skdzicombd/P_240_Autocad_Docs/P240 building fire system/P240 -BOQ.xlsx

P240
SL .No | Description | Quantity | Unit | Unit Price | Total Price
 |  |  |  | (SGD) | (SGD)
 | Fire detection system
1 | Fire Alarm Master Panel | 1 | Set
 | Model:FN-4127/220V
2 | Intelligent Photoelectric Smoke Detector, with Base | 21 | Nos
 | Model: ALN-V,YBN-NSA-4
3 | Intelligent Heat Detector | 9 | Nos
 | Model: ATG-EA
4 | Addressable Manual Call Point | 9 | Nos
 | Model: DCP-AMS
5 | Horn & Strobe (wall mounted) | 10 | Nos
 | Model: HEC3-24WR
6 | Supervised Output Module : | 3 | Sets
 | Model: SOM-A
7 | Power Supply | 1 | Sets
 | Model: FN-600X-R (220V) (6 Amp max.)
8 | Commissioning of the whole system
 | 1 Hochiki And 1 Zicom Engineer
 | App 3 days per panel
Locally
SL .No | Description | Quantity | Unit | Unit Price | Total Price | Remarks | Brand
 |  |  |  | (BDT) | (BDT)
11 | Flame Retardant Signal Cable for initiating circuit and notification appliance |  | Meter | 23.42 |  | Red & Black | Paradise Cable Ltd
 | 1C X 1.5mm2 |  |  |  |  |  | BYA 1X1.5RM(FR)
12 | Power Cable for Fire & Annunciator Panel |  | Meter | 184.57 |  |  | Paradise Cable Ltd
 | 3CX2.5mm2 (Non-Armored) |  |  |  |  |  | NYY 3X2.5RM
13 | 20A MCB |  | No | 2000.00
14 | Accessories for Cable Laying
15 | 3/4 inch PVC Pipe |  | Meter | 20.00 |  |  | Electric pipe
16 | 3/4 inch hose pipe |  | Meter | 30.00
17 | Socket |  | Nos | 25.00
18 | Elbow |  | Nos | 30.00
19 | Sedel |  | Nos | 12.00
20 | 1” Screw |  | Dozen | 17.00
21 | Royal Plug |  | Packet | 14.00
22 | Transportation Cost
