skdzicombd/P_240_Autocad_Docs/BOQ/P-240 CABLE SIZING & BOQ 17.11.15.xlsx

Sheet: COVER
 |  |  |  |  |  | CONSORTIUM OF
 |  |  |  |  |  | SINOPEC PETROLEUM ENGINEERING CORPORATION.
 |  |  |  |  |  | AND
 |  |  |  |  |  | ZICOM EQUIPMENT PTE. LTD.
BANGLADESH PETROLEUM EXPLORATION & PRODUCTION CO. LTD.
 |  |  |  |  |  | 29 Tuas Avenue 3 Singapore 639420 |  |  | Tel | : +65 6865 1765
 |  |  |  |  |  | E-mail | : zepl@zicomgroup.com |  | Fax | : +65 6865 1764
ELECTRICAL CALCULATION SHEET
 |  |  |  |  |  |  |  | Doc. No:
 |  | Job No. |  | : | 240
 |  | Client |  | : | BANGLADESH PETROLEUM EXPLORATION & PRODUCTION CO. LTD.
 |  | Location |  | : | SRIKAIL GAS FIELD, BANGLADESH
 |  | Item No. |  | : | -
 |  | Description |  | : | ELECTRICAL LOAD CALCULATION
 |  | Project Title. |  | : | 60 MMSCFD SILICA GEL DEHYDRATION TYPE GAS PROCESS PLANT
 |  | Year Built |  | : | 2015
A | 2014-02-03 |  | 2 | ISSUED FOR BIDDING |  |  |  |  | MH | SM | RHK
Rev. | Date |  | Page | Description of Revision |  |  |  |  | Prepared | Checked | Approved

Sheet: Cable Sizing
 |  |  |  |  | CABLE SIZING
USER |  |  | BANGLADESH PETROLEUM EXPLORATION & PRODUCTION CO. LTD. |  |  |  | DOC NO. |  |  | REV :
LOCATION |  |  | SRIKAIL GAS FIELD, BANGLADESH |  |  |  | SERVICE
PROJECT |  |  | 60 MMSCFD SILICA GEL DEHYDRATION TYPE GAS PROCESS PLANT |  |  |  | TAG NO. | N/A
JOB NO. |  |  | 240 |  |  |  | QUANTITY | N/A
Sl.No | TAG NO. | DISCRIPTION |  |  | CABLE SIZE (sqmm) | FROM | TO | CABLE LENGTH (METER) | KW | Cable type | REMARKS
1 | G-01 | GENERATOR 01 |  |  | 1C X 150mm2 | G1 | MCC | 260 | 276 KW
2 | G-02 | GENERATOR 02 |  |  | 1C X 150mm2 | G2 | MCC | 300 | 276 KW
3 | G-03 | GENERATOR 03 |  |  | 1C X 150mm2 | G3 | MCC | 340 | 276 KW
 | MCC PANEL CONNECTION |  |  |  | 1C X 150mm2 | MCC 1 | MCC 2 | 100
4 | GRID | NATIONAL GRID LINE |  |  | 4C X 95mm2 | GRID LINE | MCC | 200
6 |  | SPARE-1-25A |  |  | 4C X 10mm2 |  |  | 100 | 14.7 KW
7 |  | SPARE-2-50A |  |  | 4C X 16mm2 |  |  | 100 | 29.44 KW
8 |  | SPARE-3-50A |  |  | 4C X 16mm2 |  |  | 100 | 29.44 KW
9 |  | SPARE-4-50A |  |  | 4C X 16mm2 |  |  | 100 | 29.44 KW
10 |  | SPARE-5-50A |  |  | 4C X 16mm2 |  |  | 100 | 29.44 KW
11 | C-501 | UTILITY AIR COMPRESSOR LOCAL CONTROL PANEL |  |  | 4C X 10mm2 | MCC | C-501 | 105 | 15 KW
12 | C-502 | UTILITY AIR COMPRESSOR LOCAL CONTROL PANEL |  |  | 4C X 10mm2 | MCC | C-502 | 105 | 15 KW
13 | C-503 | UTILITY AIR COMPRESSOR LOCAL CONTROL PANEL |  |  | 4C X10mm2 | MCC | C-503 | 105 | 15 KW
14 |  | DOMESTIC & OFFICE USE |  |  | 4C X 35mm2 | MCC | DOMESTIC & OFFICE USE | 320 | 50 KW
15 |  | GENERATOR & MCC ROOM DISTRIBUTION PANEL |  |  | 4C X 6mm2 | MCC | GENERATOR & MCC ROOM DISTRIBUTION PANEL | 40 | 10 KW
16 | P-100A | CONDENSATE TRANSFER PUMP |  |  | 4C X 4mm2 | MCC | P-100A | 260 | 5.5 KW
 | P-100B | CONDENSATE TRANSFER PUMP |  |  | 4C X 4mm2 | MCC | P-100B | 260
17 | P-100A-LCS | CONDENSATE TRANSFER PUMP-LCS |  |  | 12C X 1.5mm2 | MCC | P-100A-LCS | 260
 | P-100B-LCS | CONDENSATE TRANSFER PUMP-LCS |  |  | 12C X 1.5mm2 | MCC | P-100B-LCS | 260
18 | P-200A | COOLING WATER PUMP |  |  | 4C X 4mm2 | MCC | P-200A | 220 | 5.5 KW
 | P-200B | COOLING WATER PUMP |  |  | 4C X 4mm2 | MCC | P-200B | 220
19 | P-200A-LCS | COOLING WATER PUMP-LCS |  |  | 12C X 1.5mm2 | MCC | P-200A-LCS | 220
 | P-200B-LCS | COOLING WATER PUMP-LCS |  |  | 12C X 1.5mm2 | MCC | P-200B-LCS | 220
20 | E-100(1) | DRY AIR COOLER |  |  | 4C X 16mm2 | MCC | E-100(1) | 190 | 22 KW
 | E-100(1)-LCS | DRY AIR COOLER-LCS |  |  | 12C X 1.5mm2 | MCC | E-100(1)-LCS | 190
21 | E-100(2) | DRY AIR COOLER |  |  | 4C X 16mm2 | MCC | E-100(2) | 190 | 22 KW
 | E-100(2)-LCS | DRY AIR COOLER-LCS |  |  | 12C X 1.5mm2 | MCC | E-100(2)-LCS | 190
22 | E-100(3) | DRY AIR COOLER |  |  | 4C X 10mm2 | MCC | E-100(3) | 200 | 15 KW
 | E-100(3)-LCS | DRY AIR COOLER-LCS |  |  | 12C X 1.5mm2 | MCC | E-100(3)-LCS | 200
23 | E-100(4) | DRY AIR COOLER |  |  | 4C X 10mm2 | MCC | E-100(4) | 200 | 15 KW
 | E-100(4)-LCS | DRY AIR COOLER-LCS |  |  | 12C X 1.5mm2 | MCC | E-100(4)-LCS | 200
24 | E-300A(1) | REGENERATION GAS COOLER |  |  | 4C X 16mm2 | MCC | E-300A(1) | 210 | 22 KW
 | E-300A(1)-LCS | REGENERATION GAS COOLER-LCS |  |  | 12C X 1.5mm2 | MCC | E-300A(1)-LCS | 210
25 | E-300A(2) | REGENERATION GAS COOLER |  |  | 4C X 10mm2 | MCC | E-300A(2) | 210 | 15 KW
 | E-300A(2)-LCS | REGENERATION GAS COOLER-LCS |  |  | 12C X 1.5mm2 | MCC | E-300A(2)-LCS | 210
26 | E-300B(1) | REGENERATION GAS COOLER |  |  | 4C X 16mm2 | MCC | E-300B(1) | 190 | 22 KW
 | E-300B(1)-LCS | REGENERATION GAS COOLER-LCS |  |  | 12C X 1.5mm2 | MCC | E-300B(1)-LCS | 190
27 | E-300B(2) | REGENERATION GAS COOLER |  |  | 4C X 10mm2 | MCC | E-300B(2) | 190 | 15 KW
 | E-300B(2)-LCS | REGENERATION GAS COOLER-LCS |  |  | 12C X 1.5mm2 | MCC | E-300B(2)-LCS | 190
28 | E-400A(1) | COOLING GAS COOLER |  |  | 4C X 16mm2 | MCC | E-400A(1) | 200 | 22 KW
 | E-400A(1)-LCS | COOLING GAS COOLER-LCS |  |  | 12C X 1.5mm2 | MCC | E-400A(1)-LCS | 200
29 | E-400A(2) | COOLING GAS COOLER |  |  | 4C X 10mm2 | MCC | E-400A(2) | 200 | 15 KW
 | E-400A(2)-LCS | COOLING GAS COOLER-LCS |  |  | 12C X 1.5mm2 | MCC | E-400A(2)-LCS | 200
30 | E-400B(1) | COOLING GAS COOLER |  |  | 4C X 16mm2 | MCC | E-400B(1) | 200 | 22 KW
 | E-400B(1)-LCS | COOLING GAS COOLER-LCS |  |  | 12C X 1.5mm2 | MCC | E-400B(1)-LCS | 200
31 | E-400B(2) | COOLING GAS COOLER |  |  | 4C X 10mm2 | MCC | E-400B(2) | 200 | 15 KW
 | E-400B(2)-LCS | COOLING GAS COOLER-LCS |  |  | 12C X 1.5mm2 | MCC | E-400B(2)-LCS | 200
32 | P-800 | KOD PUMP |  |  | 4C X 2.5mm2 | MCC | P-800 | 210 | 3 KW
 | P-800-LCS | KOD PUMP-LCS |  |  | 12C X 1.5mm2 | MCC | P-800-LCS | 210
33 | CT-100 | WET COOLER |  |  | 4C X 6mm2 | MCC | CT-100 | 210 | 11 KW
 | CT-100-LCS | WET COOLER-LCS |  |  | 12C X 1.5mm2 | MCC | CT-100-LCS | 210
34 | V-502A/B | AIR DRYER |  |  | 3C X 2.5mm2 | MCC | V-502A/B | 105 | 1 KW
35 | V-503A/B | AIR DRYER |  |  | 3C X 2.5mm2 | MCC | V-503A/B | 105 | 1 KW
36 | LCP-0801 | FLARE STACK LOCAL CONTROL PANEL |  |  | 4CX 2.5mm2 | MCC | FLARE STACK LOCAL CONTROL PANEL | 180 | 3 KW
 |  | FLARE PANEL |  |  | 3CX 2.5mm2 | FLARE LOCALCONTROL PANEL | FLARE PANEL | 40
 |  | BURN PIT PANEL |  |  | 3CX 2.5mm2 | FLARE LOCALCONTROL PANEL | BURN PIT PANEL | 40
37 | H-100 | WATER BATH HEATER |  |  | 4CX 2.5mm2 | MCC | CONTROL BUILDING | 300 | 6 KW
 |  | INSTRUMENT CABLE |  |  | 24CX 1.5mm2 | CONTROL BUILDING | H-100 | 205
 |  | INSTRUMENT CABLE |  |  | 12CX 1.5mm2 | CONTROL BUILDING | H-100 | 205
 |  | BLOWER FOR WBH |  |  | 4CX 2.5mm2 | CONTROL BUILDING | H-100 | 205
38 | H-200 | REGENERATION GAS HEATER |  |  | 4CX 2.5mm2 | MCC | CONTROL BUILDING | 300 | 6 KW
39 | P-403 | DEEP WELL PUMP |  |  | 4C X 6mm2 | MCC | P-403 | 360 | 11 KW
 | P-403-LCS | DEEP WELL PUMP -LCS |  |  | 12C X 1.5mm2 | MCC | P-403-LCS | 360
 |  | PUMP TO CONTROL PANEL(Flat Cable) |  |  | 2 (3C x 4 mm2) | PUMP CONTROL PANEL | PUMP | 500 |  | Dhaka
40 | P-404 | POTABLE WATER PUMP |  |  | 4C X 2.5mm2 | MCC | P-404 | 350 | 0.75 KW
 | P-404-LCS | POTABLE WATER PUMP-LCS |  |  | 12C X 1.5mm2 | MCC | P-404-LCS | 350
41 | P-401A | JOCKEY PUMP CONTROL PANEL |  |  | 4C X 10mm2 | MCC | P-401A | 330 | 18 KW
 | P- 401B | JOCKEY PUMP CONTROL PANEL |  |  | 4C X 10mm2 | MCC | P-401B | 330 | 18 KW
42 | P-402A | DIESEL FIRE WATER PUMP CONTROL PANEL |  |  | 4C X 2.5mm2 | MCC | P-402A | 330 | 3 KW
43 | P-402B | DIESEL FIRE WATER PUMP CONTROL PANEL |  |  | 4C X 2.5mm2 | MCC | P-402B | 330 | 3 KW
44 | P-300A | CONDENSATE RECYCLE PUMP |  |  | 4CX 2.5mm2 | MCC | P-300A | 330 | 0.75 KW
 | P-300B | CONDENSATE RECYCLE PUMP |  |  | 4CX 2.5mm2 | MCC | P-300B | 330
 | P-300A-LCS | CONDENSATE RECYCLE PUMP-LCS |  |  | 12CX1.5mm2 | MCC | P-300A-LCS | 330
 | P-300B-LCS | CONDENSATE RECYCLE PUMP-LCS |  |  | 12CX1.5mm2 | MCC | P-300B-LCS | 330
45 | P-301A | TREATED WATER TRANSFER PUMP |  |  | 4CX 2.5mm2 | MCC | P-301A | 330 | 0.75 KW
 | P-301B | TREATED WATER TRANSFER PUMP |  |  | 4CX 2.5mm2 | MCC | P-301B | 330
 | P-301A-LCS | TREATED WATER TRANSFER PUMP-LCS |  |  | 12CX1.5mm2 | MCC | P-301A-LCS | 330
 | P-301B-LCS | TREATED WATER TRANSFER PUMP-LCS |  |  | 12CX1.5mm2 | MCC | P-301B-LCS | 330
 | 02-GBC-1401 | GENERATOR BATTERY CHARGER |  |  | 3CX 4mm2 | MCC | 02-GBC-1401 | 30 | 1.5 KW
47 | 02-UPS-1201-I | UPS SYSTEM 1 |  |  | 3CX 4mm2 | MCC | UPS-1 | 300 | 6 KVA
 | 02-UPS-1202-I | UPS SYSTEM 2 |  |  | 3CX 4mm2 | MCC | UPS-2 | 300 | 6 KVA
 | 02-UPS-1201-I & 02-UPS-1202-I | UPS-1&2-DB |  |  | 3CX 4mm2 | UPS-1&2 | UPS-1&2-DB | 10
 |  | DCS PANEL |  |  | 3CX 2.5mm2 | UPS-1&2 | DCS PANEL | 70 | 400W
 |  | ENGINEERING STATION |  |  | 3CX 2.5mm2 | UPS-1&2 | ENGINEERING STATION | 50 | 400W
 |  | OPERATOR STATION 1 |  |  | 3CX 2.5mm2 | UPS-1&2 | OPERATOR STATION | 50 | 400W
 |  | OPERATOR STATION 2 |  |  | 3CX 2.5mm2 | UPS-1&2 | OPERATOR STATION | 50 | 400W
 |  | SAFETY PLC SYSTEM |  |  | 3CX 2.5mm2 | UPS-1&2 | SAFETY PLC | 20
 |  | 75" MONITOR -1 |  |  | 3CX 2.5mm2 | UPS-1&2 | 75" MONITOR -1 | 50 | 400W
 |  | 75" MONITOR -2 |  |  | 3CX 2.5mm2 | UPS-1&2 | 75" MONITOR -2 | 50 | 400W
 |  | FIELD I/O ( RIO - 0001A) |  |  | 3CX 2.5mm2 | UPS-1&2 | FIELD I/O ( RIO - 0001A) | 80 | 250W
 |  | FIELD I/O ( RIO - 0001B) |  |  | 3CX 2.5mm2 | UPS-1&2 | FIELD I/O ( RIO - 0001B) | 80 | 250W
 |  | FIELD I/O ( RIO - 0001C) |  |  | 3CX 2.5mm2 | UPS-1&2 | FIELD I/O ( RIO - 0001C) | 80 | 250W
 |  | FIELD I/O ( RIO - 0002A) |  |  | 3CX 2.5mm2 | UPS-1&2 | FIELD I/O ( RIO - 0002A) | 80 | 250W
 |  | FIELD I/O ( RIO - 0002B) |  |  | 3CX 2.5mm2 | UPS-1&2 | FIELD I/O ( RIO - 0002B) | 230 | 250W
 |  | MCC I/O ( RIO - 0003) |  |  | 3CX 2.5mm2 | UPS-1&2 | MCC I/O ( RIO - 0003) | 280 | 250W
 |  | F&G UPS - 1KVA |  |  | 3CX 2.5mm2 | UPS-1&2 | F&G UPS(UPS-3) | 20 | 1KW
 |  | PAGING & INTERCOM SYSTEM |  |  | 3CX 2.5mm2 | UPS-1&2 | PAGING | 30 | 50W
 |  | WATER BATH HEATER |  |  | 3CX 2.5mm2 | UPS-1&2 | WATER BATH HEATER | 40 | 200W
 |  | LCP ( REGENERATION GAS HEATER) |  |  | 3CX 2.5mm2 | UPS-1&2 | LCP ( REGENERATION GAS HEATER) | 40 | 200W
 |  | FLOW COMPUTER PANEL |  |  | 3CX 2.5mm2 | UPS-1&2 | FLOW COMPUTER PANEL | 50 | 52W
 |  | CCTV CAMERA |  |  | 3CX 2.5mm2 | UPS-1&2 | CCTV CAMERA | 350 | 100W
 |  | CCTV CAMERA |  |  | 3CX 2.5mm2 | UPS-1&2 | CCTV CAMERA | 350 | 100W
 |  | CCTV CAMERA |  |  | 3CX 2.5mm2 | UPS-1&2 | CCTV CAMERA | 50 | 100W
 |  | DVR NETWORKABLE |  |  | 3CX 2.5mm2 | UPS-1&2 | DVR NETWORKABLE | 50 | 68W
 |  | PRINTER |  | 1 & 2 | 3CX 2.5mm2 | UPS-1&2 | PRINTER | 50 | 150W
 |  | FIRE & GAS SYSTEM |  |  | 3CX 2.5mm2 | UPS-1&2-DB | FIRE & GAS SYSTEM | 30 | 250W
 |  | FLARE CONTROL PANEL |  |  | 3CX 2.5mm2 | UPS-1&2-DB | FLARE CONTROL PANEL | 350 | 40W
 |  | POWER CABLE FOR GC |  |  | 3CX 2.5mm2 | UPS | GC | 180 | 45W
 |  | UPS-3 |  |  | 3CX 2.5mm2 | UPS-1&2-DB | UPS-3 | 20 | 1 KW
48 | 02-UPS-1203-I | UPS-3-DB |  |  | 3CX 2.5mm2 | UPS-3 | UPS-3-DB | 10 | 100W
 |  | FIRE PANEL |  |  | 3CX 2.5mm2 | UPS-3-DB | FIRE PANEL | 40 | 50W
 |  | FIRE MIMIC PANEL |  |  | 3CX 2.5mm2 | UPS-3-DB | FIRE MIMIC PANEL | 20 | 200W
 |  | ALARM SYSTEM |  |  | 3CX 2.5mm2 | UPS-3-DB | ALARM SYSTEM | 20 | 140W
 |  | POWER SUPPLY |  |  | 3CX 2.5mm2 | UPS-3-DB | POWER SUPPLY | 10 | 18 KW
50 | LDP-1401-I | LIGHTING DISTRIBUTION PANEL |  |  | 4C X 16mm2 | MCC | LIGHT PANEL | 20 | 18 KW
 |  | TELECSCOPIC TOWER -1 |  |  | 3C X 2.5mm2 | LIGHT PANEL | TELECSCOPIC TOWER -1 | 150 | 1.2 KW
 |  | TELECSCOPIC TOWER -2 |  |  | 3C X 2.5mm2 | LIGHT PANEL | TELECSCOPIC TOWER -2 | 190 | 1.2 KW
 |  | TELECSCOPIC TOWER -3 |  |  | 3C X 2.5mm2 | LIGHT PANEL | TELECSCOPIC TOWER -3 | 220 | 1.2 KW
 |  | PIPE RACK LIGHT-1 |  |  | 3C X 2.5mm2 | LIGHT PANEL | PIPE RACK LIGHT-1 | 160 | 0.7 KW
 |  | PIPE RACK LIGHT-2 |  |  | 3C X 2.5mm2 | LIGHT PANEL | PIPE RACK LIGHT-2 | 170 | 0.5 KW
 |  | STREET LIGHT -1 |  |  | 3C X 2.5mm2 | LIGHT PANEL | STREET LIGHT -1 | 150 | 0.45 KW
 |  | STREET LIGHT -2 |  |  | 3C X 2.5mm2 | LIGHT PANEL | STREET LIGHT -2 | 70 | 0.45 KW
 |  | INSTRUMENT AIR AREA SHED LIGHT |  |  | 3C X 2.5mm2 | LIGHT PANEL | INSTRUMENT AIR AREA SHED LIGHT | 105 | 0.036 KW
 |  | TRANSFER PUMP SHED LIGHT |  |  | 3C X 2.5mm2 | LIGHT PANEL | TRANSFER PUMP SHED LIGHT | 250 | 0.036 KW
 |  | DELUGE VALVE SHED LIGHT |  |  | 3C X 2.5mm2 | LIGHT PANEL | DELUGE VALVE SHED LIGHT | 330 | 0.036 KW
 |  | FIRE WATER SHED LIGHT |  |  | 3C X 2.5mm2 | LIGHT PANEL | FIRE WATER SHED LIGHT | 330 | 0.036 KW
 |  | LOADING ARM SHED LIGHT |  |  | 3C X 2.5mm2 | LIGHT PANEL | LOADING ARM SHED LIGHT | 200 | 0.4 KW
 |  | AIR CRAFT WARNING LIGHT |  |  | 3C X 2.5mm2 | LIGHT PANEL | AIR CRAFT WARNING LIGHT | 300 | 0.05 KW
A
REV | DATE |  |  | DESCRIPTION OF REVISION |  |  |  | PREPARED | CHECKED | APPROVED

Sheet: Cable length details
 |  |  |  |  | CABLE LENGTH DETAILS
USER |  |  | BANGLADESH PETROLEUM EXPLORATION & PRODUCTION CO. LTD. |  |  |  | DOC NO. |  |  | REV :
LOCATION |  |  | SRIKAIL GAS FIELD, BANGLADESH |  |  |  | SERVICE
PROJECT |  |  | 60 MMSCFD SILICA GEL DEHYDRATION TYPE GAS PROCESS PLANT |  |  |  | TAG NO. | N/A
JOB NO. |  |  | 240 |  |  |  | QUANTITY | N/A
Sl.No | TAG NO. | DISCRIPTION |  |  | CABLE SIZE (sqmm) | FROM | TO | CABLE LENGTH (METER) |  | Cable type | REMARKS
 | G-01 | GENERATOR 01 |  |  | 1C X 150mm2 | G1 | MCC | 260
 | G-02 | GENERATOR 02 |  |  | 1C X 150mm2 | G2 | MCC | 300
 | G-03 | GENERATOR 03 |  |  | 1C X 150mm2 | G3 | MCC | 340
 | MCC PANEL CONNECTION |  |  |  | 1C X 150mm2 | MCC 1 | MCC 2 | 100
 |  | TOTAL |  |  | 1C X 150mm2 |  |  | 1000
 | GRID | NATIONAL GRID LINE |  |  | 4C X 95mm2 | GRID LINE | MCC | 200
 |  | SPARE-1-25A |  |  | 4C X 10mm2 |  |  | 100
 | C-501 | UTILITY AIR COMPRESSOR LOCAL CONTROL PANEL |  |  | 4C X 10mm2 | MCC | C-501 | 105
 | C-502 | UTILITY AIR COMPRESSOR LOCAL CONTROL PANEL |  |  | 4C X 10mm2 | MCC | C-502 | 105
 | C-503 | UTILITY AIR COMPRESSOR LOCAL CONTROL PANEL |  |  | 4C X10mm2 | MCC | C-503 | 105
 | E-300A(2) | REGENERATION GAS COOLER |  |  | 4C X 10mm2 | MCC | E-300A(2) | 210
 | E-100(4) | DRY AIR COOLER |  |  | 4C X 10mm2 | MCC | E-100(4) | 200
 | E-300B(2) | REGENERATION GAS COOLER |  |  | 4C X 10mm2 | MCC | E-300B(2) | 190
 | E-100(3) | DRY AIR COOLER |  |  | 4C X 10mm2 | MCC | E-100(3) | 200
 | E-400A(2) | COOLING GAS COOLER |  |  | 4C X 10mm2 | MCC | E-400A(2) | 200
 | E-400B(2) | COOLING GAS COOLER |  |  | 4C X 10mm2 | MCC | E-400B(2) | 200
 | P-401A | JOCKEY PUMP CONTROL PANEL |  |  | 4C X 10mm2 | MCC | P-401A | 330
 | P- 401B | JOCKEY PUMP CONTROL PANEL |  |  | 4C X 10mm2 | MCC | P-401B | 330
 |  | TOTAL |  |  | 4C X10mm2 |  |  | 2275
 |  | SPARE-2-50A |  |  | 4C X 16mm2 |  |  | 100
 |  | SPARE-3-50A |  |  | 4C X 16mm2 |  |  | 100
 |  | SPARE-4-50A |  |  | 4C X 16mm2 |  |  | 100
 |  | SPARE-5-50A |  |  | 4C X 16mm2 |  |  | 100
 | E-100(1) | DRY AIR COOLER |  |  | 4C X 16mm2 | MCC | E-100(1) | 190
 | E-100(2) | DRY AIR COOLER |  |  | 4C X 16mm2 | MCC | E-100(2) | 190
 | E-300A(1) | REGENERATION GAS COOLER |  |  | 4C X 16mm2 | MCC | E-300A(1) | 210
 | E-300B(1) | REGENERATION GAS COOLER |  |  | 4C X 16mm2 | MCC | E-300B(1) | 190
 | E-400A(1) | COOLING GAS COOLER |  |  | 4C X 16mm2 | MCC | E-400A(1) | 200
 | E-400B(1) | COOLING GAS COOLER |  |  | 4C X 16mm2 | MCC | E-400B(1) | 200
 |  | LIGHTING DISTRIBUTION PANEL |  |  | 4C X 16mm2 | MCC | LIGHT PANEL | 20
 |  | TOTAL |  |  | 4C X 16mm2 |  |  | 1600
 |  | DOMESTIC & OFFICE USE |  |  | 4C X 35mm2 | MCC | DOMESTIC & OFFICE USE | 320
 |  | TOTAL |  |  | 4C X 35mm2 |  |  | 320
 | P-403 | DEEP WELL PUMP |  |  | 4C X 6mm2 | MCC | P-403 | 360
 | CT-100 | WET COOLER |  |  | 4C X 6mm2 | MCC | CT-100 | 210
 |  | GENERATOR & MCC ROOM DISTRIBUTION PANEL |  |  | 4C X 6mm2 | MCC | GENERATOR & MCC ROOM DISTRIBUTION PANEL | 40
 |  | TOTAL |  |  | 4C X 6mm2 |  |  | 610
 | P-200A | COOLING WATER PUMP |  |  | 4C X 4mm2 | MCC | P-200A | 220
 | P-200B | COOLING WATER PUMP |  |  | 4C X 4mm2 | MCC | P-200B | 220
 | P-100A | CONDENSATE TRANSFER PUMP |  |  | 4C X 4mm2 | MCC | P-100A | 260
 | P-100B | CONDENSATE TRANSFER PUMP |  |  | 4C X 4mm2 | MCC | P-100B | 260
 |  | TOTAL |  |  | 4C X 4mm2 |  |  | 960
 | P-402B | DIESEL FIRE WATER PUMP CONTROL PANEL |  |  | 4C X 2.5mm2 | MCC | P-402B | 330
 | P-300A | CONDENSATE RECYCLE PUMP |  |  | 4CX 2.5mm2 | MCC | P-300A | 330
 | P-300B | CONDENSATE RECYCLE PUMP |  |  | 4CX 2.5mm2 | MCC | P-300B | 330
 | H-100 | BLOWER FOR WBH |  |  | 4CX 2.5mm2 | CONTROL BUILDING | H-100 | 205
 | H-100 | WATER BATH HEATER |  |  | 4CX 2.5mm2 | MCC | CONTROL BUILDING | 300
 | LCP-0801 | FLARE STACK LOCAL CONTROL PANEL |  |  | 4CX 2.5mm2 | MCC | FLARE STACK LOCAL CONTROL PANEL | 180
 | P-800 | KOD PUMP |  |  | 4C X 2.5mm2 | MCC | P-800 | 210
 | P-402A | DIESEL FIRE WATER PUMP CONTROL PANEL |  |  | 4C X 2.5mm2 | MCC | P-402A | 330
 | P-404 | POTABLE WATER PUMP |  |  | 4C X 2.5mm2 | MCC | P-404 | 350
 | P-301A | TREATED WATER TRANSFER PUMP |  |  | 4CX 2.5mm2 | MCC | P-301A | 330
 | P-301B | TREATED WATER TRANSFER PUMP |  |  | 4CX 2.5mm2 | MCC | P-301B | 330
 | H-200 | REGENERATION GAS HEATER |  |  | 4CX 2.5mm2 | MCC | CONTROL BUILDING | 300
 |  | TOTAL |  |  | 4CX 2.5mm2 |  |  | 3525
 | H-100 | INSTRUMENT CABLE |  |  | 24CX 1.5mm2 | CONTROL BUILDING | H-100 | 205
 |  | TOTAL |  |  | 24CX 1.5mm2 |  |  | 205
 | E-300A(2)-LCS | REGENERATION GAS COOLER-LCS |  |  | 12C X 1.5mm2 | MCC | E-300A(2)-LCS | 210
 | E-300B(1)-LCS | REGENERATION GAS COOLER-LCS |  |  | 12C X 1.5mm2 | MCC | E-300B(1)-LCS | 190
 | E-100(4)-LCS | DRY AIR COOLER-LCS |  |  | 12C X 1.5mm2 | MCC | E-100(4)-LCS | 200
 | E-300A(1)-LCS | REGENERATION GAS COOLER-LCS |  |  | 12C X 1.5mm2 | MCC | E-300A(1)-LCS | 210
 | E-400B(2)-LCS | COOLING GAS COOLER-LCS |  |  | 12C X 1.5mm2 | MCC | E-400B(2)-LCS | 200
 | E-300B(2)-LCS | REGENERATION GAS COOLER-LCS |  |  | 12C X 1.5mm2 | MCC | E-300B(2)-LCS | 190
 | E-400A(1)-LCS | COOLING GAS COOLER-LCS |  |  | 12C X 1.5mm2 | MCC | E-400A(1)-LCS | 200
 | E-400A(2)-LCS | COOLING GAS COOLER-LCS |  |  | 12C X 1.5mm2 | MCC | E-400A(2)-LCS | 200
 | E-400B(1)-LCS | COOLING GAS COOLER-LCS |  |  | 12C X 1.5mm2 | MCC | E-400B(1)-LCS | 200
 | P-800-LCS | KOD PUMP-LCS |  |  | 12C X 1.5mm2 | MCC | P-800-LCS | 210
 | CT-100-LCS | WET COOLER-LCS |  |  | 12C X 1.5mm2 | MCC | CT-100-LCS | 210
 | P-100A-LCS | CONDENSATE TRANSFER PUMP-LCS |  |  | 12C X 1.5mm2 | MCC | P-100A-LCS | 260
 | P-100B-LCS | CONDENSATE TRANSFER PUMP-LCS |  |  | 12C X 1.5mm2 | MCC | P-100B-LCS | 260
 | P-200A-LCS | COOLING WATER PUMP-LCS |  |  | 12C X 1.5mm2 | MCC | P-200A | 220
 | P-200B-LCS | COOLING WATER PUMP-LCS |  |  | 12C X 1.5mm2 | MCC | P-200B | 220
 | E-100(1)-LCS | DRY AIR COOLER-LCS |  |  | 12C X 1.5mm2 | MCC | E-100(1)-LCS | 190
 | E-100(2)-LCS | DRY AIR COOLER-LCS |  |  | 12C X 1.5mm2 | MCC | E-100(2)-LCS | 190
 | E-100(3)-LCS | DRY AIR COOLER-LCS |  |  | 12C X 1.5mm2 | MCC | E-100(3)-LCS | 200
 | H-100 | INSTRUMENT CABLE |  |  | 12CX 1.5mm2 | CONTROL BUILDING | H-100 | 205
 | P-301A-LCS | TREATED WATER TRANSFER PUMP-LCS |  |  | 12CX1.5mm2 | MCC | P-301A-LCS | 330
 | P-301B-LCS | TREATED WATER TRANSFER PUMP-LCS |  |  | 12CX1.5mm2 | MCC | P-301B-LCS | 330
 | P-403-LCS | DEEP WELL PUMP -LCS |  |  | 12C X 1.5mm2 | MCC | P-403-LCS | 360
 | P-300A-LCS | CONDENSATE RECYCLE PUMP-LCS |  |  | 12CX1.5mm2 | MCC | P-300A-LCS | 330
 | P-300B-LCS | CONDENSATE RECYCLE PUMP-LCS |  |  | 12CX1.5mm2 | MCC | P-300B-LCS | 330
 | P-404-LCS | POTABLE WATER PUMP-LCS |  |  | 12C X 1.5mm2 | MCC | P-404-LCS | 350
 |  | TOTAL |  |  | 12C X 1.5mm2 |  |  | 5995
 |  | PUMP TO CONTROL PANEL(Flat Cable) |  |  | 2 (3C x 4 mm2) | PUMP CONTROL PANEL | PUMP | 500
 |  | TOTAL |  |  | 2 (3C x 4 mm2) |  |  | 500
 | 02-GBC-1401 | GENERATOR BATTERY CHARGER |  |  | 3CX 4mm2 | MCC | 02-GBC-1401 | 30
 | 02-UPS-1201-I | UPS SYSTEM 1 |  |  | 3CX 4mm2 | MCC | UPS-1 | 300
 | 02-UPS-1202-I | UPS SYSTEM 2 |  |  | 3CX 4mm2 | MCC | UPS-2 | 300
 | 02-UPS-1201-I & 02-UPS-1202-I | UPS-1&2-DB |  |  | 3CX 4mm2 | UPS-1&2 | UPS-1&2-DB | 10
 |  | TOTAL |  |  | 3CX 4mm2 |  |  | 640
 | V-502A/B | AIR DRYER |  |  | 3C X 2.5mm2 | MCC | V-502A/B | 105
 | V-503A/B | AIR DRYER |  |  | 3C X 2.5mm2 | MCC | V-503A/B | 105
 | LCP-0801 | FLARE PANEL |  |  | 3CX 2.5mm2 | FLARE LOCALCONTROL PANEL | FLARE PANEL | 40
 | LCP-0801 | BURN PIT PANEL |  |  | 3CX 2.5mm2 | FLARE LOCALCONTROL PANEL | BURN PIT PANEL | 40
 | 02-UPS-1201-I & 02-UPS-1202-I | DCS PANEL |  |  | 3CX 2.5mm2 | UPS-1&2 | DCS PANEL | 70
 |  | ENGINEERING STATION |  |  | 3CX 2.5mm2 | UPS-1&2 | ENGINEERING STATION | 50
 |  | OPERATOR STATION 1 |  |  | 3CX 2.5mm2 | UPS-1&2 | OPERATOR STATION | 50
 |  | OPERATOR STATION 2 |  |  | 3CX 2.5mm2 | UPS-1&2 | OPERATOR STATION | 50
 |  | SAFETY PLC SYSTEM |  |  | 3CX 2.5mm2 | UPS-1&2 | SAFETY PLC | 20
 |  | 75" MONITOR -1 |  |  | 3CX 2.5mm2 | UPS-1&2 | 75" MONITOR -1 | 50
 |  | 75" MONITOR -2 |  |  | 3CX 2.5mm2 | UPS-1&2 | 75" MONITOR -2 | 50
 |  | FIELD I/O ( RIO - 0001A) |  |  | 3CX 2.5mm2 | UPS-1&2 | FIELD I/O ( RIO - 0001A) | 80
 |  | FIELD I/O ( RIO - 0001B) |  |  | 3CX 2.5mm2 | UPS-1&2 | FIELD I/O ( RIO - 0001B) | 80
 |  | FIELD I/O ( RIO - 0001C) |  |  | 3CX 2.5mm2 | UPS-1&2 | FIELD I/O ( RIO - 0001C) | 80
 |  | FIELD I/O ( RIO - 0002A) |  |  | 3CX 2.5mm2 | UPS-1&2 | FIELD I/O ( RIO - 0002A) | 80
 |  | FIELD I/O ( RIO - 0002B) |  |  | 3CX 2.5mm2 | UPS-1&2 | FIELD I/O ( RIO - 0002B) | 230
 |  | MCC I/O ( RIO - 0003) |  |  | 3CX 2.5mm2 | UPS-1&2 | MCC I/O ( RIO - 0003A) | 280
 |  | F&G UPS - 1KVA |  |  | 3CX 2.5mm2 | UPS-1&2 | F&G UPS(UPS-3) | 20
 |  | PAGING & INTERCOM SYSTEM |  |  | 3CX 2.5mm2 | UPS-1&2 | PAGING | 30
 |  | WATER BATH HEATER |  |  | 3CX 2.5mm2 | UPS-1&2 | WATER BATH HEATER | 40
 |  | LCP ( REGENERATION GAS HEATER) |  |  | 3CX 2.5mm2 | UPS-1&2 | LCP ( REGENERATION GAS HEATER) | 40
 |  | FLOW COMPUTER PANEL |  |  | 3CX 2.5mm2 | UPS-1&2 | FLOW COMPUTER PANEL | 50
 |  | CCTV CAMERA |  |  | 3CX 2.5mm2 | UPS-1&2 | CCTV CAMERA | 350
 |  | CCTV CAMERA |  |  | 3CX 2.5mm2 | UPS-1&2 | CCTV CAMERA | 350
 |  | CCTV CAMERA |  |  | 3CX 2.5mm2 | UPS-1&2 | CCTV CAMERA | 50
 |  | DVR NETWORKABLE |  |  | 3CX 2.5mm2 | UPS-1&2 | DVR NETWORKABLE | 50
 |  | PRINTER |  | 1 & 2 | 3CX 2.5mm2 | UPS-1&2 | PRINTER | 50
 |  | FIRE & GAS SYSTEM |  |  | 3CX 2.5mm2 | UPS-1&2-DB | FIRE & GAS SYSTEM | 30
 |  | FLARE CONTROL PANEL |  |  | 3CX 2.5mm2 | UPS-1&2-DB | FLARE CONTROL PANEL | 350
 |  | POWER CABLE FOR GC |  |  | 3CX 2.5mm2 | UPS | GC | 180
 |  | UPS-3 |  |  | 3CX 2.5mm2 | UPS-1&2-DB | UPS-3 | 20
 | 02-UPS-1203-I | UPS-3-DB |  |  | 3CX 2.5mm2 | UPS-3 | UPS-3-DB | 10
 |  | FIRE PANEL |  |  | 3CX 2.5mm2 | UPS-3-DB | FIRE PANEL | 40
 |  | FIRE MIMIC PANEL |  |  | 3CX 2.5mm2 | UPS-3-DB | FIRE MIMIC PANEL | 20
 |  | ALARM SYSTEM |  |  | 3CX 2.5mm2 | UPS-3-DB | ALARM SYSTEM | 20
 |  | POWER SUPPLY |  |  | 3CX 2.5mm2 | UPS-3-DB | POWER SUPPLY | 10
 |  | TELECSCOPIC TOWER -1 |  |  | 3C X 2.5mm2 | LIGHT PANEL | TELECSCOPIC TOWER -1 | 150
 |  | TELECSCOPIC TOWER -2 |  |  | 3C X 2.5mm2 | LIGHT PANEL | TELECSCOPIC TOWER -2 | 190
 |  | TELECSCOPIC TOWER -3 |  |  | 3C X 2.5mm2 | LIGHT PANEL | TELECSCOPIC TOWER -3 | 220
 |  | PIPE RACK LIGHT-1 |  |  | 3C X 2.5mm2 | LIGHT PANEL | PIPE RACK LIGHT-1 | 160
 |  | PIPE RACK LIGHT-2 |  |  | 3C X 2.5mm2 | LIGHT PANEL | PIPE RACK LIGHT-2 | 170
 |  | STREET LIGHT -1 |  |  | 3C X 2.5mm2 | LIGHT PANEL | STREET LIGHT -1 | 150
 |  | STREET LIGHT -2 |  |  | 3C X 2.5mm2 | LIGHT PANEL | STREET LIGHT -2 | 70
 |  | INSTRUMENT AIR AREA SHED LIGHT |  |  | 3C X 2.5mm2 | LIGHT PANEL | INSTRUMENT AIR AREA SHED LIGHT | 105
 |  | TRANSFER PUMP SHED LIGHT |  |  | 3C X 2.5mm2 | LIGHT PANEL | TRANSFER PUMP SHED LIGHT | 250
 |  | DELUGE VALVE SHED LIGHT |  |  | 3C X 2.5mm2 | LIGHT PANEL | DELUGE VALVE SHED LIGHT | 330
 |  | FIRE WATER SHED LIGHT |  |  | 3C X 2.5mm2 | LIGHT PANEL | FIRE WATER SHED LIGHT | 330
 |  | LOADING ARM SHED LIGHT |  |  | 3C X 2.5mm2 | LIGHT PANEL | LOADING ARM SHED LIGHT | 200
 |  | AIR CRAFT WARNING LIGHT |  |  | 3C X 2.5mm2 | LIGHT PANEL | AIR CRAFT WARNING LIGHT | 300
 |  | TOTAL |  |  | 3C X 2.5mm2 |  |  | 5795
A
REV | DATE |  |  | DESCRIPTION OF REVISION |  |  |  | PREPARED | CHECKED | APPROVED

Sheet: Cable Length Summary
 |  |  |  |  | CABLE LENGTH SUMMARY
USER |  |  | BANGLADESH PETROLEUM EXPLORATION & PRODUCTION CO. LTD. |  |  |  | DOC NO. |  |  | REV :
LOCATION |  |  | SRIKAIL GAS FIELD, BANGLADESH |  |  |  | SERVICE
PROJECT |  |  | 60 MMSCFD SILICA GEL DEHYDRATION TYPE GAS PROCESS PLANT |  |  |  | TAG NO. | N/A
JOB NO. |  |  | 240 |  |  |  | QUANTITY | N/A
Sl.No | TAG NO. | DISCRIPTION |  |  | CABLE SIZE (sqmm) | FROM | TO | CABLE LENGTH (METER) | KW | REMARKS
1 |  | Armoured Power cable |  |  | 3CX 2.5mm2 |  |  | 5795
2 |  | Armoured Power cable |  |  | 3CX 4mm2 |  |  | 640
3 |  | Armoured Power cable |  |  | 4CX 2.5mm2 |  |  | 3525
4 |  | Armoured Power cable |  |  | 4CX 4mm2 |  |  | 960
5 |  | Armoured Power cable |  |  | 4CX 6mm2 |  |  | 610
6 |  | Armoured Power cable |  |  | 4CX 10mm2 |  |  | 2275
7 |  | Armoured Power cable |  |  | 4CX 16mm2 |  |  | 1600
9 |  | Armoured Power cable |  |  | 12CX1.5mm2 |  |  | 5995
10 |  | Armoured Power cable |  |  | 24CX 1.5mm2 |  |  | 205
11 |  | Armoured Power cable |  |  | 3C x 4 mm2(Flat) |  |  | 500
 |  | Armoured Power cable |  |  | 4C x 35 mm2 |  |  | 320
12 |  | Armoured Power cable |  |  | 1C X 150 mm2 |  |  | 1000
 |  | Armoured Power cable |  |  | 4C X 95 mm2 |  |  | 200
A
REV | DATE |  |  | DESCRIPTION OF REVISION |  |  |  | PREPARED | CHECKED | APPROVED

Sheet: BOQ
MASTER BOQ 60 MMSCFD SILICAGEL DEHYDRATION TYPE GAS PROCESS PLANTT BAPEX
Sl.No | Category | Description of Materials |  |  | Quantity | Unit | PO Issued | Remarks
 |  | Equipment
1. | Generators | 276KW, 400/230 VAC, 3 phase 4 wire, 50Hz |  |  | 3 | Sets
 |  | 0.8PF, 1500RPM
 |  | Model No: PG345B3
 |  | Complete with all accessories
2. | CompressorSkid
2.1 | Compressor | Rotory fuel injected. 15HP. Max Working pressure=13bar |  |  | 3 | Sets
 |  | Tag Numbers: C-501, C-502, C-503, Model Number: GA 15+
2.2 | Air Dryer | Model: CD 40+ |  |  | 2 | Nos
2.3 | Pre Filter | PD 50+ (2nos), DD50+ (2nos) |  |  | 2 | Sets
2.4 | After Filter | DDp50+ |  |  | 2 | Nos
3.0 | MCC Room | Incoming Panel | Feeder (Incoming Panel) | Feeder (Incoming Panel) | 1 | Nos
 |  | MCC Panel | MCC Panel | MCC Panel | 1 | Set
 |  | PFI Panel | PFI Panel | PFI Panel | 1 | Nos
 |  | Light Distribution Panel | Light Distribution Panel | Light Distribution Panel | 1 | Nos
 |  | Battery Charger 12 volt & 24 Volt, 20Amp |  |  | 1 | Nos
 |  | Distribution Panel for Generation Building | Distribution Panel for generation Building | Distribution Panel for generation Building | 1 | Nos |  |  | At Dhaka. (PSI not needed)
 |  | Star Delta motor starter panel for P-403 |  |  | 1 | Nos |  |  | At Dhaka. (PSI not needed)
 |  | HVAC Distibution Box |  |  | 1 | Nos
4.0 | Control Building | Distribution Panel for Control Building | Distribution Panel for Operation Building | Distribution Panel for Operation Building | 2 | Nos |  |  | At Dhaka. (PSI not needed)
 |  | UPS(6kVA) | UPS(6kVA) | UPS(6kVA) | 2 | Nos
 |  | UPS(1kVA) For Fire and Gas | UPS(1kVA) | UPS(1kVA) | 1 | Nos
 |  | UPS Power Distribution Box |  |  | 2 | Nos |  |  | Newly Added
5.0 | Lighting System | Telescopic light Height 15 meter with fitting fixing accessories. ( 3 Nos. 400 W light in each pole) | TOWER LIGHT(200W light | TOWER LIGHT(200W light | 3 | Sets
 |  | Plant Street Light Poles height 5 meter with fittings fixing accessories. (1 No. 150 W Light in each ) |  |  | 6
 |  | Pipe Rack Light (100W light) | PIPE RACK LIGHT (100W light) | PIPE RACK LIGHT (100W light) | 16 | Nos
 |  | Air-Craft Warning Light for flare (50W light) | AIR-CRAFT WARNING LIGHT (50W light) | AIR-CRAFT WARNING LIGHT (50W light) | 1 | Nos
 |  | Shed Light (2 No.18W each light) explosion proof | SHED LIGHT (2 No.36W each light) | SHED LIGHT (2 No.36W each light) | 10 | Nos
 |  | Loading Area Shed Light (200W each light) explosion proof | LOADING AREA SHED LIGHT (200W each light) | LOADING AREA SHED LIGHT (200W each light) | 2 | Nos
 |  | Surge protection Device Three Phase (Type 1 SPD) | Surge protection Device | Surge protection Device | 2 | Nos
 |  | Surge protection Device Single Phase (Type 1 SPD) | Surge protection Device | Surge protection Device | 3 | Nos
 |  | Emergency Light With Power Battery |  |  | 12 | Nos
 | Cathodic Protection
6.0 |  | Cathodic Protection for Condensate Tank | Cathodic Protection | Cathodic Protection | 1 | lot |  |  | Details BOQ Required
6.1 |  | Cathodic Protection for Underground Pipe | Cathodic Protection | Cathodic Protection | 1 | lot |  |  | Details BOQ Required
7.0 | LCS | LCS (Local Control Station) | LCS without selector switch | LCS without selector switch | 6 | pcs |  |  | Datasheet needed
7.1 |  | LCS (Local Control Station) with Three Position selector switch. | LCS with selector switch | LCS with selector switch | 22 | pcs |  |  | Datasheet needed
 | plug and Socket | explosion proof receptacles 3 phase 25amp 4 pin (With Box) |  |  | 1 | pc
 | plug and Socket | explosion proof receptacles 3 phase 50amp 4 pin (With Box) |  |  | 4 | pcs
8.0 | Grounding Systems | Grounding Cable for Generator 1 ,Size 95 sqmm, RM ( two boring ) | Grounding Cable for Generator 1 ,Size 95 RM ( two boring ) | Grounding Cable for Generator 1 ,Size 95 RM ( two boring ) | 133 | meter
8.1 |  | Grounding Cable for Generator 2 ,Size 95 sqmm RM ( two boring ) | Grounding Cable for Generator 2 ,Size 95 RM ( two boring ) | Grounding Cable for Generator 2 ,Size 95 RM ( two boring ) | 133 | meter
8.2 |  | Grounding Cable for Generator 3 ,Size 95 sqmm RM ( two boring ) | Grounding Cable for Generator 2 ,Size 95 RM ( two boring ) | Grounding Cable for Generator 2 ,Size 95 RM ( two boring ) | 133 | meter
8.3 |  | Grounding Cable for MCC Room Size 95 sqmm RM ( two boring ) | Grounding Cable for MCC Room Size 95 RM ( two boring ) | Grounding Cable for MCC Room Size 95 RM ( two boring ) | 133 | meter
8.4 |  | Grounding Cable for Control Panel Size 95 sqmm RM ( two boring ) | Grounding Cable for Control Panel Size 95 RM ( two boring ) | Grounding Cable for Control Panel Size 95 RM ( two boring ) | 133 | meter
8.5 |  | Grounding Cable for Flare Stack Size 95 sqmm RM ( Two boring ) | Grounding Cable for Flare Stack Size 95 RM ( Two boring ) | Grounding Cable for Flare Stack Size 95 RM ( Two boring ) | 133 | meter
8.6 |  | Grounding Cable for Loading Station Size 95 sqmm RM ( Two boring ) | Grounding Cable for Loading Station Size 95 RM ( Two boring ) | Grounding Cable for Loading Station Size 95 RM ( Two boring ) | 133 | meter
8.7 |  | Grounding Cable for Tank Size 95 sqmm RM ( Two boring ) | Grounding Cable for Tank Size 95 RM ( Two boring ) | Grounding Cable for Tank Size 95 RM ( Two boring ) | 133 | meter
8.8 |  | Grounding Cable for Condensate Pump Size 95 sqmm RM ( One boring ) | Grounding Cable for Condenset Pump Size 95 RM ( One boring ) | Grounding Cable for Condenset Pump Size 95 RM ( One boring ) | 10 | meter
8.9 |  | Grounding Cable for Fire Water Pump Sheed Size 95 sqmm RM ( One boring ) | Grounding Cable for Fire Water Pump Sheed Size 95 RM ( One boring ) | Grounding Cable for Fire Water Pump Sheed Size 95 RM ( One boring ) | 10 | meter
8.10 |  | Skid inter-connection Cable, PVC Insulated Cable Size 16 sqmm RM | Skid inter-connection Cable, PVC Insulated Cable Size 16 RM | Skid inter-connection Cable, PVC Insulated Cable Size 16 RM | 500 | meter
8.11 |  | Grounding Cable for Lightning Protection Size 95 sqmm RM ( Six boring ) | Grounding Cable for Fire Water Pump Sheed Size 95 RM ( One boring ) | Grounding Cable for Fire Water Pump Sheed Size 95 RM ( One boring ) | 240 | meter
8.12
8.13 |  | Solid Copper Rod (8mm Dia) for MCC & Generator Building Top | Solid Copper Rod (8mm Dia) for MCC & Generator Building Top | Solid Copper Rod (8mm Dia) for MCC & Generator Building Top | 50 | meter
8.14 |  | Solid Copper Rod (8mm Dia) for Control Building Top | Solid Copper Rod (8mm Dia) for Control Building Top | Solid Copper Rod (8mm Dia) for Control Building Top | 50 | meter
8.15 |  | Solid Copper Rod (8mm Dia) for Transfer Pump Shed Top | Solid Copper Rod (8mm Dia) for Transfer Pump Shed Top | Solid Copper Rod (8mm Dia) for Transfer Pump Shed Top | 15 | meter
8.16 |  | Solid Copper Rod (8mm Dia) for Recycle Pump Shed Top | Solid Copper Rod (8mm Dia) for Recycle Pump Shed Top | Solid Copper Rod (8mm Dia) for Recycle Pump Shed Top | 40 | meter
8.17 |  | Solid Copper Rod (8mm Dia) for Fire Water Pump Shed Top | Solid Copper Rod (8mm Dia) for Fire Water Pump Shed Top | Solid Copper Rod (8mm Dia) for Fire Water Pump Shed Top | 50 | meter
8.18 |  | Solid Copper Rod (8mm Dia) for Loading Area Shed Top | Solid Copper Rod (8mm Dia) for Loading Area Shed Top | Solid Copper Rod (8mm Dia) for Loading Area Shed Top | 50 | meter
8.19 |  | Solid Copper Rod (8mm Dia) for Fome tank Shed Top | Solid Copper Rod (8mm Dia) for Loading Area Shed Top | Solid Copper Rod (8mm Dia) for Loading Area Shed Top | 50 | meter
8.20 |  | Solid Copper Rod (8mm Dia) for Deluge Valve Shelter Shed Top | Solid Copper Rod (8mm Dia) for Loading Area Shed Top | Solid Copper Rod (8mm Dia) for Loading Area Shed Top | 50 | meter
8.21 |  | Grounding Rod, Each two meter length, Dia. 25mm | Grounding Rod, Each two meter length | Grounding Rod, Each two meter length | 55 | Nos
8.22 |  | 5m Static Grounding Clamp 40mm Jaw Opening. (For Loading Station) | 5m Static Grounding Clamp 40mm Jaw Opening. | 5m Static Grounding Clamp 40mm Jaw Opening. | 2 | Nos |  |  | RS Component
8.23 |  | Joint connector Nut & Bolt (25mm dia to 95sqmm cable) | Joint Nut & Bolt 8mm Dia ( Short Length ) | Joint Nut & Bolt 8mm Dia ( Short Length ) | 55 | Nos
8.24 |  | Copper Nut Bolt with washer |  |  | 100 | Nos
 | Earthing Pit | Earthing cable termination Busbar with hole(14mm). Busbar Size: L=250mm, W=75mm, T=8mm |  |  | 20 | Nos
 |  | Busbar mounting Isolator with threaded bolt. Size: H=60mm, D1=40mm, M8, A=20mm |  |  | 40 | Nos
 |  | Copper Nut Bolt with washer. Size: L=40mm, OD=10mm, |  |  | 50 | Nos
9.0 | Cable Tray | Cable Tray With Cover Size 600 X 250(H) for Power Cable (Each 3 meter length) |  |  | 15 | Nos
9.1 |  | Cable Tray With Cover Size 400 X 250(H) for Instrumentation Cable (Each 3 meter length) | Cable tray 400x150 | Cable tray 400x150 | 25 | Nos
9.2 |  | Cable Tray With Cover Size 400 X 150(H) for Instrumentation Cable (Each 3 meter length) | Cable tray 400x150 | Cable tray 400x150 | 30 | Nos
9.3 |  | Cable Tray With Cover Size 150 X 100(H) for Instrumentation Cable (Each 3 meter length) | Cable tray 400x150 | Cable tray 400x150 | 40 | Nos
9.4 |  | Elbow 600 X 250(H) X 600 for Cable Tray Size 600 X 2~~5~~0(H) | Cable tray 400x150 | Cable tray 400x150 | 8 | Nos
9.5 |  | Unequal Tee 600 X 400 X 600 for Cable Tray Size 600 X 250(H) & 400 X 250 (H) | Cable tray 400x150 | Cable tray 400x150 | 3 | Nos
9.6 |  | Unequal Tee 600 X 400 X 400 for Cable Tray Size 600 X 250(H) & 400 X 250 (H) | Cable tray 400x150 | Cable tray 400x150 | 2 | Nos
9.7 |  | Flexible Riser 600 X 250(H) X 600 for Cable Tray Size 600 X 250(H) | Cable tray 400x150 | Cable tray 400x150 | 4 | Nos |  |  | 90 Deg Vertical Outside Bend
 |  | Flexible Riser 600 X 250(H) X 600 for Cable Tray Size 600 X 250(H) | Cable tray 400x150 | Cable tray 400x150 | 4 | Nos |  |  | 90 Deg Vertical Insitde Bend
9.8 |  | Reducer 600 X 400 for Cable Tray Size 600 X 250(H) |  |  | 1 | Nos
9.9 |  | Elbow 400 X 250(H) X 400 for Cable Tray Size 400 X 2~~5~~0(H) | Cable tray 400x150 | Cable tray 400x150 | 4 | Nos
9.10 |  | Equal Tee 400 X 400 X 400 for Cable Tray Size 400 X 250(H) |  |  | 8 | Nos
9.11 |  | Flexible Riser 400 X 400 for Cable Tray Size 400 X 250(H) | Cable tray 400x150 | Cable tray 400x150 | 4 | Nos |  |  | 90 Deg Vertical Outside Bend
 |  | Flexible Riser 400 X 400 for Cable Tray Size 400 X 250(H) | Cable tray 400x150 | Cable tray 400x150 | 4 | Nos |  |  | 90 Deg Vertical Insitde Bend
9.12 |  | Elbow 400 X 150(H) X 400 for Cable Tray Size 400 X 1~~5~~0(H) | Cable tray 400x150 | Cable tray 400x150 | 4 | Nos
9.13 |  | Equal Tee 400 X 400 X 400 for Cable Tray Size 400 X 150(H) |  |  | 8 | Nos
9.14 |  | Flexible Riser 400 X 400 for Cable Tray Size 400 X 150(H) | Cable tray 400x150 | Cable tray 400x150 | 4 | Nos |  |  | 90 Deg Vertical Outside Bend
 |  | Flexible Riser 400 X 400 for Cable Tray Size 400 X 150(H) | Cable tray 400x150 | Cable tray 400x150 | 4 | Nos |  |  | 90 Deg Vertical Insitde Bend
9.15 |  | Unequal Tee 400 X 150 X 400 for Cable Tray Size 400 X 150(H) | Cable tray 400x150 | Cable tray 400x150 | 10 | Nos
9.16 |  | Elbow 150 X 100(H) X 150 for Cable Tray Size 150 X 100(H) | Cable tray 400x150 | Cable tray 400x150 | 20 | Nos
9.17 |  | Equal Tee 150 X 100(H) X 150 for Cable Tray Size 150 X 100(H) |  |  | 20 | Nos
9.18 |  | Flexible Riser 150 X 100(H) X 150 for Cable Tray Size 150 X 100(H) | Cable tray 400x150 | Cable tray 400x150 | 20 | Nos |  |  | 90 Deg Vertical Outside Bend
 |  | Flexible Riser 150 X 100(H) X 150 for Cable Tray Size 150 X 100(H) | Cable tray 400x150 | Cable tray 400x150 | 20 | Nos |  |  | 90 Deg Vertical Insitde Bend
9.19 |  | Cable Tray Joint Plate For Cable Tray Size 600 X 250(H) |  |  | 60 | Nos
9.20 |  | Cable Tray Joint Plate For Cable Tray Size 400 X 250(H) |  |  | 70 | Nos
9.21 |  | Cable Tray Joint Plate For Cable Tray Size 400 X 150(H) |  |  | 60 | Nos
9.22 |  | Cable Tray Joint Plate For Cable Tray Size 150 X 100(H) |  |  | 130 | Nos
9.23 |  | Cable Tray Joint Nut & Bolt With Washer For Cable Tray Size 600 X 250(H) |  |  | 350 | Nos
9.24 |  | Cable Tray Joint Nut & Bolt With Washer For Cable Tray Size 400 X 250(H) |  |  | 500 | Nos
9.25 |  | Cable Tray Joint Nut & Bolt With Washer For Cable Tray Size 400 X 150(H) |  |  | 800 | Nos
9.26 |  | Cable Tray Joint Nut & Bolt With Washer For Cable Tray Size 150 X 100(H) |  |  | 1000 | Nos
9.27 |  | Flex Strap Thief Hatch Bonding Kit, Tin Coted, Size 200 mm [L] X 20 mm [W] with 10 mm Hole at Both End |  |  | 200 | Nos
10.0 |  | GI PIPE & FITTINGS
10.1 | GI Pipe | GI Pipe ,Size 1'' For Tower Light-1 |  |  | 20 | meter
10.2 |  | GI Pipe ,Size 1'' For Tower Light-2 |  |  | 20 | meter
10.3 |  | GI Pipe ,Size 1'' For Tower Light-3 |  |  | 20 | meter
10.4 |  | GI Pipe ,Size 2'' For Pipe Rack Light |  |  | 200 | meter
10.5 |  | GI Pipe ,Size 1'' For Transfer Pump shed light |  |  | 20 | meter
10.6 |  | GI Pipe ,Size 1'' For Recycle Pump Shed light, |  |  | 20 | meter
10.7 |  | GI Pipe ,Size 1'' For Fire Water Pump Shed Light |  |  | 20 | meter
10.8 |  | GI Pipe ,Size 1 '' For Air-Craft Shed Light, |  |  | 250 | meter
10.9 |  | GI Pipe ,Size 1'' For Loading Area Shed Light |  |  | 60 | meter
10.10 |  | GI Pipe ,Size 1 1/2'' For Inlet Air Cooler,( Motor, LCS ) |  |  | 200 | meter
10.11 |  | GI Pipe ,Size 1 1/2'' For Cooling Tower,( Motor, LCS ) |  |  | 80 | meter
10.12 |  | GI Pipe ,Size 1'' For WBH,(Power) |  |  | 20 | meter
10.13 |  | GI Pipe ,Size 2'' For WBH,(JB) |  |  | 20 | meter
10.14 |  | GI Pipe ,Size 1'' For Regeneration Gas Heater(Power) |  |  | 20 | meter
10.15 |  | GI Pipe ,Size 2'' For Regeneration Gas Heater(JB) |  |  | 20 | meter
 |  | GI Pipe ,Size 2'' For F & G System |  |  | 200 | meter
 | GI fittings
11.0 |  | GI Elbow ,Size 2'' |  |  | 60 | Nos
11.1 |  | GI Union ,Size 2'' |  |  | 30 | Nos
11.2 |  | GI Tee, Size 2'' |  |  | 30 | Nos
11.3 |  | GI Socket, Size 2'' | GI Socket, Size 1'' | GI Socket, Size 1'' | 40 | Nos
11.4 |  | GI Elbow ,Size 1'' |  |  | 70 | Nos
11.5 |  | GI Union ,Size 1'' |  |  | 30 | Nos
11.6 |  | GI Tee, Size 1'' |  |  | 80 | Nos
11.7 |  | GI Socket, Size 1'' |  |  | 40 | Nos
12.0 | Cable Lugs | Ring lugs 1.5mm2 |  |  | 1000 | pcs
12.1 |  | Ring lugs 2.5mm2 |  |  | 400 | pcs
12.2 |  | Ring lugs 4mm2 |  |  | 200 | pcs
12.3 |  | Ring lugs 6mm2 |  |  | 150 | pcs
12.4 |  | Ring lugs 10mm2 |  |  | 200 | pcs
12.5 |  | Ring lugs 16mm2 |  |  | 150 | pcs
12.6 |  | Ring lugs 35mm2 |  |  | 50 | pcs
12.7 |  | Ring lugs 150mm2 for Generator |  |  | 60 | pcs
12.8 |  | Ring lugs 300mm2 for National Grid Line |  |  | 15 | pcs
12.9 |  | I lugs 1.5 mm2 for others use |  |  | 500 | pcs
12.10 |  | I lugs 2 mm2 for others use |  |  | 200 | pcs
12.11 |  | I lugs 2.5 mm2 for others use |  |  | 400 | pcs
12.12 |  | I lugs 4 mm2 for others use |  |  | 200 | pcs
12.13 |  | I lugs 6 mm2 for others use |  |  | 300 | pcs
12.14 |  | Y lugs 2.5 mm2 for others use |  |  | 300 | pcs
12.15 |  | Y lugs 4 mm2 for others use |  |  | 200 | pcs
12.16 |  | Y lugs 6 mm2 for others use |  |  | 300 | pcs
12.17 |  | Ring lugs 16 mm2 for Grounding |  |  | 100 | pcs
13.0 | PVC Tape | PVC Tape,size:3/4''(RED) |  |  | 150 | pcs
13.1 |  | PVC Tape,size:3/4''(YELLOW) |  |  | 150 | pcs
13.2 |  | PVC Tape,size:3/4''(BLUE) | PVC Tape,size:3/4''(BLUE) | PVC Tape,size:3/4''(BLUE) | 150 | pcs
13.3 |  | PVC Tape,size:3/4''(BLACK) | PVC Tape,size:3/4''(BLACK) | PVC Tape,size:3/4''(BLACK) | 150 | pcs
13.4 |  | PIB Tape | PIB Tape | PIB Tape | 20 | pcs
14.0 | Shrink Tube | 1.5 inch Red color |  |  | 5 | meter
14.1 |  | 1.5 inch Yellow color |  |  | 5 | meter
14.2 |  | 1.5 inch Blue color |  |  | 5 | meter
14.3 |  | 1.5 inch Black color |  |  | 5 | meter
14.4 |  | 1 inch Red color |  |  | 5 | meter
14.5 |  | 1 inch Yellow color |  |  | 3 | meter
14.6 |  | 1 inch Blue color |  |  | 3 | meter
14.7 |  | 1 inch Black color |  |  | 3 | meter
14.8 |  | 1/2 inch Red color |  |  | 3 | meter
14.9 |  | 1/2 inch Yellow color |  |  | 3 | meter
14.10 |  | 1/2 inch Blue color |  |  | 3 | meter
14.11 |  | 1/2 inch Black color |  |  | 3 | meter
14.12 |  | 3/4 inch Red color |  |  | 3 | meter
14.13 |  | 3/4 inch Yellow color |  |  | 3 | meter
14.14 |  | 3/4 inch Blue color |  |  | 3 | meter
14.15 |  | 3/4 inch Black color |  |  | 3 | meter
14.16 |  | 1/4 inch Red color |  |  | 3 | meter
14.17 |  | 1/4 inch Yellow color |  |  | 3 | meter
14.18 |  | 1/4 inch Blue color |  |  | 3 | meter
14.19 |  | 1/4 inch Black color |  |  | 3 | meter
15.0 |  | Metal Gland for Field Side
15.1 | Cable Gland | 3/4'' NPT for Utility Air Compressour (4C X 10mm2), OD:21mm |  |  | 1 | Nos |  | RAD 2 | Information
15.2 |  | 1/2'' NPT for Air Dryer (3C X 2.5mm2), OD:14.6mm |  |  | 1 | Nos |  | RAD 1 | Information
15.3 |  | 3/4'' NPT for Cooling Water Pump P-200A/B (4C X 4mm2) OD:16.8mm |  |  | 1 | Nos |  | RAD 2 | Information
15.4 |  | 1'' NPT for Dry Air Cooler E-100 1 & 2 (4C X 16mm2) OD:24.3mm |  |  | 2 | Nos |  | RAD 3 | Information
15.5 |  | 3/4'' NPT for Dry Air Cooler E-100 3 & 4 (4C X 10mm2) OD:21mm |  |  | 2 | Nos |  | RAD 2 | Information
15.6 |  | 1'' NPT for Regeneration Gas Cooler E-300A (1) & E-300B (1) (4C X 16mm2) OD:24.3mm |  |  | 2 | Nos |  | RAD 3 | Information
15.7 |  | 3/4'' NPT for Regeneration Gas Cooler E-300A (2) & E-300B (2) (4C X 10mm2) OD:21mm |  |  | 2 | Nos |  | RAD 2 | Information
15.8 |  | 1'' NPT for Cooling Gas Cooler E-400A (1) & E-400B (1) (4C X 16mm2) OD:24.3mm |  |  | 2 | Nos |  | RAD 3 | Information
15.9 |  | 1'' NPT for Cooling Gas Cooler E-400A (2) & E-400B (2) (4C X 10mm2) OD:21mm |  |  | 2 | Nos |  | RAD 3 | Information
15.10 |  | 3/4'' NPT for Condensate Transfer Pump P-100A/B(4C X 4mm2), OD:16.8mm |  |  | 2 | Nos |  | RAD 2 | Information
15.11 |  | 3/4'' NPT for Recycle Pump P-300A/B(4C X 2.5mm2) OD:15.4mm |  |  | 2 | Nos |  | RAD 2 | Information
15.12 |  | 3/4'' NPT for Treated Water Transfar Pump P-301A/B (4C X 2.5mm2), OD:15.4mm |  |  | 2 | Nos |  | RAD 2 | Information
15.13 |  | 3/4'' NPT for KOD Pump P-800 (4C X 2.5mm2), OD:15.4mm |  |  | 1 | Nos |  | RAD 2 | Information
15.14 |  | 3/4'' NPT for Wet Cooler CT-100 (4C X 6mm2), OD:18.8mm |  |  | 1 | Nos |  | RAD 2 | Information
15.15 |  | 3/4'' NPT for Deep Well Pump P-403(4C X 4mm2), OD:16.8mm |  |  | 1 | Nos |  | RAD 2 | Information
15.16 |  | 3/4'' NPT for Portable Water Pump P-404(4C X 2.5mm2), OD:15.4mm |  |  | 1 | Nos |  | RAD 2 | Information
15.17 |  | 3/4'' NPT for star-delta starter for P-700 & P-800 (3C X 4mm2), OD:15.8mm |  |  | 8 | Nos |  | RAD 2 | Information
15.18 |  | 3/4'' NPT for LCS ( 12C X 1.5mm2 ) OD:16.2mm |  |  | 24 | Nos |  | RAD 2 | Information
 |  | PG Gland for MCC Side
16.0 |  | Incoming Panel (1C X 150mm2) for Generator-1, 2, & 3 OD: …..mm |  |  | 30 | Nos |  |  | Information Required for PG size
16.1 |  | For National Grid (4C X 300mm2), OD:70.4mm |  |  | 2 | No. |  |  | Information Required for PG size
16.2 |  | PG-63 for Spare Outlet for a similar future plant (4C X 120mm2), OD:47.1mm |  |  | 2 | No. |  |  | Information Required for PG size
16.3 |  | PG-29 for Utility Air Compressour (4C X 10mm2), OD:21mm |  |  | 5 | No.
16.4 |  | PG-29 for Spare-1 25A(4C X 6mm2), OD:18.8mm |  |  | 2 | No.
16.5 |  | PG-36 for Spare-2,3,4,5 50A(4C X 16mm2), OD:24.3mm |  |  | 7 | No.
16.6 |  | PG-36 for Domestic & office Use 50kW(4C X 35mm2), OD:26.5mm |  |  | 1 | No.
16.7 |  | PG-29 for Generator & MCC Room Distribution Panel (4C X 6mm2), OD:18.8mm |  |  | 2 | Nos |  |  | PG-29 for 18mm to25mm Overall Dia Cable
16.8 |  | PG-21 for UPS System-1 (3C X 4mm2), OD:15.8mm |  |  | 1 | No. |  |  | PG-21 for 13mm to18mm Overall Dia Cable
16.9 |  | PG-21 for UPS System-2 (3C X 4mm2), OD:15.8mm |  |  | 1 | No. |  |  | PG-21 for 13mm to18mm Overall Dia Cable
16.10 |  | PG-21 for UPS System-3 (3C X 2.5mm2), OD:14.6mm |  |  | 1 | No. |  |  | PG-21 for 13mm to18mm Overall Dia Cable
16.11 |  | PG-21 for Condensate Transfer Pump P-100A/B (4C X 4mm2), OD:16.8mm |  |  | 2 | No. |  |  | PG-21 for 13mm to18mm Overall Dia Cable
16.12 |  | PG-21 for Cooling Water Pump P-200A/B (4C X 4mm2), OD:16.8mm |  |  | 2 | No. |  |  | PG-21 for 13mm to18mm Overall Dia Cable
16.13 |  | PG-36 for Dry Air Cooler E-100 1 & 2 (4C X 16mm2) OD:24.3mm |  |  | 4 | No. |  |  | PG-36 for 22mm to32mm Overall Dia Cable
16.14 |  | PG-29 for Dry Air Cooler E-100 3 & 4 (4C X 10mm2), OD:21mm |  |  | 2 | No. |  |  | PG-29 for 18mm to25mm Overall Dia Cable
16.15 |  | PG-36 for Regeneration Gas Cooler E-300A (1) & E-300B (1) (4C X 16mm2) OD:24.3mm |  |  | 2 | No. |  |  | PG-36 for 22mm to32mm Overall Dia Cable
16.16 |  | PG-29 for Regeneration Gas Cooler E-300A (2) & E-300B (2) (4C X 10mm2), OD:21mm |  |  | 2 | No. |  |  | PG-29 for 18mm to25mm Overall Dia Cable
16.17 |  | PG-36 for Cooling Gas Cooler E-400A (1) & E-400B (1) (4C X 16mm2) OD:24.3mm |  |  | 2 | No. |  |  | PG-36 for 22mm to32mm Overall Dia Cable
16.18 |  | PG-29 for Cooling Gas Cooler E-400A (2) & E-400B (2) (4C X 10mm2), OD:21mm |  |  | 2 | No. |  |  | PG-29 for 18mm to25mm Overall Dia Cable
16.19 |  | PG-21 for KOD Pump P-800 (4C X 2.5mm2), OD:15.4mm |  |  | 1 | No. |  |  | PG-21 for 13mm to18mm Overall Dia Cable
16.20 |  | PG-29 for Wet Cooler CT-100 (4C X 6mm2), OD:18.8mm |  |  | 1 | No. |  |  | PG-29 for 18mm to25mm Overall Dia Cable
16.21 |  | PG-21 for Air Dryer V-502A/B & V-503A/B (3C X 2.5mm2), OD:14.6mm |  |  | 4 |  |  |  | PG-21 for 13mm to18mm Overall Dia Cable
16.22 |  | PG-21 for Flare Stack Local Control Panel (4C X 2.5mm2), OD:15.4mm |  |  | 1 | No. |  |  | PG-21 for 13mm to18mm Overall Dia Cable
16.23 |  | PG-21 for Water Bath Heater H-100 (4C X 2.5mm2), OD:15.4mm |  |  | 1 | No. |  |  | PG-21 for 13mm to18mm Overall Dia Cable
16.24 |  | PG-21 for Regeneration Gas Heater H-200 (4C X 2.5mm2), OD:15.4mm |  |  | 1 | No. |  |  | PG-21 for 13mm to18mm Overall Dia Cable
16.25 |  | PG-21 for Deep Well Pump P-403 (4C X 4mm2), OD:16.8mm |  |  | 1 | No. |  |  | PG-21 for 13mm to18mm Overall Dia Cable
16.26 |  | PG-29 for Light Distribution Panel Power (5C X 10mm2) OD:18.8mm |  |  | 1 | No. |  |  | PG-29 for 18mm to 25mm Overall Dia Cable
16.27 |  | PG-21 for Potable Water Pump P-404 (4C X 2.5mm2), OD:15.4mm |  |  | 1 | No. |  |  | PG-21 for 13mm to18mm Overall Dia Cable
16.28 |  | PG-29 for Jockey Pump Control Panel P-401A/B (4C X 6mm2), OD:18.8mm |  |  | 2 | No. |  |  | PG-29 for 18mm to25mm Overall Dia Cable
16.29 |  | PG-21 for Diesel Fire Water Pump Control Panel P-402A/B (4C X 2.5mm2), OD:15.4mm |  |  | 2 | No. |  |  | PG-21 for 13mm to18mm Overall Dia Cable
16.30 |  | PG-21 for Condensate Recycle pump P-300A/B (4C X 2.5mm2), OD:15.4mm |  |  | 2 | No. |  |  | PG-21 for 13mm to18mm Overall Dia Cable
16.31 |  | PG-21 for Treated Water Transfer Pump P-301A/B (4C X 2.5mm2), OD:15.4mm |  |  | 2 | No. |  |  | PG-21 for 13mm to18mm Overall Dia Cable
16.32 |  | PG-21 for Generator Battery Charger (3C X 4mm2), OD:15.8mm |  |  | 1 | No. |  |  | PG-21 for 13mm to18mm Overall Dia Cable
16.33 |  | Light Distribution panel |  |  |  | No.
16.34 |  | PG-21 for Telescopic Tower Light-1,2,3,(3C X 2.5mm2), OD:14.6mm |  |  | 5 | Nos |  |  | PG-21 for 13mm to18mm Overall Dia Cable
16.35 |  | PG-21 for Pipe Rack Light-1 (3C X 2.5mm2), OD:14.6mm |  |  | 1 | No. |  |  | PG-21 for 13mm to18mm Overall Dia Cable
16.36 |  | PG-21 for Pipe Rack Light-2 (3C X 2.5mm2), OD:14.6mm |  |  | 1 | No. |  |  | PG-21 for 13mm to18mm Overall Dia Cable
16.37 |  | PG-21 for Street Light-1 (3C X 2.5mm2), OD:14.6mm |  |  | 1 | No. |  |  | PG-21 for 13mm to18mm Overall Dia Cable
16.38 |  | PG-21 for Street Light-2 (3C X 2.5mm2), OD:14.6mm |  |  | 1 | No. |  |  | PG-21 for 13mm to18mm Overall Dia Cable
16.39 |  | PG-21 for Instrument Air Area Light (3C X 2.5mm2), OD:14.6mm |  |  | 1 | No. |  |  | PG-21 for 13mm to18mm Overall Dia Cable
16.40 |  | PG-21 for Transfer Pump Shed Light(3C X 2.5mm2), OD:14.6mm |  |  | 1 | No. |  |  | PG-21 for 13mm to18mm Overall Dia Cable
16.41 |  | PG-21 for Fire Water Pump Shed Light(3C X 2.5mm2), OD:14.6mm |  |  | 1 | No. |  |  | PG-21 for 13mm to18mm Overall Dia Cable
16.42 |  | PG-21 for Loading Arm Shed Light(3C X 2.5mm2), OD:14.6mm |  |  | 1 | No. |  |  | PG-21 for 13mm to18mm Overall Dia Cable
16.43 |  | PG-21 for Air Craft Warning Light(3C X 2.5mm2), OD:14.6mm |  |  | 1 | No. |  |  | PG-21 for 13mm to18mm Overall Dia Cable
17.0 | Lightning Protection | Lightning Arrrestor For Generator Building 1meter each |  |  | 4 | Nos
17.1 |  | Lightning Arrrestor For Control Building 1meter each |  |  | 4 | Nos
17.2 |  | Lightning Arrrestor For TANK 1meter each |  |  | 2 | Nos
18.0 | Angle Bar | Angle bar (Cable Tray support) 1''x1'' |  |  | 150 | meter |  |  | Thickness 3 mm
18.1 |  | Angle bar (Cable Tray support) 1.5''x1.5'' |  |  | 200 | meter |  |  | Thickness 3 mm
 |  | C-channel for Panel Installation (base) Size: D=100mm, B=50mm, t=5mm, T=7.7mm |  |  | 80 | meter
19.0 | PVC Conduit | PVC Conduit Size 2'' |  |  | 50 | meter |  |  | BD
19.1 |  | PVC Conduit Size 1.5'' | PVC Conduit Size 1.5'' | PVC Conduit Size 1.5'' | 100 | meter |  |  | BD
19.2 |  | PVC Conduit Size 3/4'' | PVC Conduit Size 3/4'' | PVC Conduit Size 3/4'' | 50 | meter |  |  | BD
19.3 |  | PVC Coted Alluminium Flexible Hose pipe 1 Inch | Hose pipe | Hose pipe | 50 | meter |  |  | BD
19.4 |  | PVC Coted Alluminium Flexible Hose pipe 1.5 inch | Hose pipe | Hose pipe | 50 | meter
19.5 |  | Fittings for 1 Inch PVC Coated Alluminium Flexible Hose pipe | Hose pipe | Hose pipe | 1 | lot
19.6 |  | Fittings for 1.5 Inch PVC Coated Alluminium Flexible Hose pipe | Hose pipe | Hose pipe | 1 | lot
20.0 | Royal Bolt | Royal Bolt(6mm) |  |  | 100 | pcs |  |  | BD
20.1 |  | Royal Bolt(8mm) |  |  | 100 | pcs |  |  | BD
20.2 |  | Royal Bolt(10mm) FOR CABLE TRENCH ANGLE SUPPORT |  |  | 100 | pcs |  |  | BD
20.3 |  | Royal Bolt(12mm) |  |  | 100 | pcs |  |  | BD
21.0 | Cable Tie | Cable Tie , Size 24'' |  |  | 30 | Packet
21.1 |  | Cable Tie , Size 12'' |  |  | 30 | Packet
21.2 |  | Cable Tie , Size 8 '' |  |  | 30 | Packet
21.3 |  | Cable Tie , Size 6'' |  |  | 30 | Packet
22.0 | U-Bolt | U-bolt, Size 2'' (As per GI pipe size) |  |  | 100 | Nos
22.1 |  | U-bolt, Size 1.5'' (As per GI pipe size) |  |  | 100 | Nos
22.2 |  | U-bolt, Size 1'' (As per GI pipe size) |  |  | 50 | Nos
23.0 | Cable tagging | Cable Tagging & Marking |  |  | 1 | lot
23.1 |  | Ferrule 4 mm |  |  | 1 | Roll
23.2 |  | Ferrule 6 mm |  |  | 1 | Roll
24.0 | Power Cable
 |  | 3C X 2.5mm2 (RM) |  |  | 5795 | meters
 |  | 3C X 4mm2 (RM) |  |  | 640 | meters
 |  | 4C X 2.5mm2 (RM) |  |  | 3525 | meters
 |  | 4C X 4mm2 (RM) |  |  | 960 | meters
 |  | 4C X 6mm2 (RM) |  |  | 610 | meters
 |  | 4C X 10mm2 (RM) |  |  | 2275 | meters
 |  | 4C X 16mm2 (RM) |  |  | 1600 | meters
 |  | 12C X1.5mm2 (RM) |  |  | 5995 | meters
 |  | 24C X 1.5mm2 (RM) |  |  | 205 | meters
 |  | 3C x 4 mm2 (Flat) |  |  | 500 | meters |  |  | BD for Deep well Pump
 |  | 4C x 35 mm2 (RM) |  |  | 320 | meters
 |  | 1C X 150 (RM) |  |  | 1000 | meters
 |  | 4C X 95 (RM) |  |  | 200 | meters
 | instrument & Control
 |  | Cable & Accessories |  |  | 1 | Lot |  |  | Details list Under preparetion

Sheet: Instrumentation BOQ
MASTER BOQ 60 MMSCFD SILICAGEL DEHYDRATION TYPE GAS PROCESS PLANTT BAPEX
Sl.No | Category | Description of Materials |  |  | Quantity | Unit | PO Issued | Remarks
 |  | Equipment
 | Main Control Panel
 | F&G System | Fire Alarm Panel (Control Building)
 |  | F&G Mimic Panel
 |  | F&G - 01 (Process Area)
 |  | F&G - 01 (Tank Area)
 |  | F&G - 01 (Loading Area)
 |  | F&G - 01 (Generator Area)
 |  | Flame Detector
 |  | Gas Detector
 |  | Smoke Detector
 |  | Heat Detector
 |  | Manual Call Point (MAC)
 | ESD System | ESD JB
 | Flow Compouter | FC Panel
 |  | FC - JB
 | WBH | Water Bath Heater Panel
 | Regenration Unit | Regenration Heater Panel
 | Safety PLC
 | Oparation Station - 1 | CPU
 |  | 75" Monitor
 |  | Monitor 1
 |  | Monitor 2
 | Oparation Station - 2 | CPU
 |  | 75" Monitor
 |  | Monitor 1
 |  | Monitor 2
 | Engineering Station | CPU
 |  | Monitor 1
 | Hardware Console
 | RIO-0001A
 | SKID - 0404 | I/O Quantity: 27
 | TIT-0422
 | TIT-0425
 | TIT-0428
 | TIT-0440
 | TIT-0442
 | TIT-0446
 | TIT-0314
 | TIT-0437
 | TIT-0444
 | XV-0421
 | XV-0422
 | XV-0423
 | XV-0424
 | XV-0425
 | XV-0426
 | TANK AREA | I/O Quantity: 14
 | TIT-0501A
 | TIT-0501B
 | PIT-0901A
 | PIT-0901B
 | PIT-0902A
 | PIT-0902B
 | LIT-0901
 | LIT-0902
 | LDIT-0501A
 | LDIT-0501B
 | FE/FIT-0501
 | FE/FIT-0502
 | FV-0501
 | FV-0502
 | RIO-0001B
 | SKID - 0402 | I/O Quantity: 33
 | TIT-0411
 | TIT-0413
 | TIT-0415
 | TIT-0417
 | TIT-0419
 | TIT-0421
 | PIT-0411
 | PIT-0414
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
 | HSC-0902A
 | HSO-0902A
 | XI-0902A
 | XA-0902A
 | HS-0902AA
 | HS-0902AB
 | P-301B-(M-0902B) | I/O Quantity: 6
 | HSC-0902B
 | HSO-0902B
 | XI-0902B
 | XA-0902B
 | HS-0902BA
 | HS-0902BB
 | P-403-(M-1001) | I/O Quantity: 6
 | HSC-1001
 | HSO-1001
 | XI-1001
 | XA-1001
 | HS-1001A
 | HS-1001B
 | P-404-(M-1101) | I/O Quantity: 6
 | HSC-1101
 | HSO-1101
 | XI-1101
 | XA-1101
 | HS-1101A
 | HS-1101B
 | P-800-(M-801) | I/O Quantity: 5
 | HSC-0801
 | XI-0801
 | XA-0801
 | HS-0801A
 | HS-0801B
 | FC
 | SKID - 0301A/B | I/O Quantity: 6
 | TIT-0302A
 | TIT-0302B
 | PIT-0303A
 | PIT-0303B
 | FIT-0301A
 | FIT-0301B
 | SKID - 0302 | I/O Quantity: 3
 | TIT-0303
 | PIT-0303
 | FIT-0303
 | SKID - 0406 | I/O Quantity: 7
 | TIT-0452A
 | TIT-0452B
 | PIT-0452A
 | PIT-0452B
 | FIT-0452A
 | FIT-0452B
 | GC-0401
 | SKID - 0601 | I/O Quantity: 6
 | TIT-0601
 | TIT-0607
 | PIT-0601
 | PIT-0607
 | FE/FIT-0601
 | FE/FIT-0607
 | FGS-01 (PROCESS AREA)
 | FD | I/O Quantity: 4
 | FD-0401
 | FD-0402
 | FD-0403
 | FD-0404
 | GD | I/O Quantity: 4
 | GD-0401
 | GD-0402
 | GD-0403
 | GD-0404
 | MAC | I/O Quantity: 2
 | MAC-0401
 | MAC-0402
 | BL | I/O Quantity: 2
 | BL0401-YELLOW
 | BL0401-RED
 | FGS-02 (TANK AREA)
 | FD | I/O Quantity: 3
 | FD-0501
 | FD-0502
 | FD-0503
 | GD | I/O Quantity: 4
 | GD-0501
 | GD-0502
 | GD-0503
 | GD-0504
 | MAC | I/O Quantity: 2
 | MAC-0501
 | MAC-0502
 | BL | I/O Quantity: 2
 | BL0501-YELLOW
 | BL0501-RED
 | DELUGE | I/O Quantity: 4
 | XY-1011
 | XY-1012
 | XY-1013
 | XY-1014
 | FOAM | I/O Quantity: 9
 | XY-1015
 | XY-1016
 | XY-1017
 | ZSC-1015
 | ZSO-1015
 | ZSC-1016
 | ZSO-1016
 | ZSC-1017
 | ZSO-1017
 | FGS-03 (LOADING AREA)
 | FD | I/O Quantity: 2
 | FD-0504
 | FD-0505
 | MAC | I/O Quantity: 1
 | MAC-0503
 | BL | I/O Quantity: 1
 | BL0502-RED
 | FGS-04 (GENERATOR BUILDING)
 | FD | I/O Quantity: 1
 | FD-1401
 | GD | I/O Quantity: 2
 | GD-1401
 | GD-1402
 | MAC | I/O Quantity: 1
 | MAC-1401
 | BL | I/O Quantity: 2
 | BL1401-RED
 | BL1401-YELLOW
 | ESD (HARDWARED CABLE CONNECTION)
 | WCP | I/O Quantity: 2
 | ESD1-WCP
 | ESD2-WCP
 | WELL # 2 | I/O Quantity: 3
 | SDY-0202B
 | ZSC-0202B
 | ZSO-0202B
 | S-0301 | I/O Quantity: 3
 | SDY-0201A
 | ZSC-0201A
 | ZSO-0201A
 | S-0406 | I/O Quantity: 6
 | SDY-0426
 | ZSC-0426
 | ZSO-0426
 | BDY-0427
 | ZSC-0427
 | ZSO-0427
 | ESD-0001 | I/O Quantity: 1
 | ESD-0002 | I/O Quantity: 1
 | H-100 | I/O Quantity: 1
 | H-200 | I/O Quantity: 1
 | Fire
 | PIT-1001
 | LILIT-1001
 | LIT-1002
 | LV-1001
 | Serial Cable
 | For H-100
 | For H-200
 | For GC
10.0 | GI Pipe | GI PIPE & FITTINGS
10.16 |  | GI Pipe ,Size 3/4" For F&G, CCTV System |  |  | 100 | meter
10.17 |  | GI Pipe ,Size 1" For F&G, CCTV System |  |  | 300 | meter
10.18 |  | GI Pipe ,Size 1.5" For F&G, CCTV System & others Stand |  |  | 150 | meter
 |  | GI Pipe ,Size 4'' For Loading Arm, National Grid Line,Compressor Station Road Crossing Area |  |  | 80 | meter
11.1 | GI fittings | GI Elbow ,Size 1'' |  |  | 100 | Nos
11.2 |  | GI Union ,Size 1'' |  |  | 30 | Nos
11.3 |  | GI Tee, Size 1'' |  |  | 40 | Nos
11.4 |  | GI Socket, Size 1'' |  |  | 40 | Nos
11.5 |  | GI Elbow ,Size 1.5'' |  |  | 30 | Nos
11.6 |  | GI Union ,Size 1.5'' |  |  | 20 | Nos
11.7 |  | GI Tee, Size 1.5'' |  |  | 20 | Nos
11.8 |  | GI Socket, Size 1.5'' |  |  | 30 | Nos
11.9 |  | GI Socket, Size 4'' |  |  | 4 | Nos
12.1 | Lugs | I lugs 1.5 mm2 for others use |  |  | 4000 | pcs
12.2 |  | I lugs 2 mm2 for others use |  |  | 1000 | pcs
12.3 |  | I lugs 2.5 mm2 for others use |  |  | 1000 | pcs
12.4 |  | Y lugs 2.5 mm2 for others use |  |  | 1000 | pcs
12.5 |  | Y lugs 4 mm2 for others use |  |  | 1000 | pcs
12.6 |  | Y lugs 6 mm2 for others use |  |  | 1000 | pcs
15.0 |  | Metal Gland for Field Side
15.1 | Cable Gland | 3/4'' NPT for Utility Air Compressour (4C X 10mm2), OD:21mm |  |  | 1 | Nos |  | RAD 2 | Information
15.2 |  | 1/2'' NPT for Air Dryer (3C X 2.5mm2), OD:14.6mm |  |  | 1 | Nos |  | RAD 1 | Information
15.3 |  | 3/4'' NPT for Cooling Water Pump P-200A/B (4C X 4mm2) OD:16.8mm |  |  | 1 | Nos |  | RAD 2 | Information
15.4 |  | 1'' NPT for Dry Air Cooler E-100 1 & 2 (4C X 16mm2) OD:24.3mm |  |  | 2 | Nos |  | RAD 3 | Information
15.5 |  | 3/4'' NPT for Dry Air Cooler E-100 3 & 4 (4C X 10mm2) OD:21mm |  |  | 2 | Nos |  | RAD 2 | Information
15.6 |  | 1'' NPT for Regeneration Gas Cooler E-300A (1) & E-300B (1) (4C X 16mm2) OD:24.3mm |  |  | 2 | Nos |  | RAD 3 | Information
15.7 |  | 3/4'' NPT for Regeneration Gas Cooler E-300A (2) & E-300B (2) (4C X 10mm2) OD:21mm |  |  | 2 | Nos |  | RAD 2 | Information
15.8 |  | 1'' NPT for Cooling Gas Cooler E-400A (1) & E-400B (1) (4C X 16mm2) OD:24.3mm |  |  | 2 | Nos |  | RAD 3 | Information
15.9 |  | 1'' NPT for Cooling Gas Cooler E-400A (2) & E-400B (2) (4C X 10mm2) OD:21mm |  |  | 2 | Nos |  | RAD 3 | Information
15.10 |  | 3/4'' NPT for Condensate Transfer Pump P-100A/B(4C X 4mm2), OD:16.8mm |  |  | 2 | Nos |  | RAD 2 | Information
15.11 |  | 3/4'' NPT for Recycle Pump P-300A/B(4C X 2.5mm2) OD:15.4mm |  |  | 2 | Nos |  | RAD 2 | Information
15.12 |  | 3/4'' NPT for Treated Water Transfar Pump P-301A/B (4C X 2.5mm2), OD:15.4mm |  |  | 2 | Nos |  | RAD 2 | Information
15.13 |  | 3/4'' NPT for KOD Pump P-800 (4C X 2.5mm2), OD:15.4mm |  |  | 1 | Nos |  | RAD 2 | Information
15.14 |  | 3/4'' NPT for Wet Cooler CT-100 (4C X 6mm2), OD:18.8mm |  |  | 1 | Nos |  | RAD 2 | Information
15.15 |  | 3/4'' NPT for Deep Well Pump P-403(4C X 4mm2), OD:16.8mm |  |  | 1 | Nos |  | RAD 2 | Information
15.16 |  | 3/4'' NPT for Portable Water Pump P-404(4C X 2.5mm2), OD:15.4mm |  |  | 1 | Nos |  | RAD 2 | Information
15.17 |  | 3/4'' NPT for star-delta starter for P-700 & P-800 (3C X 4mm2), OD:15.8mm |  |  | 8 | Nos |  | RAD 2 | Information
15.18 |  | 3/4'' NPT for LCS ( 12C X 1.5mm2 ) OD:16.2mm |  |  | 24 | Nos |  | RAD 2 | Information
 |  | PG Gland for MCC Side
16.0 |  | Incoming Panel (1C X 150mm2) for Generator-1, 2, & 3 OD: …..mm |  |  | 30 | Nos |  |  | Information Required for PG size
16.1 |  | For National Grid (4C X 300mm2), OD:70.4mm |  |  | 2 | No. |  |  | Information Required for PG size
16.2 |  | PG-63 for Spare Outlet for a similar future plant (4C X 120mm2), OD:47.1mm |  |  | 2 | No. |  |  | Information Required for PG size
16.3 |  | PG-29 for Utility Air Compressour (4C X 10mm2), OD:21mm |  |  | 5 | No.
16.4 |  | PG-29 for Spare-1 25A(4C X 6mm2), OD:18.8mm |  |  | 2 | No.
16.5 |  | PG-36 for Spare-2,3,4,5 50A(4C X 16mm2), OD:24.3mm |  |  | 7 | No.
16.6 |  | PG-36 for Domestic & office Use 50kW(4C X 35mm2), OD:26.5mm |  |  | 1 | No.
16.7 |  | PG-29 for Generator & MCC Room Distribution Panel (4C X 6mm2), OD:18.8mm |  |  | 2 | Nos |  |  | PG-29 for 18mm to25mm Overall Dia Cable
16.8 |  | PG-21 for UPS System-1 (3C X 4mm2), OD:15.8mm |  |  | 1 | No. |  |  | PG-21 for 13mm to18mm Overall Dia Cable
16.9 |  | PG-21 for UPS System-2 (3C X 4mm2), OD:15.8mm |  |  | 1 | No. |  |  | PG-21 for 13mm to18mm Overall Dia Cable
16.10 |  | PG-21 for UPS System-3 (3C X 2.5mm2), OD:14.6mm |  |  | 1 | No. |  |  | PG-21 for 13mm to18mm Overall Dia Cable
16.11 |  | PG-21 for Condensate Transfer Pump P-100A/B (4C X 4mm2), OD:16.8mm |  |  | 2 | No. |  |  | PG-21 for 13mm to18mm Overall Dia Cable
16.12 |  | PG-21 for Cooling Water Pump P-200A/B (4C X 4mm2), OD:16.8mm |  |  | 2 | No. |  |  | PG-21 for 13mm to18mm Overall Dia Cable
16.13 |  | PG-36 for Dry Air Cooler E-100 1 & 2 (4C X 16mm2) OD:24.3mm |  |  | 4 | No. |  |  | PG-36 for 22mm to32mm Overall Dia Cable
16.14 |  | PG-29 for Dry Air Cooler E-100 3 & 4 (4C X 10mm2), OD:21mm |  |  | 2 | No. |  |  | PG-29 for 18mm to25mm Overall Dia Cable
16.15 |  | PG-36 for Regeneration Gas Cooler E-300A (1) & E-300B (1) (4C X 16mm2) OD:24.3mm |  |  | 2 | No. |  |  | PG-36 for 22mm to32mm Overall Dia Cable
16.16 |  | PG-29 for Regeneration Gas Cooler E-300A (2) & E-300B (2) (4C X 10mm2), OD:21mm |  |  | 2 | No. |  |  | PG-29 for 18mm to25mm Overall Dia Cable
16.17 |  | PG-36 for Cooling Gas Cooler E-400A (1) & E-400B (1) (4C X 16mm2) OD:24.3mm |  |  | 2 | No. |  |  | PG-36 for 22mm to32mm Overall Dia Cable
16.18 |  | PG-29 for Cooling Gas Cooler E-400A (2) & E-400B (2) (4C X 10mm2), OD:21mm |  |  | 2 | No. |  |  | PG-29 for 18mm to25mm Overall Dia Cable
16.19 |  | PG-21 for KOD Pump P-800 (4C X 2.5mm2), OD:15.4mm |  |  | 1 | No. |  |  | PG-21 for 13mm to18mm Overall Dia Cable
16.20 |  | PG-29 for Wet Cooler CT-100 (4C X 6mm2), OD:18.8mm |  |  | 1 | No. |  |  | PG-29 for 18mm to25mm Overall Dia Cable
16.21 |  | PG-21 for Air Dryer V-502A/B & V-503A/B (3C X 2.5mm2), OD:14.6mm |  |  | 4 |  |  |  | PG-21 for 13mm to18mm Overall Dia Cable
16.22 |  | PG-21 for Flare Stack Local Control Panel (4C X 2.5mm2), OD:15.4mm |  |  | 1 | No. |  |  | PG-21 for 13mm to18mm Overall Dia Cable
16.23 |  | PG-21 for Water Bath Heater H-100 (4C X 2.5mm2), OD:15.4mm |  |  | 1 | No. |  |  | PG-21 for 13mm to18mm Overall Dia Cable
16.24 |  | PG-21 for Regeneration Gas Heater H-200 (4C X 2.5mm2), OD:15.4mm |  |  | 1 | No. |  |  | PG-21 for 13mm to18mm Overall Dia Cable
16.25 |  | PG-21 for Deep Well Pump P-403 (4C X 4mm2), OD:16.8mm |  |  | 1 | No. |  |  | PG-21 for 13mm to18mm Overall Dia Cable
16.26 |  | PG-29 for Light Distribution Panel Power (5C X 10mm2) OD:18.8mm |  |  | 1 | No. |  |  | PG-29 for 18mm to 25mm Overall Dia Cable
16.27 |  | PG-21 for Potable Water Pump P-404 (4C X 2.5mm2), OD:15.4mm |  |  | 1 | No. |  |  | PG-21 for 13mm to18mm Overall Dia Cable
16.28 |  | PG-29 for Jockey Pump Control Panel P-401A/B (4C X 6mm2), OD:18.8mm |  |  | 2 | No. |  |  | PG-29 for 18mm to25mm Overall Dia Cable
16.29 |  | PG-21 for Diesel Fire Water Pump Control Panel P-402A/B (4C X 2.5mm2), OD:15.4mm |  |  | 2 | No. |  |  | PG-21 for 13mm to18mm Overall Dia Cable
16.30 |  | PG-21 for Condensate Recycle pump P-300A/B (4C X 2.5mm2), OD:15.4mm |  |  | 2 | No. |  |  | PG-21 for 13mm to18mm Overall Dia Cable
16.31 |  | PG-21 for Treated Water Transfer Pump P-301A/B (4C X 2.5mm2), OD:15.4mm |  |  | 2 | No. |  |  | PG-21 for 13mm to18mm Overall Dia Cable
16.32 |  | PG-21 for Generator Battery Charger (3C X 4mm2), OD:15.8mm |  |  | 1 | No. |  |  | PG-21 for 13mm to18mm Overall Dia Cable
16.33 |  | Light Distribution panel |  |  |  | No.
16.34 |  | PG-21 for Telescopic Tower Light-1,2,3,(3C X 2.5mm2), OD:14.6mm |  |  | 5 | Nos |  |  | PG-21 for 13mm to18mm Overall Dia Cable
16.35 |  | PG-21 for Pipe Rack Light-1 (3C X 2.5mm2), OD:14.6mm |  |  | 1 | No. |  |  | PG-21 for 13mm to18mm Overall Dia Cable
16.36 |  | PG-21 for Pipe Rack Light-2 (3C X 2.5mm2), OD:14.6mm |  |  | 1 | No. |  |  | PG-21 for 13mm to18mm Overall Dia Cable
16.37 |  | PG-21 for Street Light-1 (3C X 2.5mm2), OD:14.6mm |  |  | 1 | No. |  |  | PG-21 for 13mm to18mm Overall Dia Cable
16.38 |  | PG-21 for Street Light-2 (3C X 2.5mm2), OD:14.6mm |  |  | 1 | No. |  |  | PG-21 for 13mm to18mm Overall Dia Cable
16.39 |  | PG-21 for Instrument Air Area Light (3C X 2.5mm2), OD:14.6mm |  |  | 1 | No. |  |  | PG-21 for 13mm to18mm Overall Dia Cable
16.40 |  | PG-21 for Transfer Pump Shed Light(3C X 2.5mm2), OD:14.6mm |  |  | 1 | No. |  |  | PG-21 for 13mm to18mm Overall Dia Cable
16.41 |  | PG-21 for Fire Water Pump Shed Light(3C X 2.5mm2), OD:14.6mm |  |  | 1 | No. |  |  | PG-21 for 13mm to18mm Overall Dia Cable
16.42 |  | PG-21 for Loading Arm Shed Light(3C X 2.5mm2), OD:14.6mm |  |  | 1 | No. |  |  | PG-21 for 13mm to18mm Overall Dia Cable
16.43 |  | PG-21 for Air Craft Warning Light(3C X 2.5mm2), OD:14.6mm |  |  | 1 | No. |  |  | PG-21 for 13mm to18mm Overall Dia Cable
18.0 | Angle Bar | Angle bar (Cable Tray support) 1''x1'' |  |  | 150 | meter |  |  | Thickness 3 mm
18.1 |  | Angle bar (Cable Tray support) 1.5''x1.5'' |  |  | 100 | meter |  |  | Thickness 3 mm
19.3 | PVC Pipe | PVC Coted Alluminium Flexible Hose pipe 1 Inch | Hose pipe | Hose pipe | 100 | meter |  |  | BD
19.4 |  | PVC Coted Alluminium Flexible Hose pipe 1.5 inch | Hose pipe | Hose pipe | 100 | meter
19.5 |  | Fittings for 1 Inch PVC Coated Alluminium Flexible Hose pipe | Hose pipe | Hose pipe | 1 | lot
19.6 |  | Fittings for 1.5 Inch PVC Coated Alluminium Flexible Hose pipe | Hose pipe | Hose pipe | 1 | lot
20.2 | Royal Bolt | Royal Bolt(10mm) FOR CABLE TRENCH ANGLE SUPPORT |  |  | 400 | pcs |  |  | BD
20.3 |  | Royal Bolt(12mm) |  |  | 100 | pcs |  |  | BD
21.2 | Cable Tie | Cable Tie , Size 8 '' |  |  | 10 | Packet
22.1 | U-Bolt | U-bolt, Size 1.5'' (As per GI pipe size) |  |  | 50 | Nos
22.2 |  | U-bolt, Size 1'' (As per GI pipe size) |  |  | 150 | Nos
 |  | U-bolt, Size 3/4'' (As per GI pipe size) |  |  | 100 | Nos
24.0 | Instrument Cable
 |  |  |  |  |  | meters
 |  |  |  |  |  | meters
 |  |  |  |  |  | meters
 |  |  |  |  |  | meters
 |  |  |  |  |  | meters
 |  |  |  |  |  | meters
 |  |  |  |  |  | meters
 |  |  |  |  |  | meters
 |  |  |  |  |  | meters
 |  |  |  |  |  | meters
 |  |  |  |  |  | meters
 |  |  |  |  |  | meters
 |  |  |  |  |  | meters
 |  |  |  |  |  | meters
 | instrument & Control
 |  | Cable & Accessories |  |  | 1 | Lot |  |  | Details list Under preparetion
