skdzicombd/P_240_Autocad_Docs/(list of files, cad)

Other CAD files:
Cable Route Layout/240-0201-EMEL-DW00-0001_A - Electrical Cable Route Layout.dwg
Design of Building Electrical System/240-0201-EMEL-DW00-0006 Design of Building Electrical System, Control Building.dwg
Earthing Diagram/240-0201-EMEL-DW00-0004_A - Earthing Layout.dwg
Lighting System Layout/240-0201-EMEL-DW00-0002_A - Lighting System Layout.dwg
P240 building fire system/P-240 Fire Detection and Alarm System.dwg
Single Line Diagrams (SLD)/240-0214-EMEL-DW00-0006_A - Single Line for UPS.dwg
Design of Building Electrical System/240-0201-EMEL-DW00-0006 Design of Building Electrical System, Generator Building.DWG
Single Line Diagrams (SLD)/240-0214-EMEL-DW00-0003_A - Single Line Diagram for Normal and Emergency Light.dwg
