skdzicombd/P_240_Autocad_Docs/Hazardous Area Classification/240-0201-EMEL-DW00-0003_A - Hazardous Area Classification Drawing.pdf

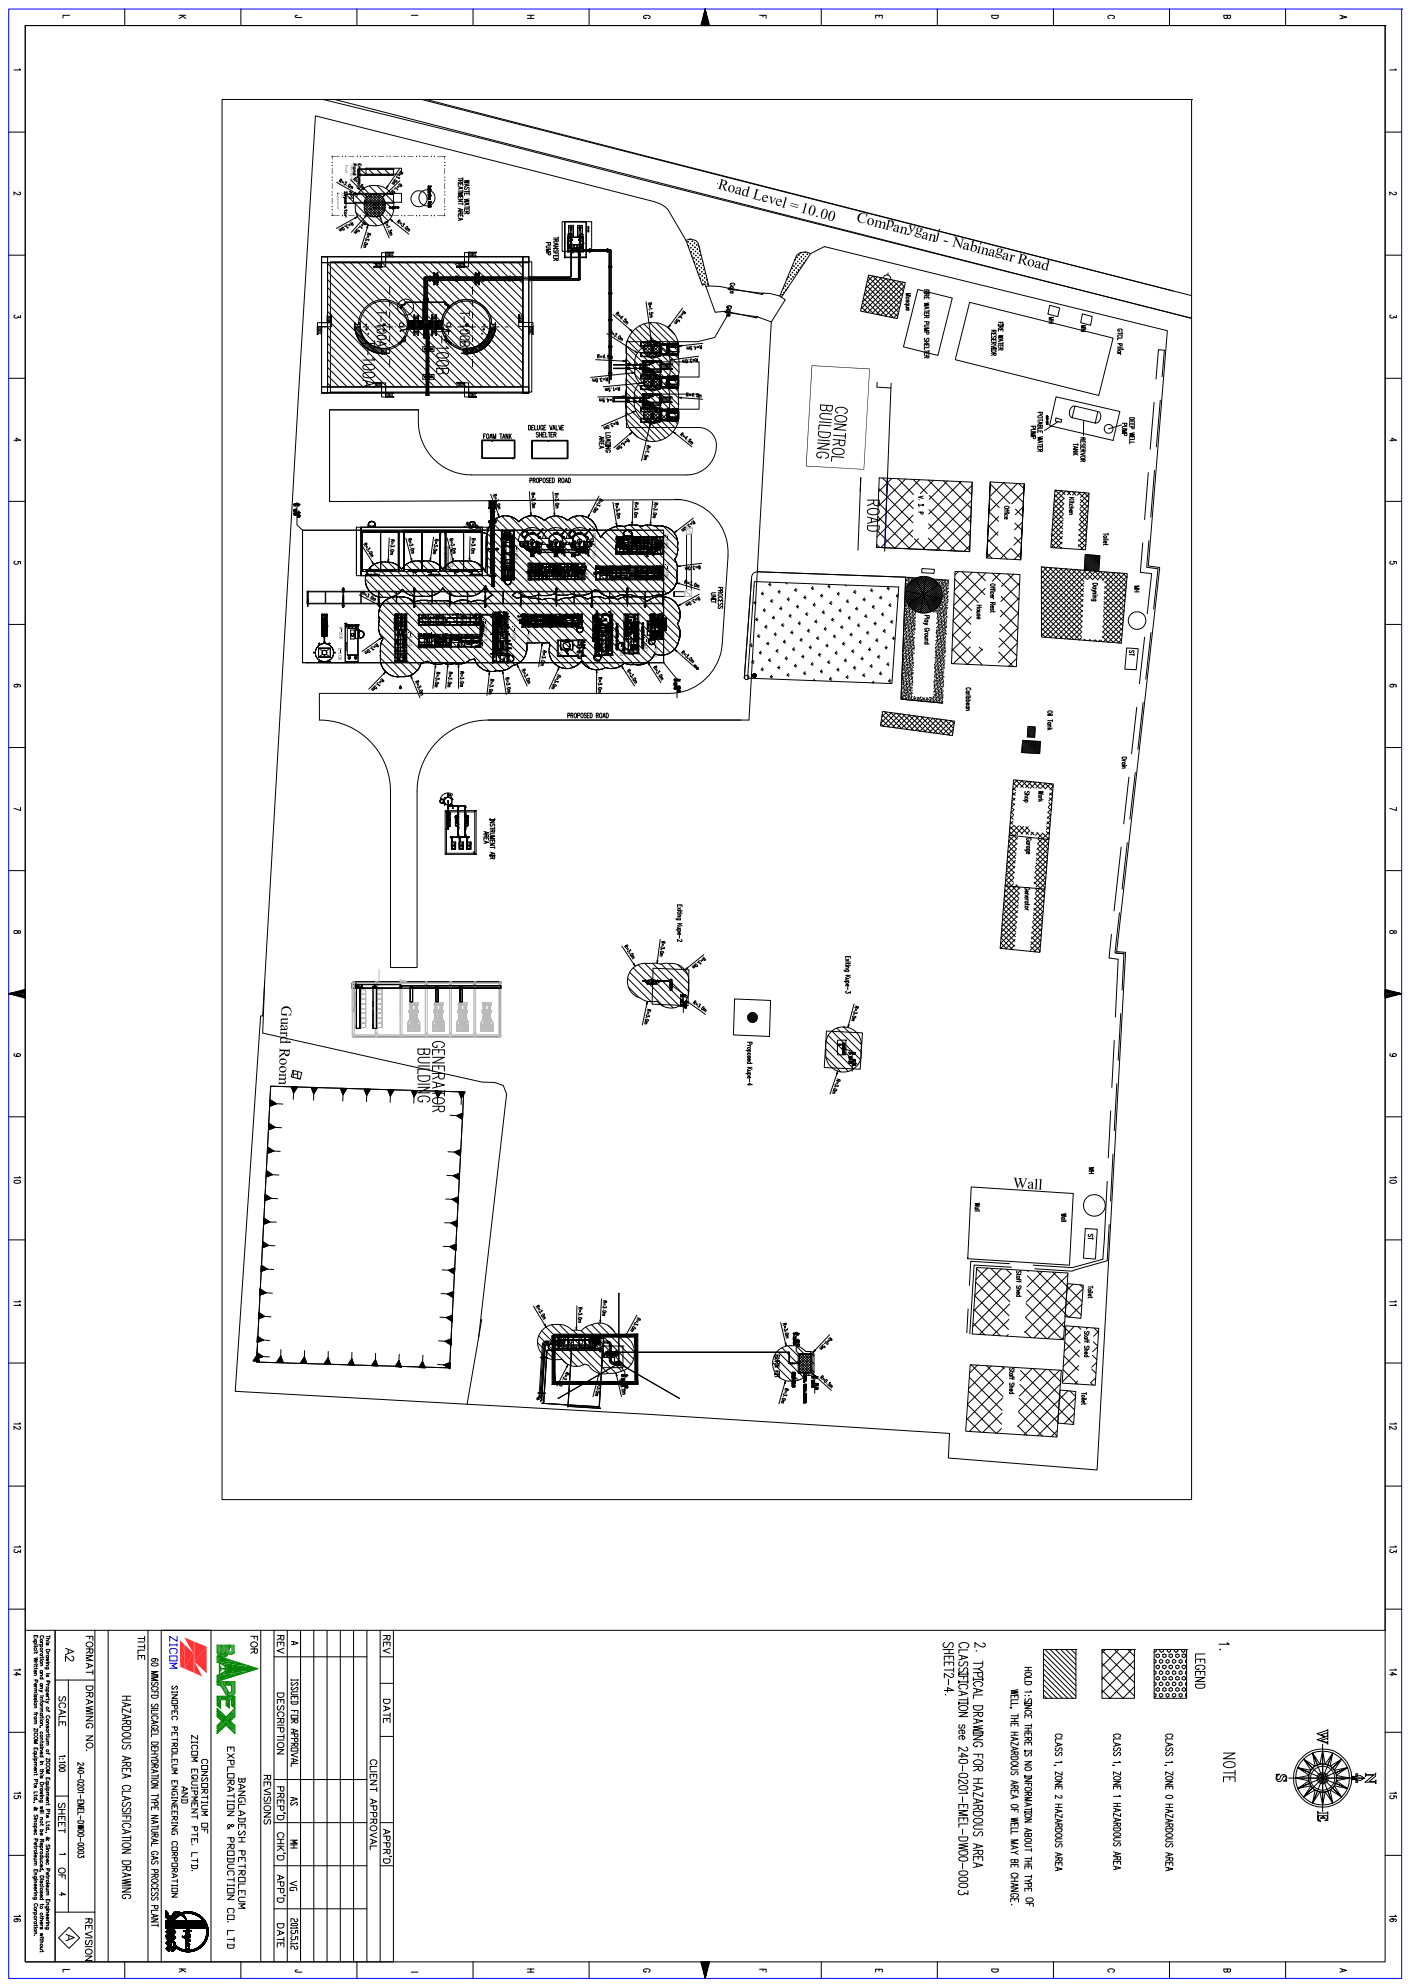
[picture p1: page 1]

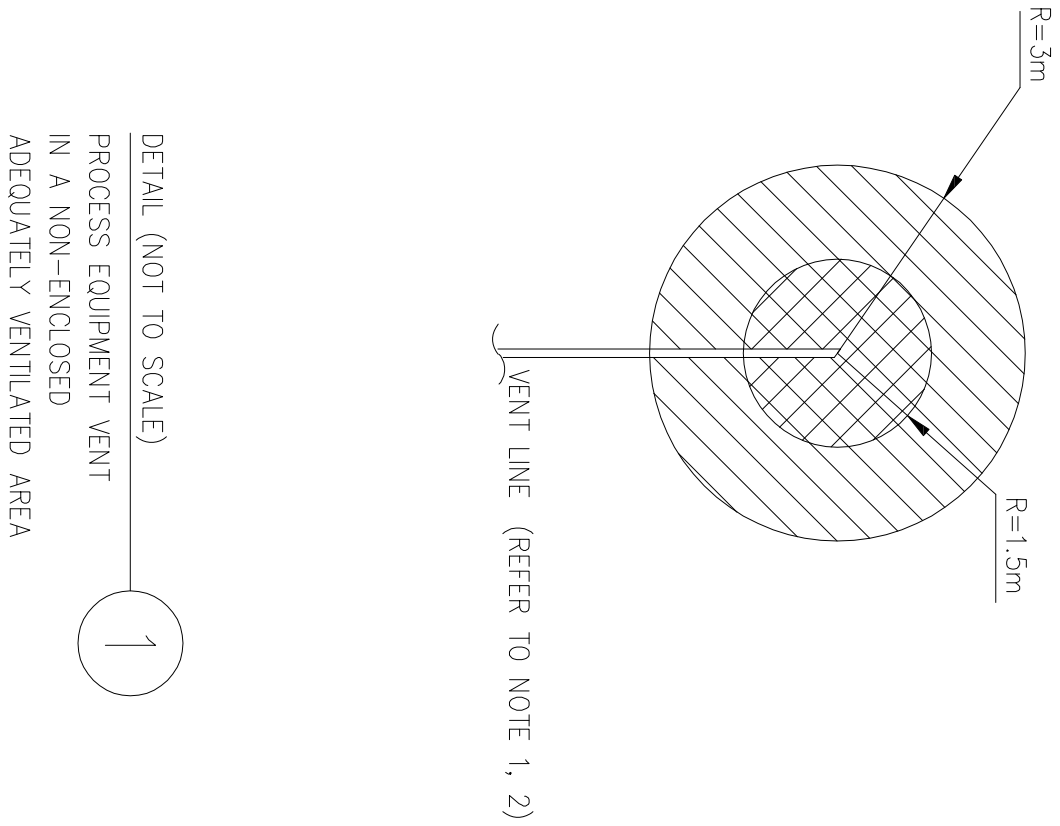
[picture p2: page 2]

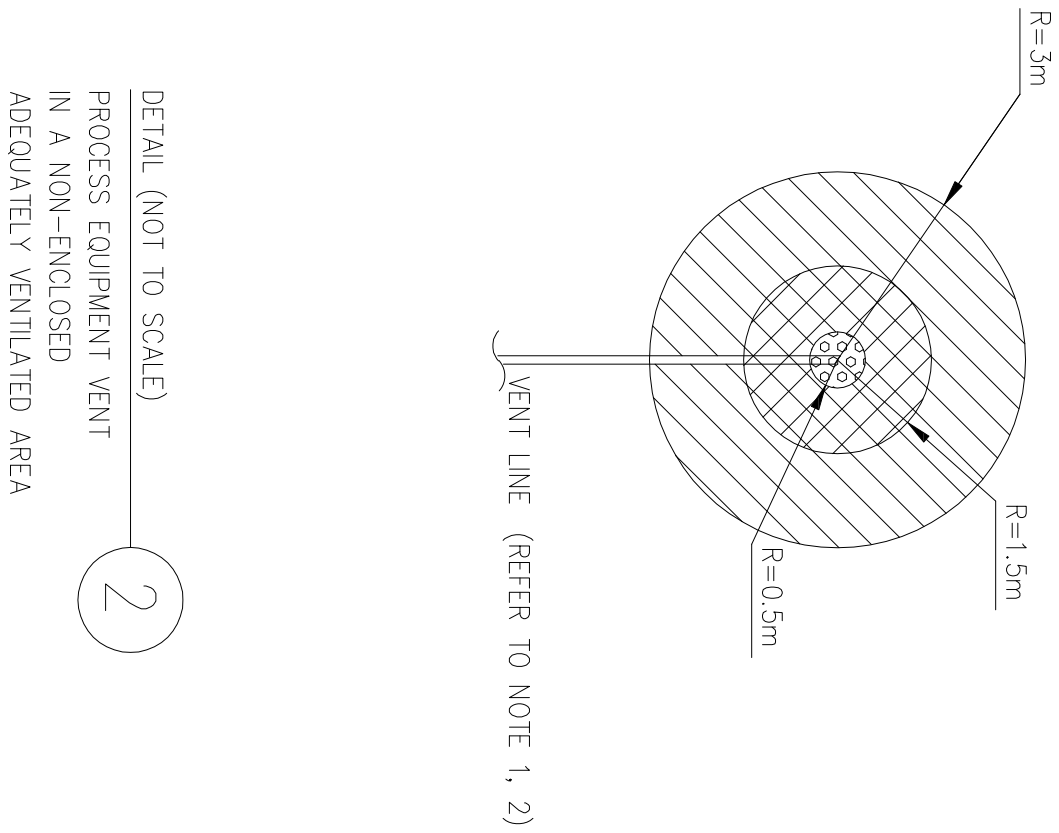
[picture p3: page 3]

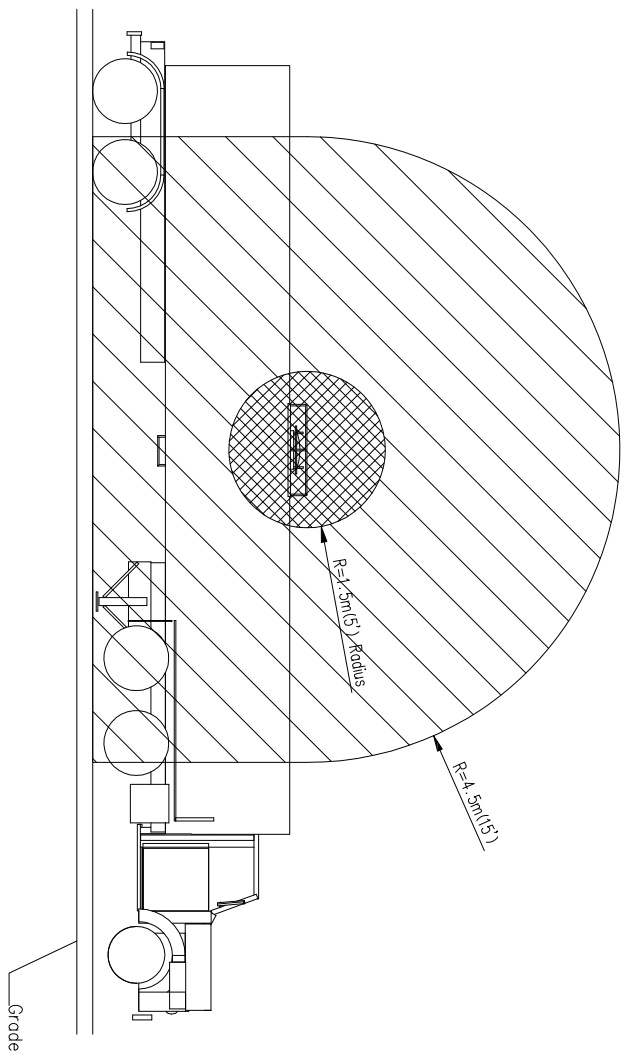
[picture p4: page 4]
