skdzicombd/P_240_Autocad_Docs/Design of Building Electrical System/240-0201-EMEL-DW00-0006 Design of Building Electrical System, Generator Building.pdf

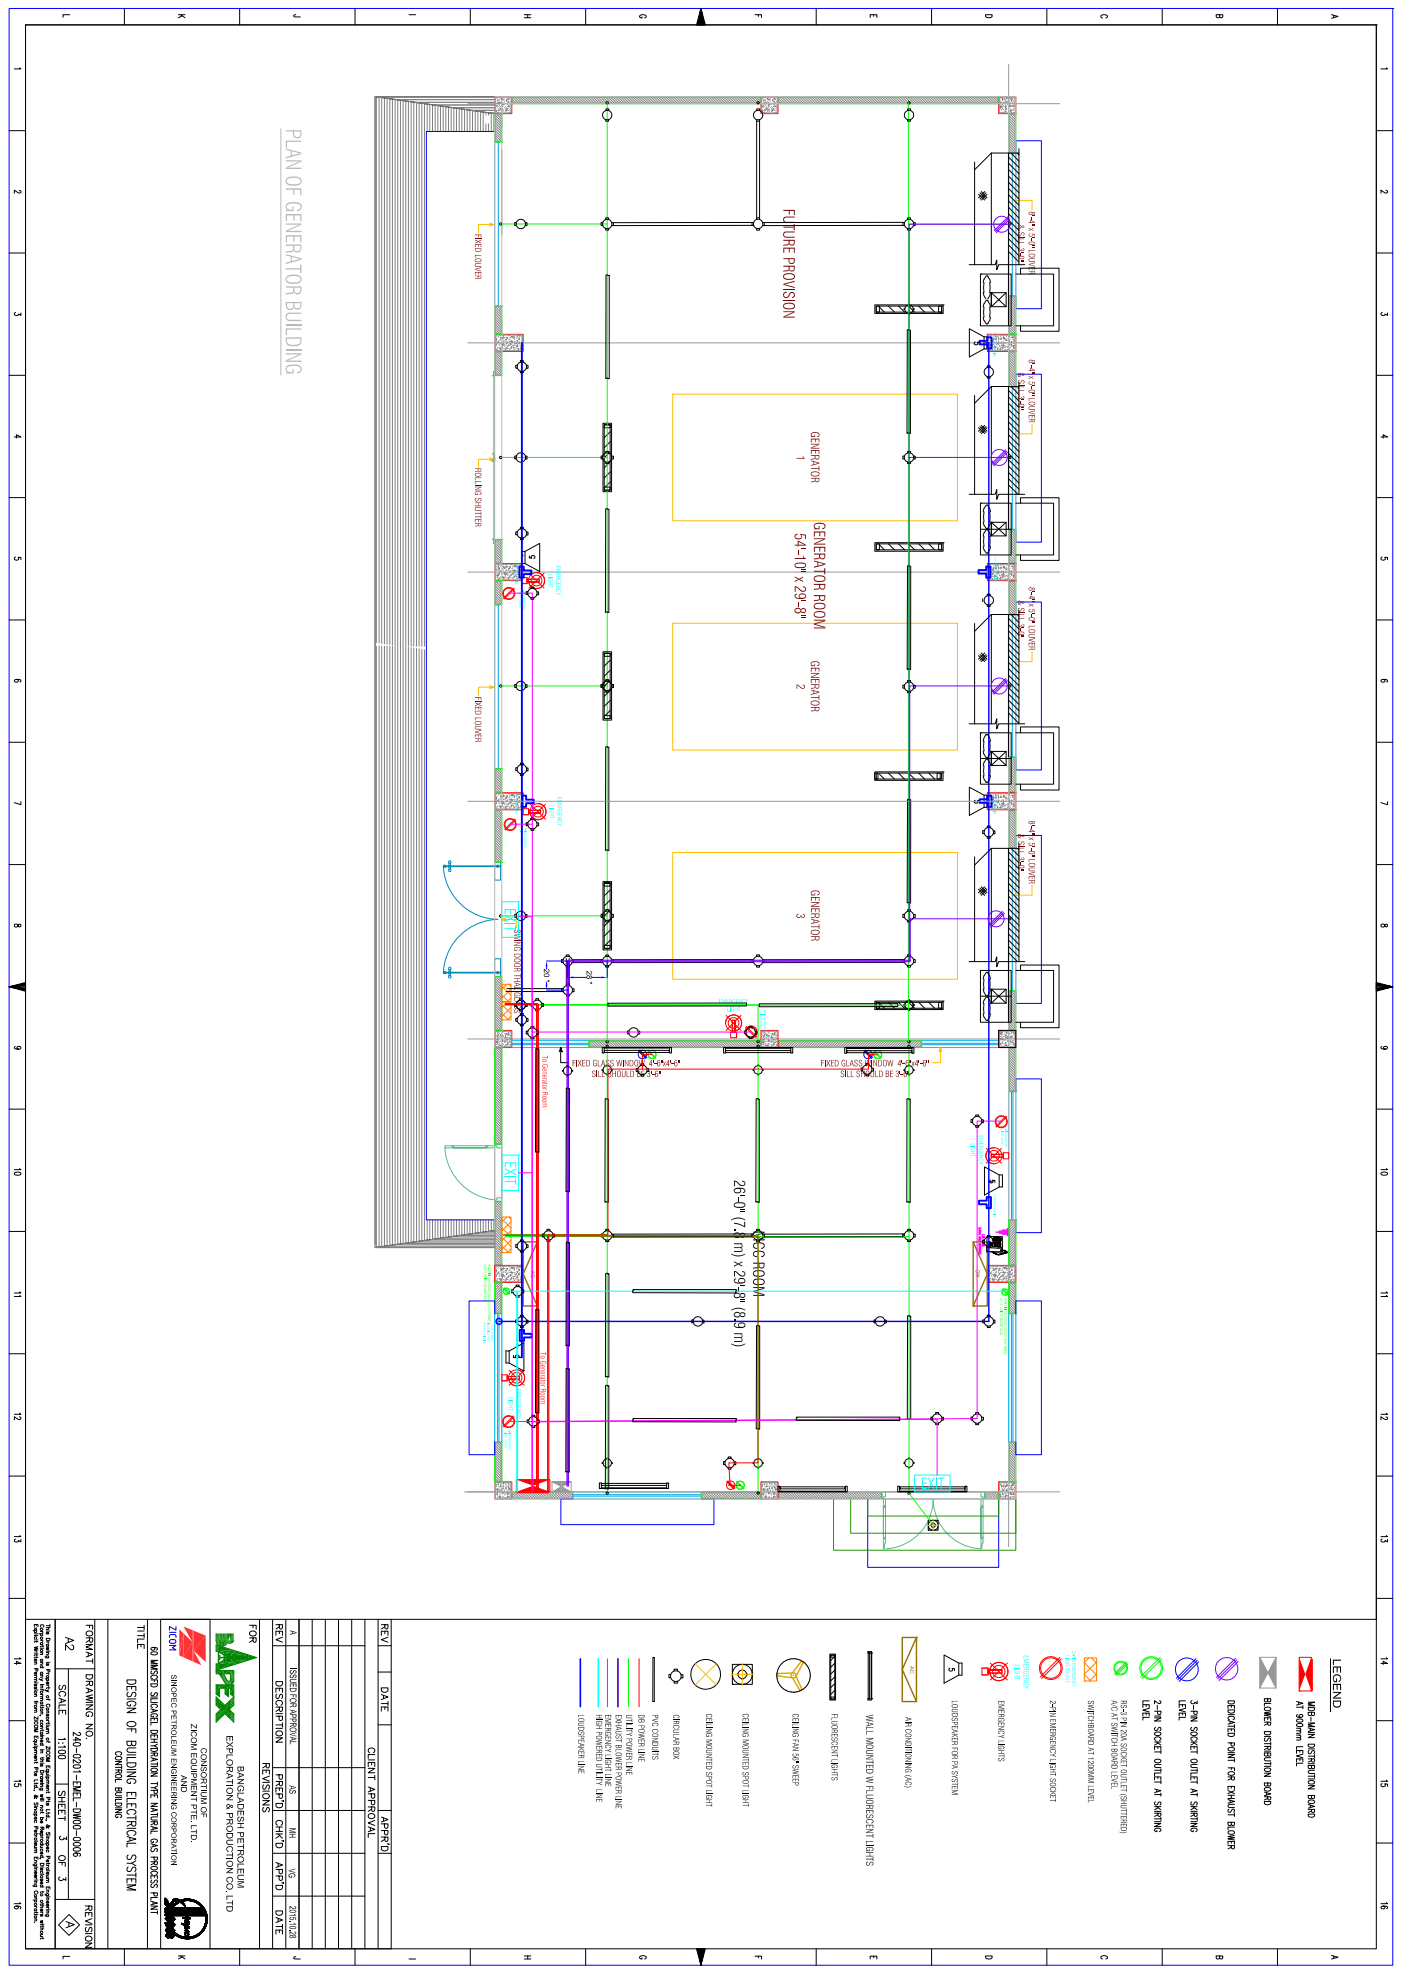
[picture p7: page 1]
