skdzicombd/P_240_Autocad_Docs/Cable Route Layout/240-0201-EMEL-DW00-0001_A - Electrical Cable Route Layout.pdf

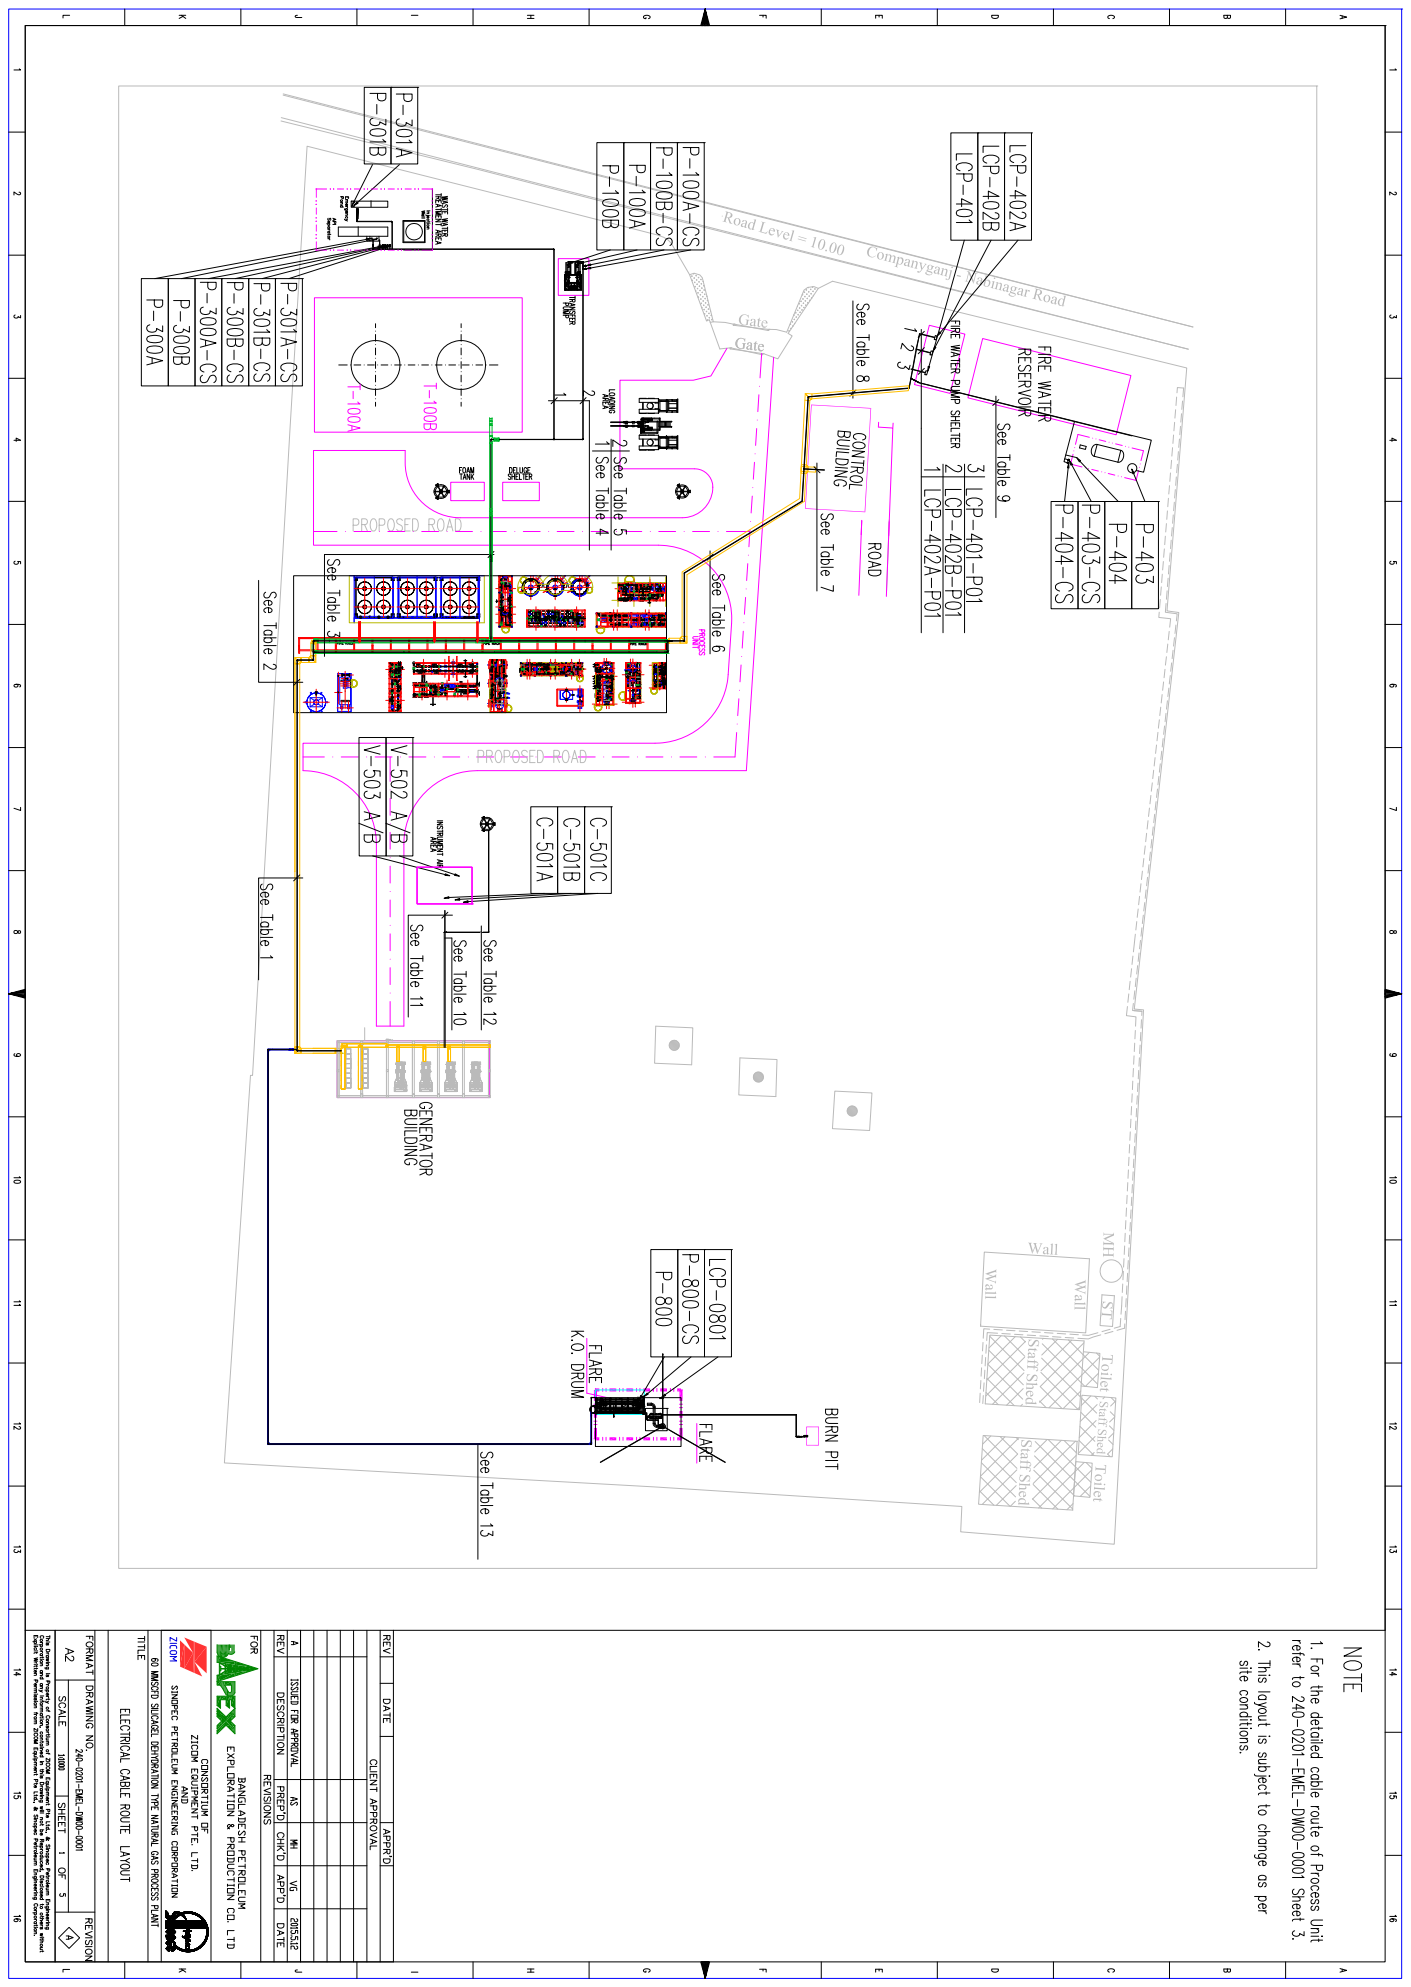
[picture p8: page 1]

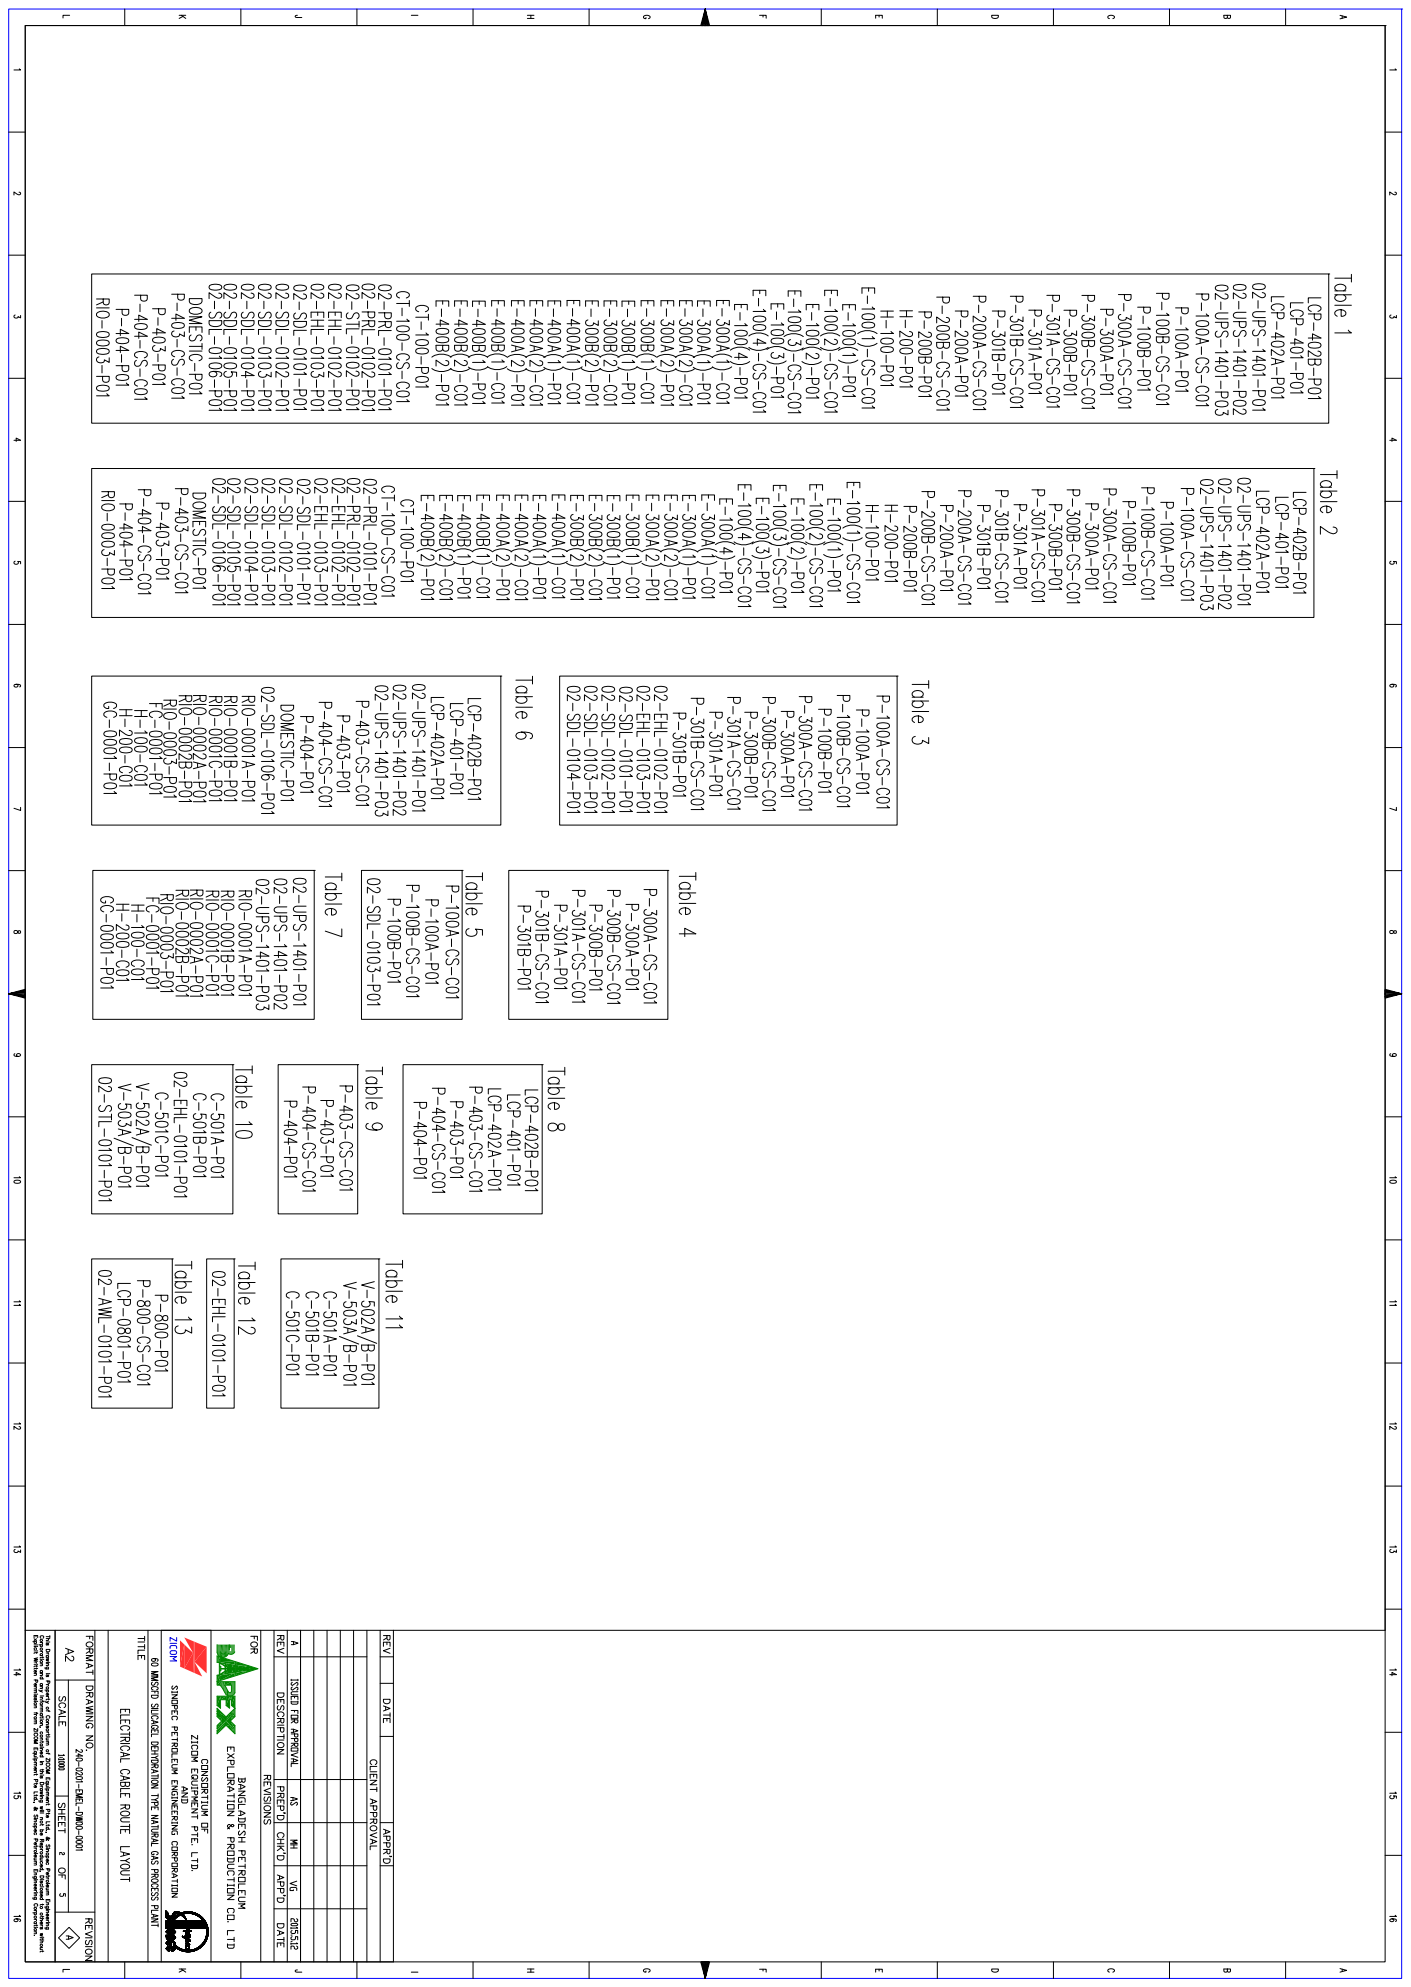
[picture p9: page 2]

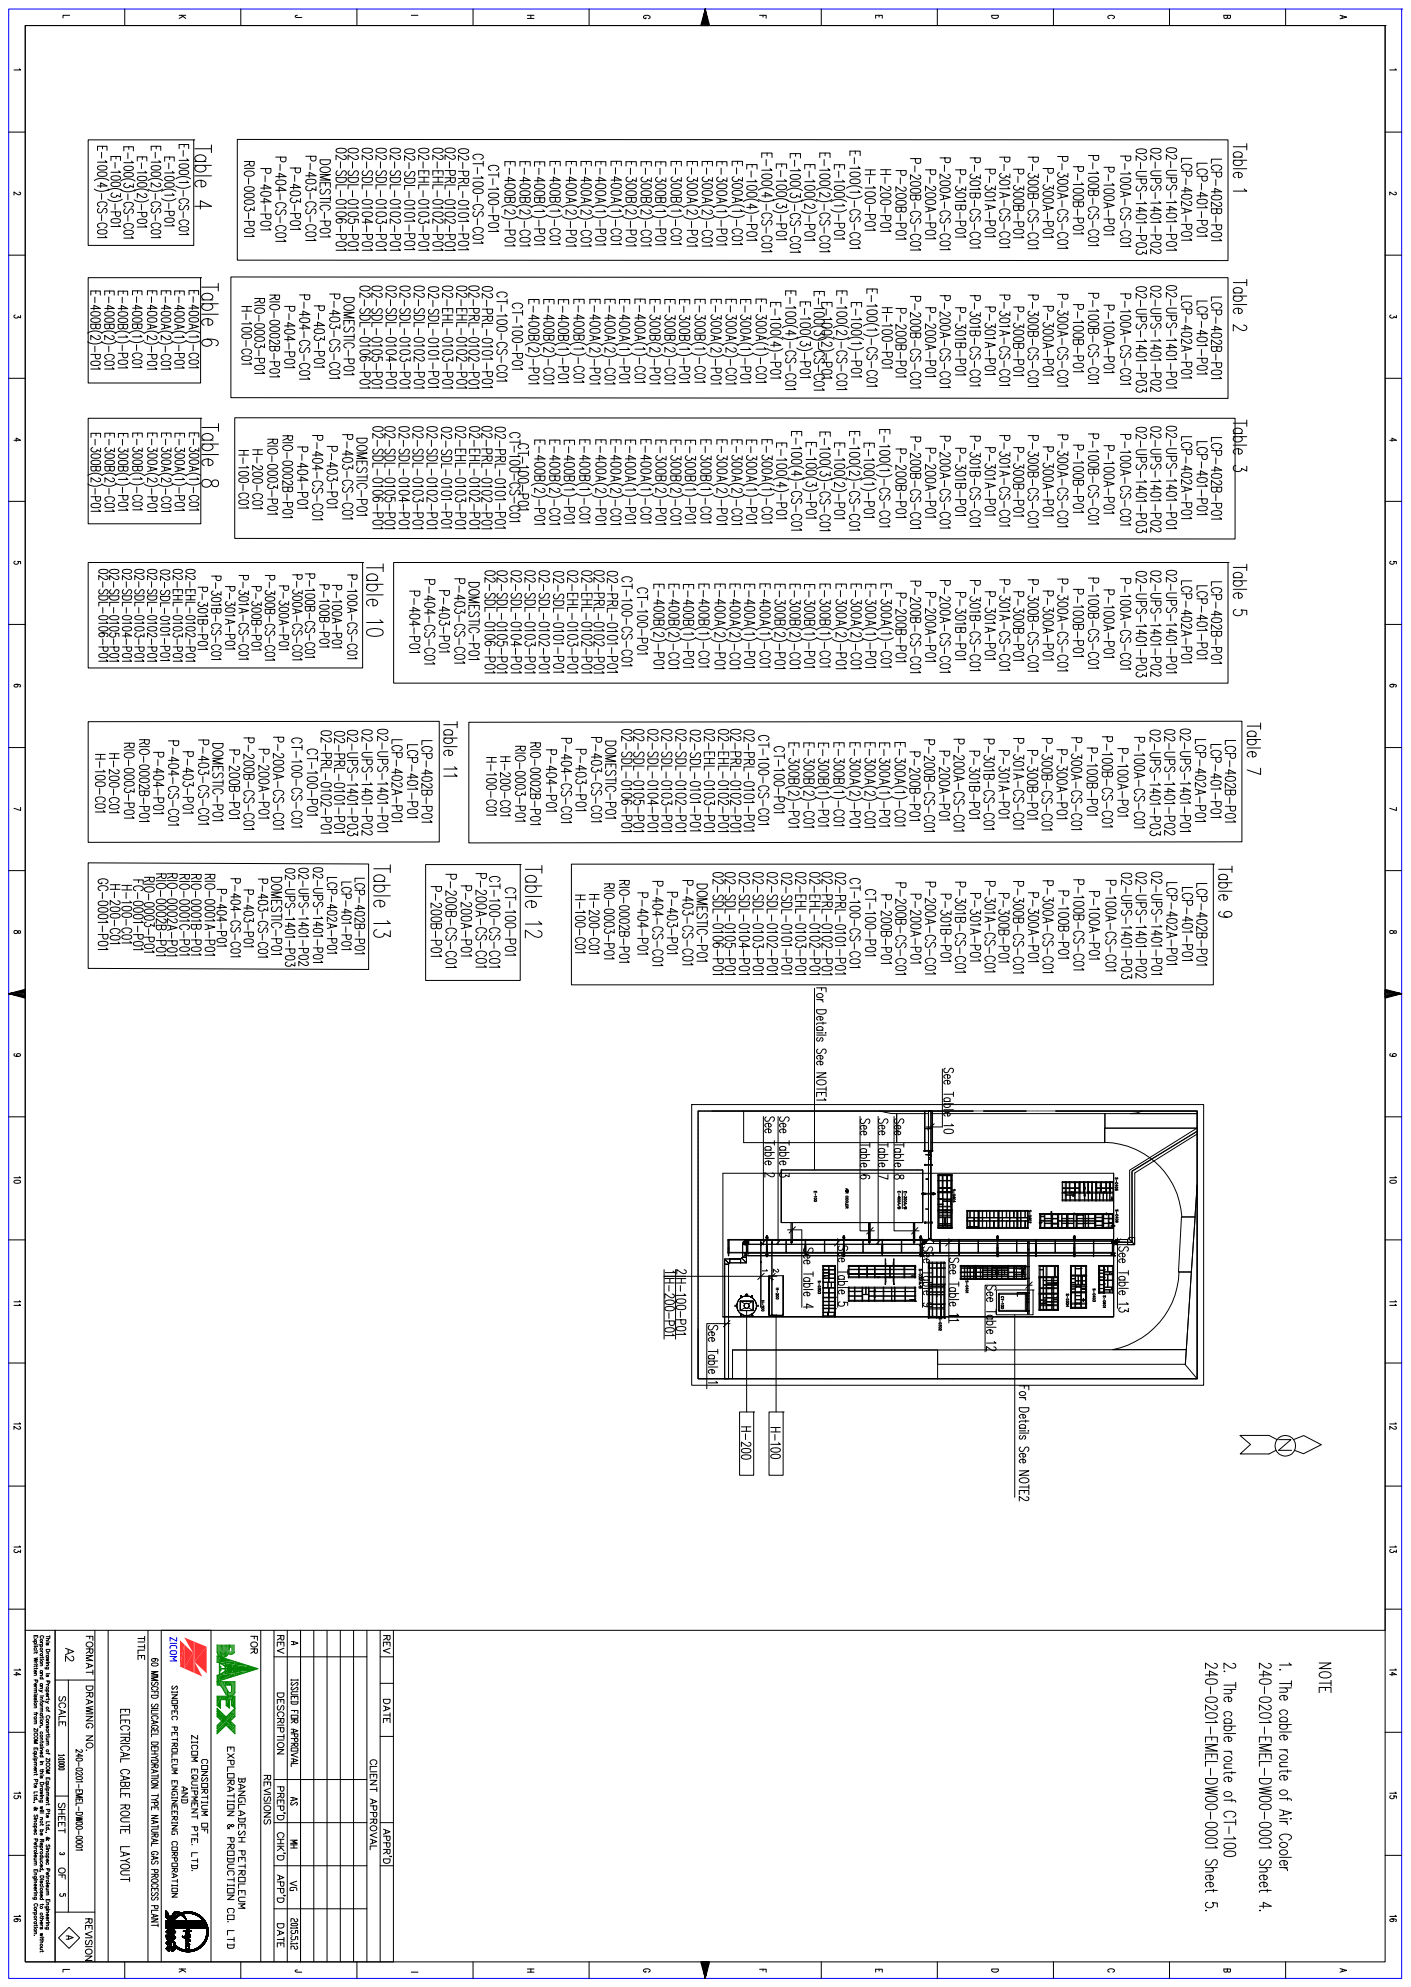
[picture p10: page 3]

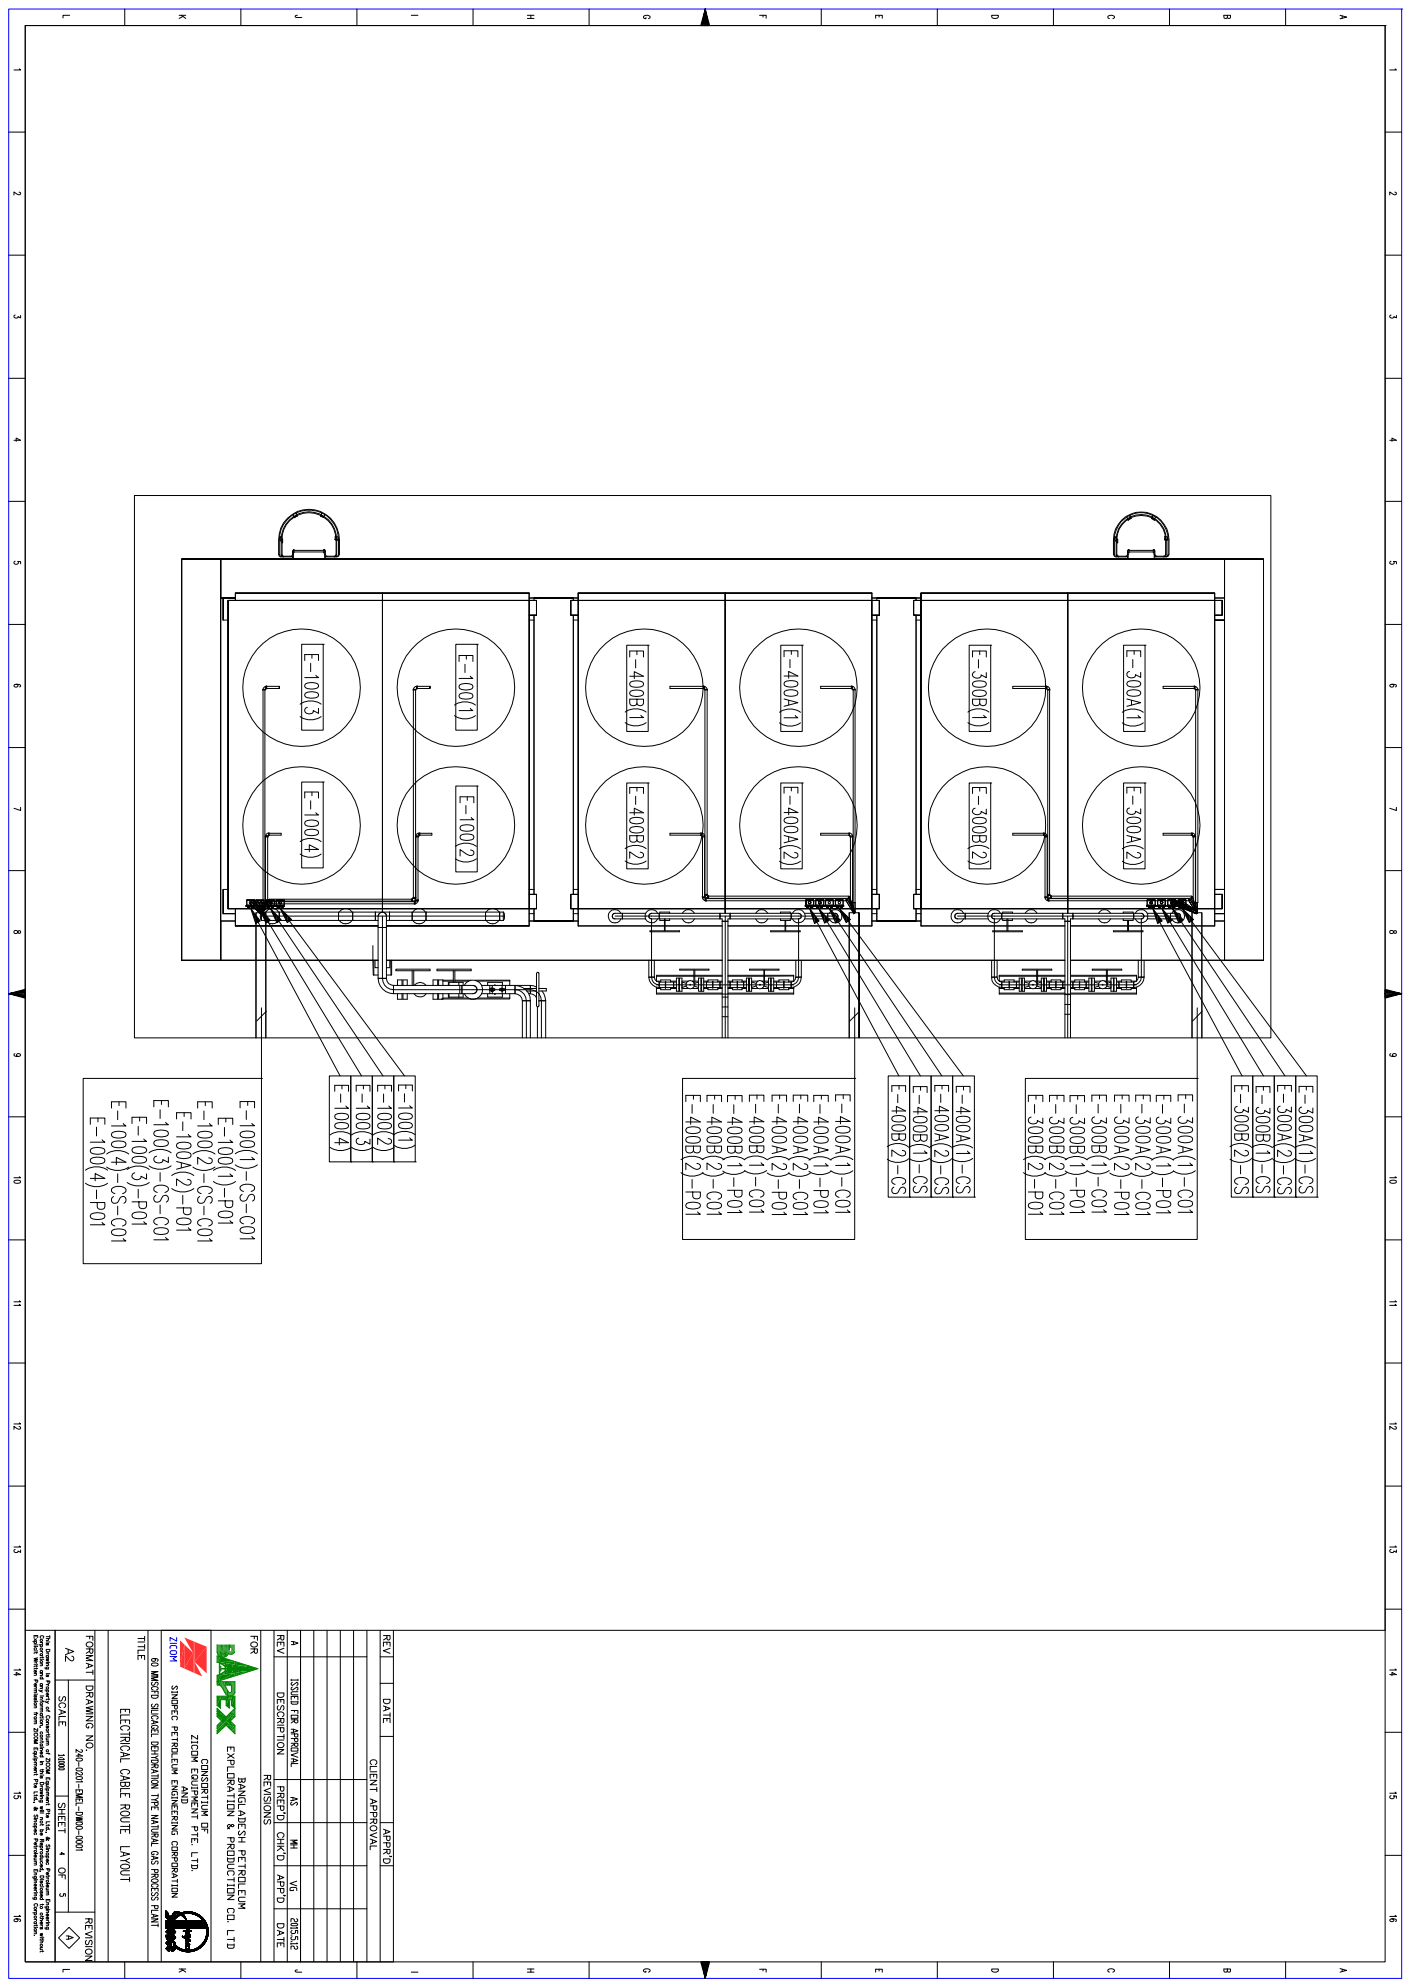
[picture p11: page 4]

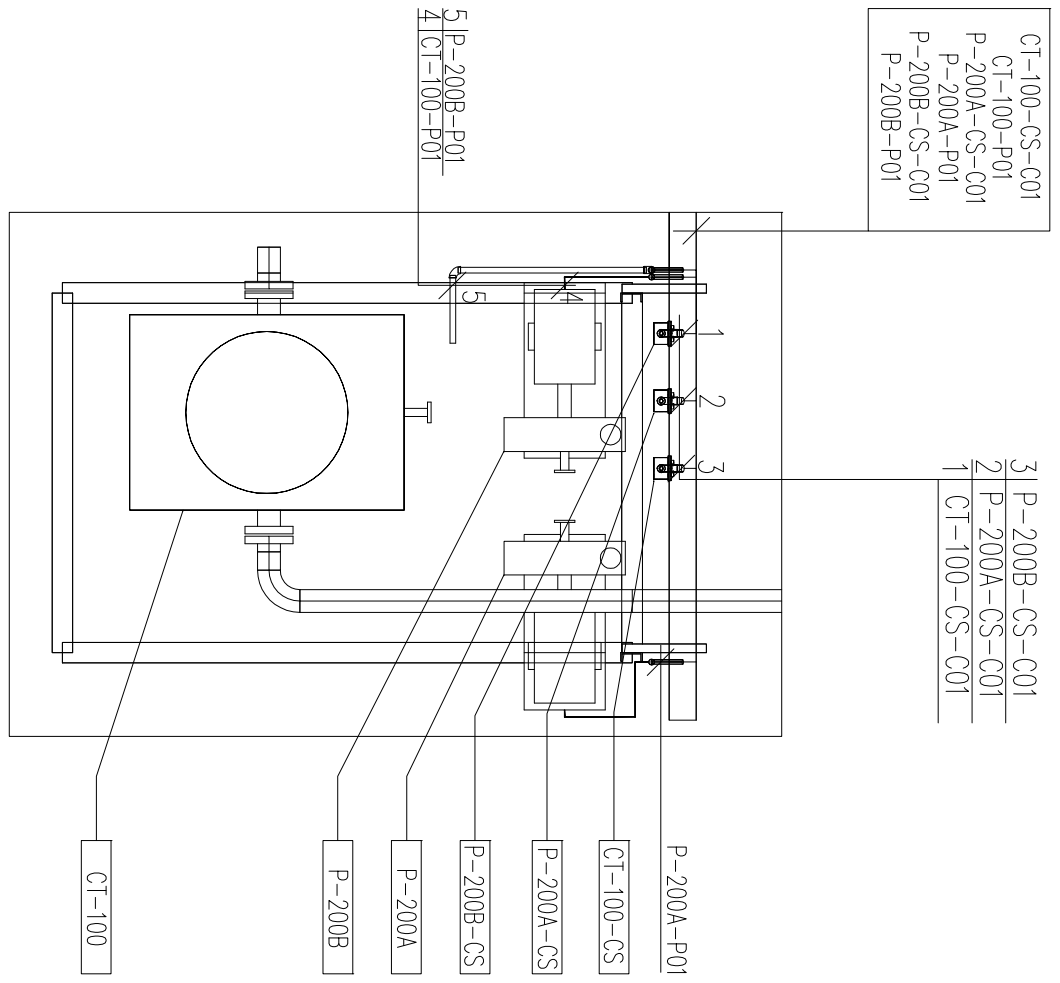
[picture p12: page 5]
