skdzicombd/P_240_Autocad_Docs/Cable Tray Layout/240-0201-EMEL-DW00-0005_A - Cable Tray Layout.pdf

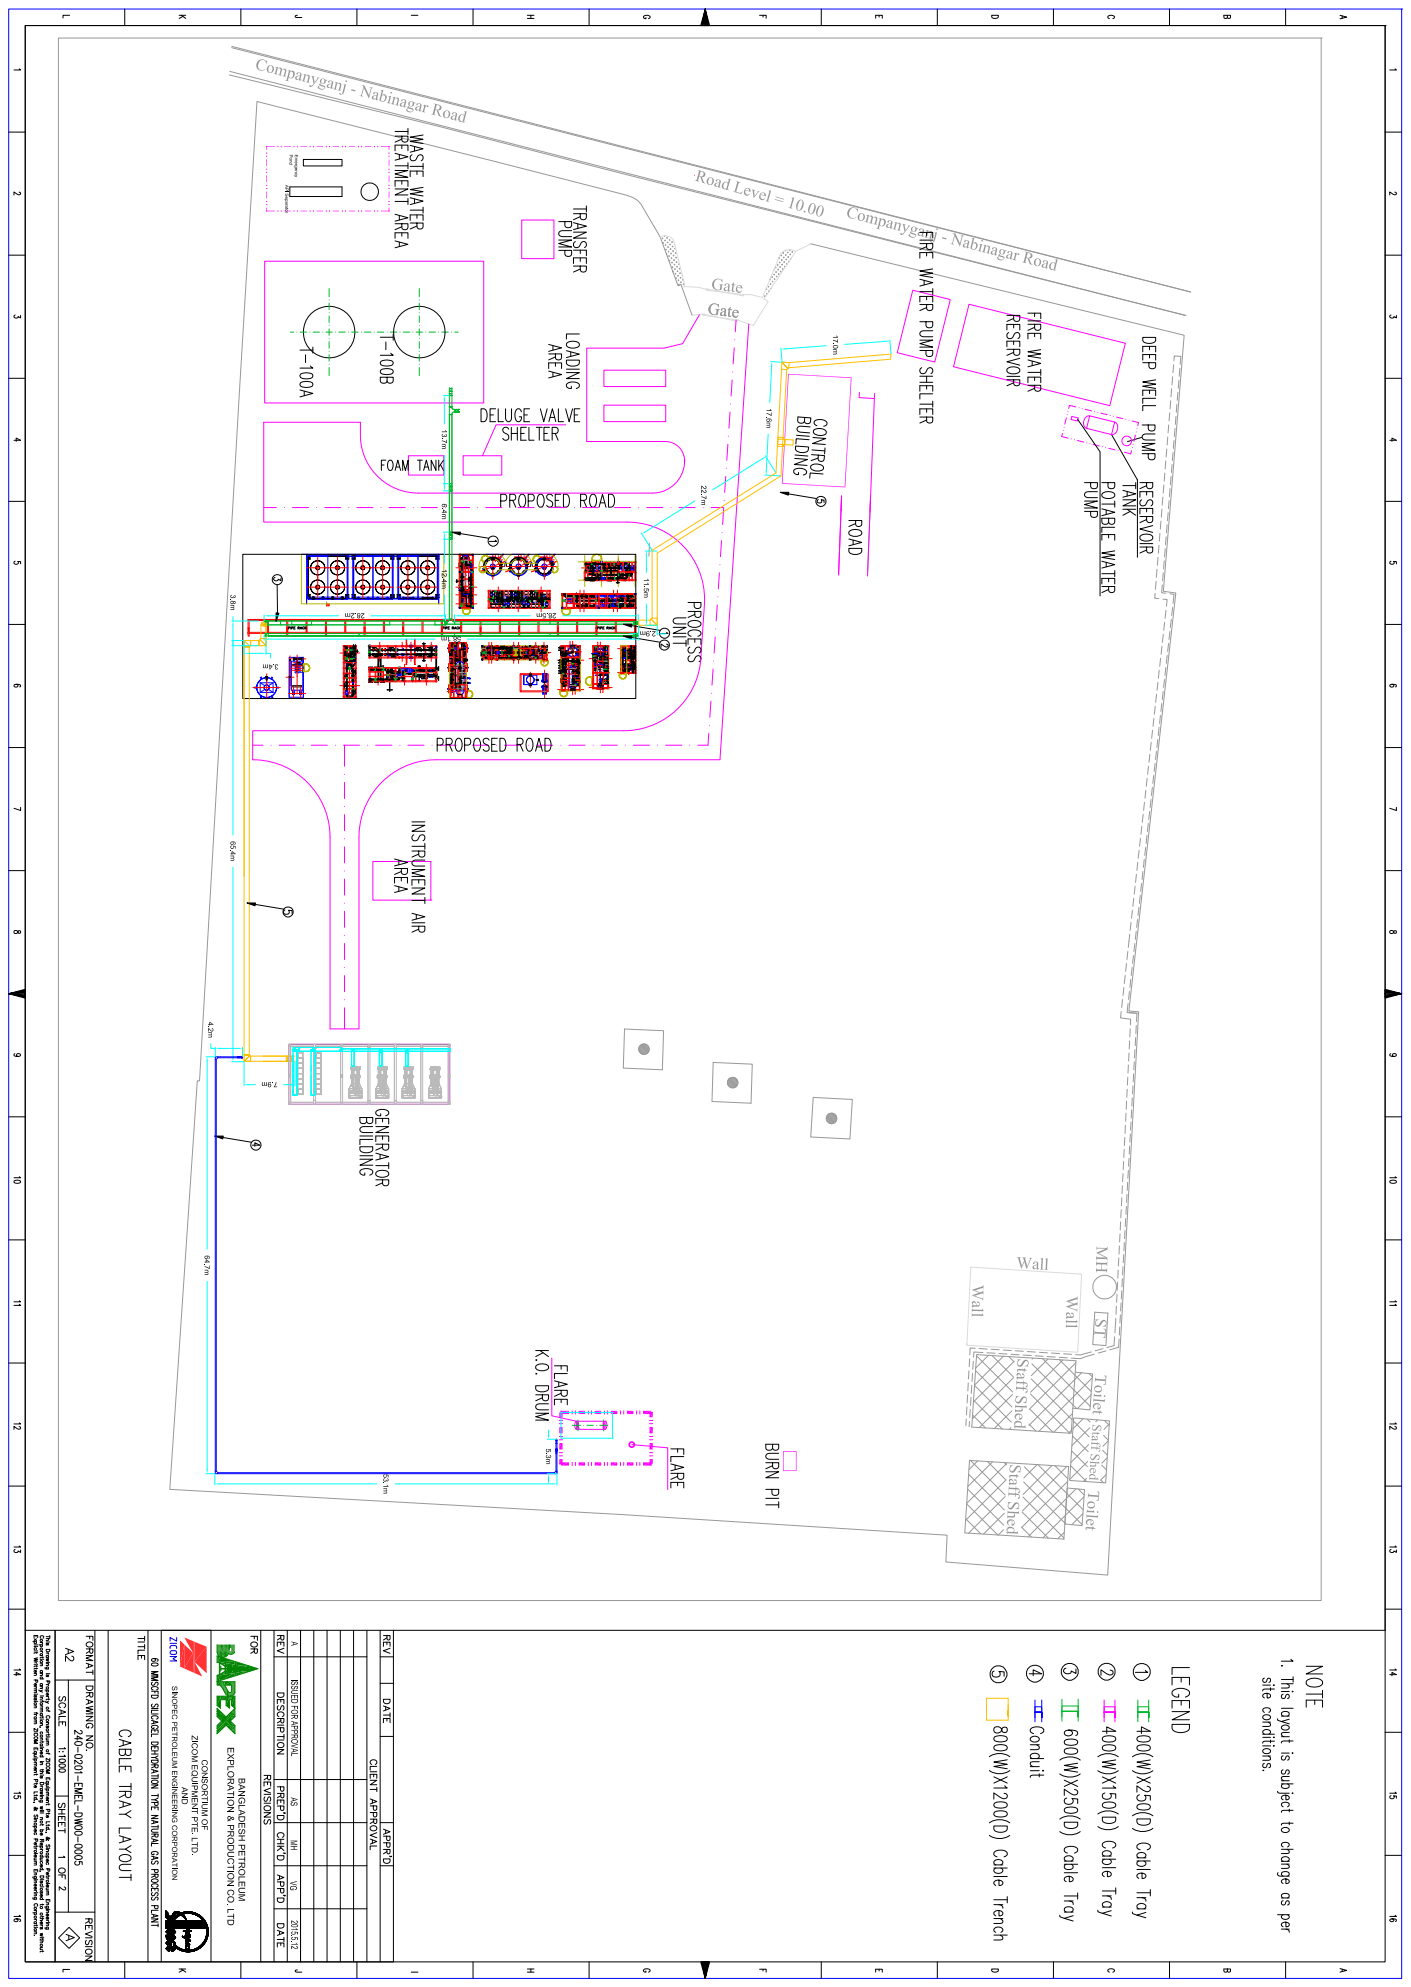
[picture p13: page 1]

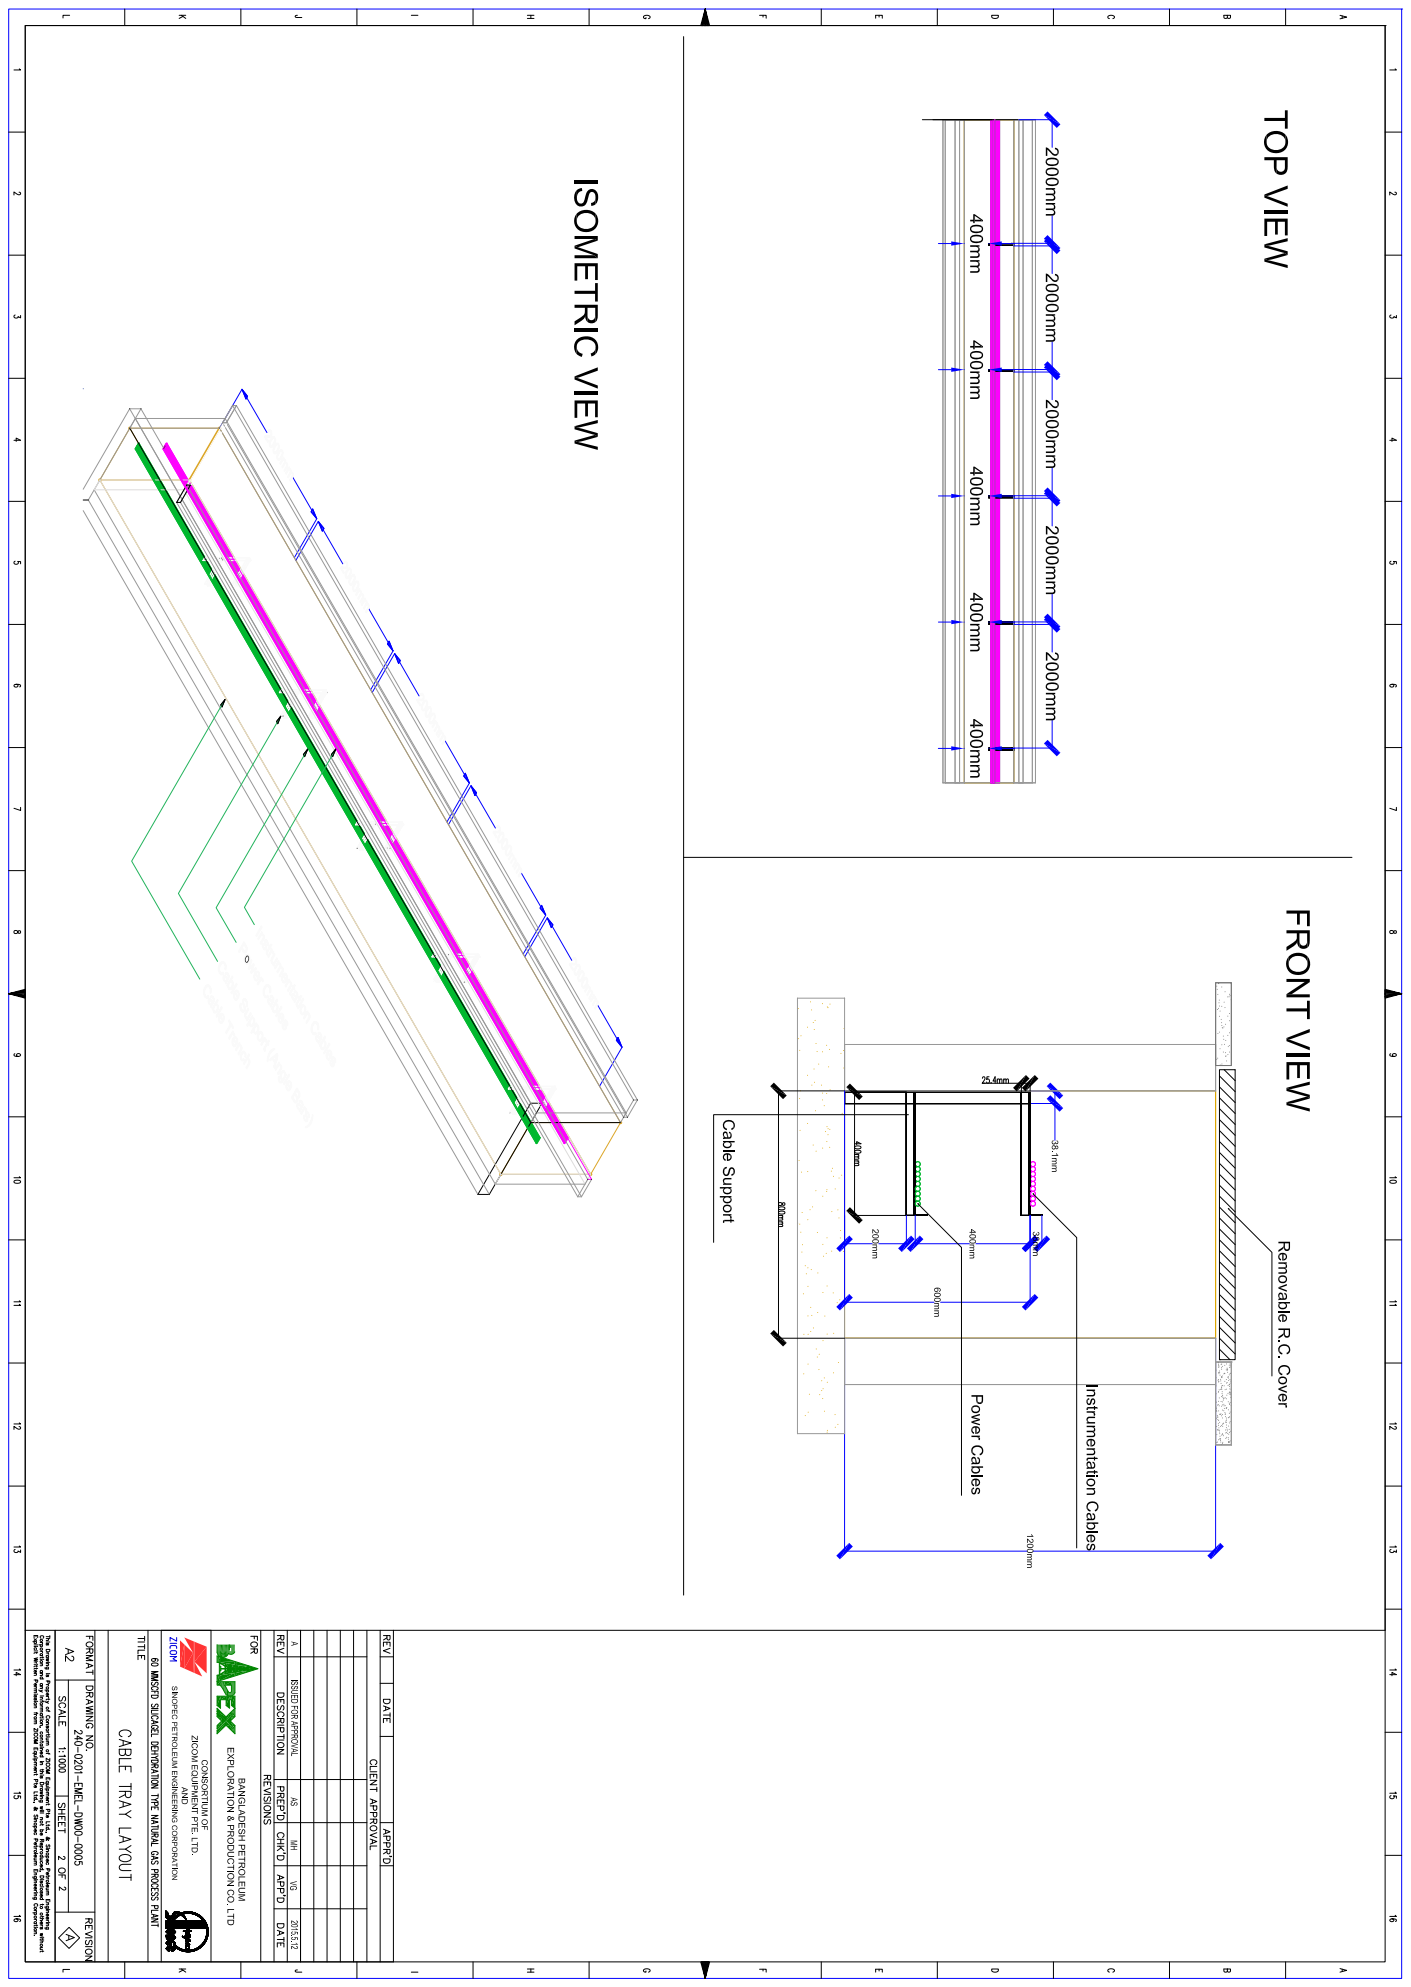
[picture p14: page 2]
