skdzicombd/P_240_Autocad_Docs/Earthing Diagram/240-0201-EMEL-DW00-0004_A - Earthing Layout.pdf

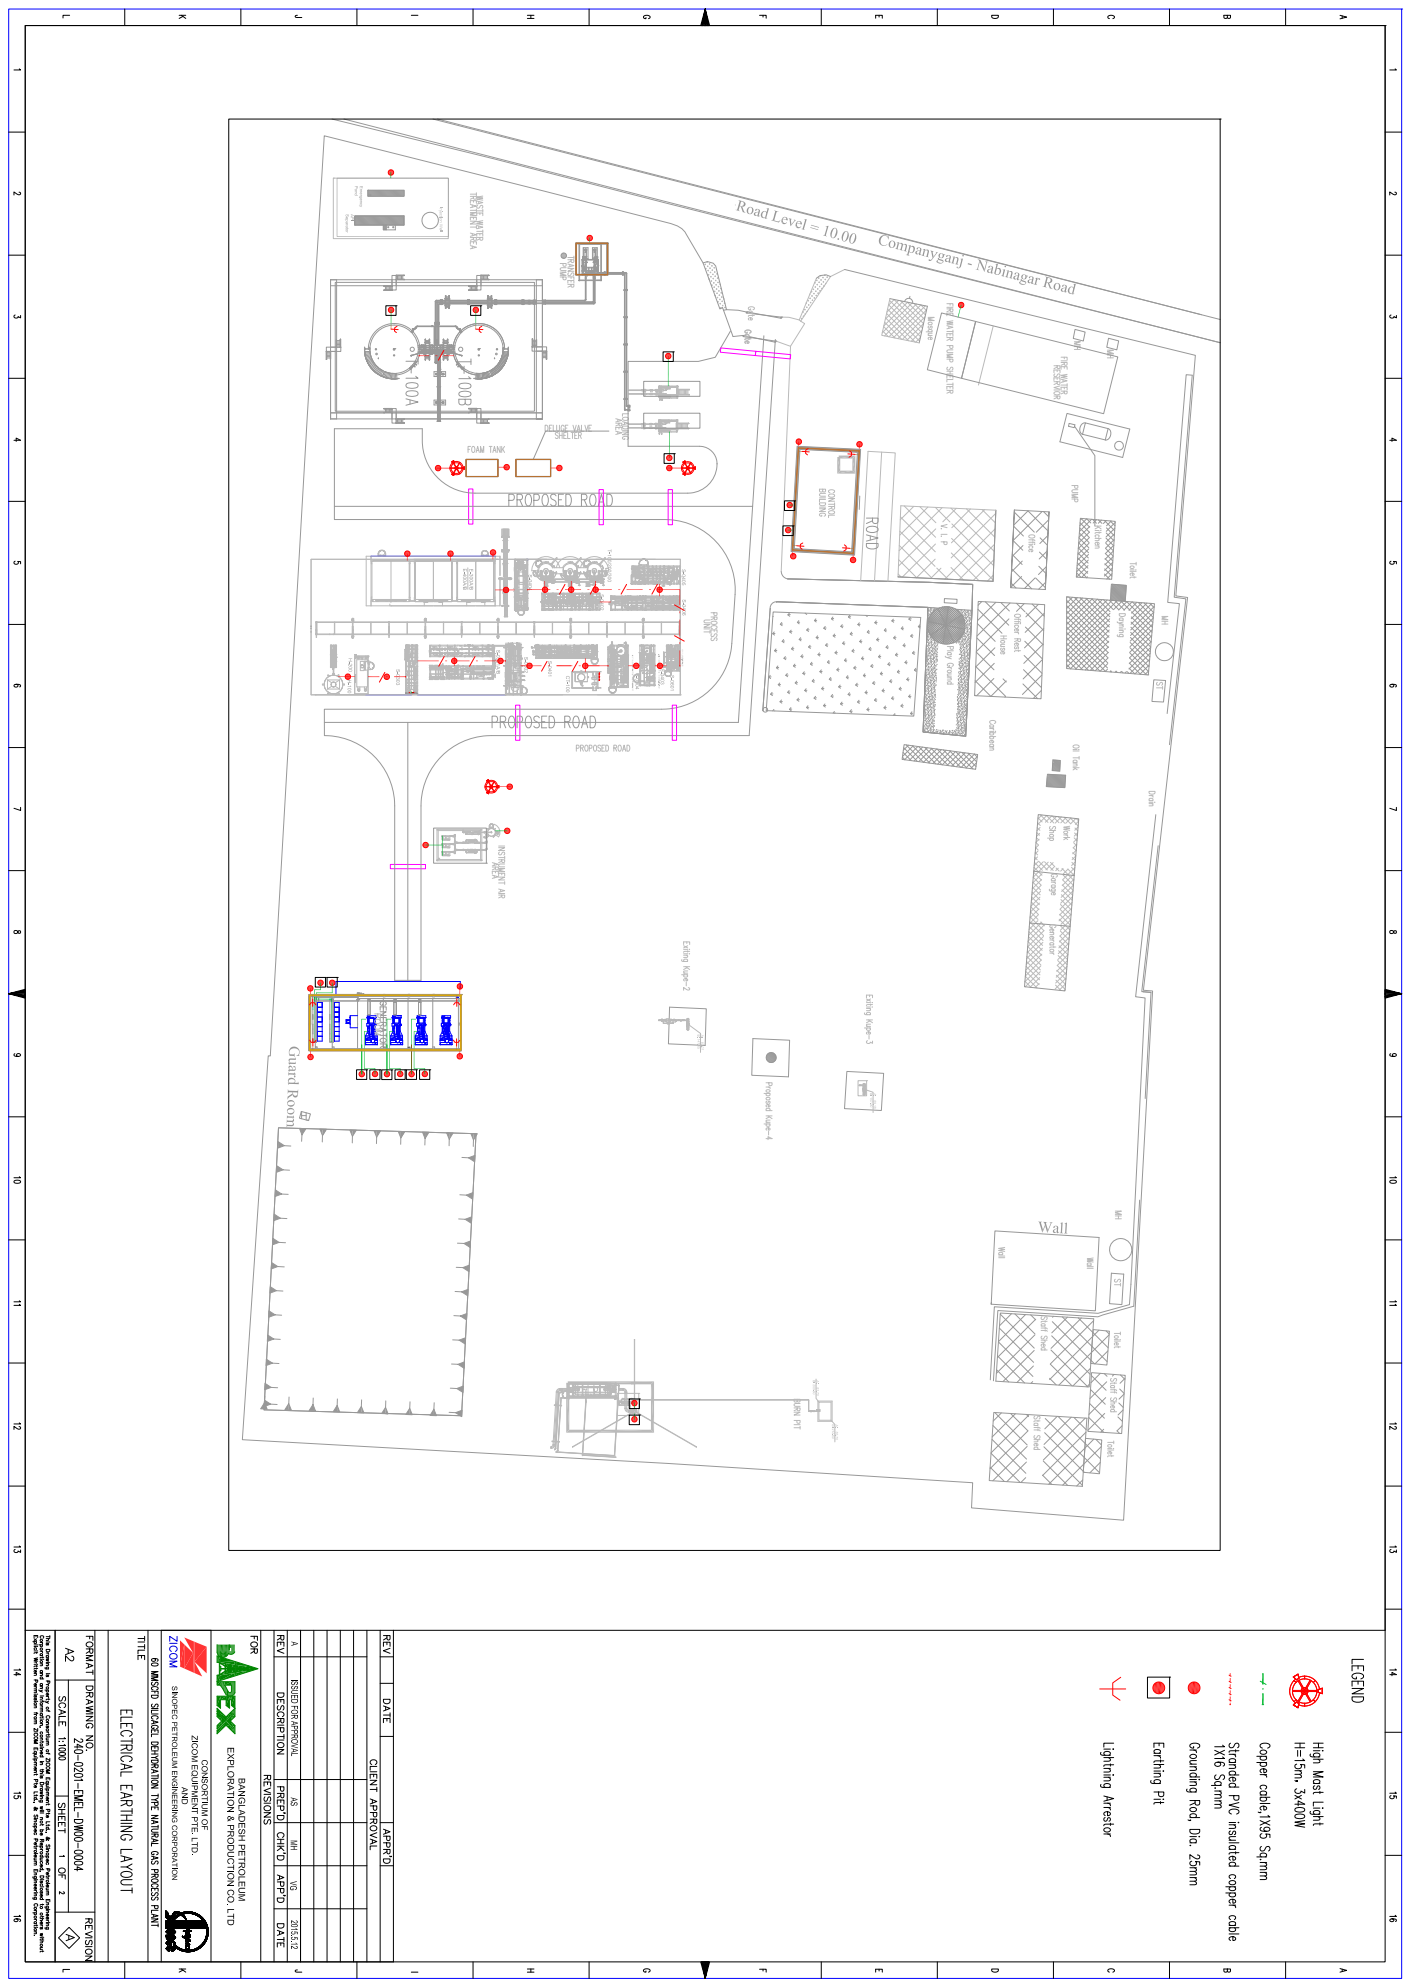
[picture p15: page 1]

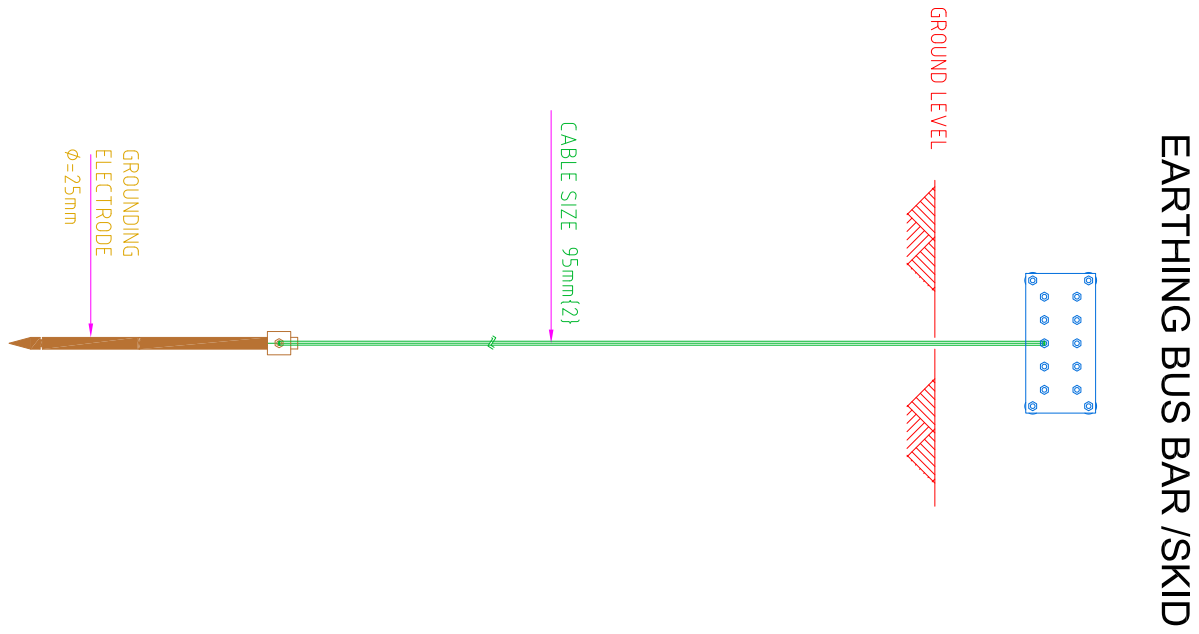
[picture p16: page 2]
