skdzicombd/P_240_Autocad_Docs/Lighting System Layout/240-0201-EMEL-DW00-0002_A - Lighting System Layout.pdf

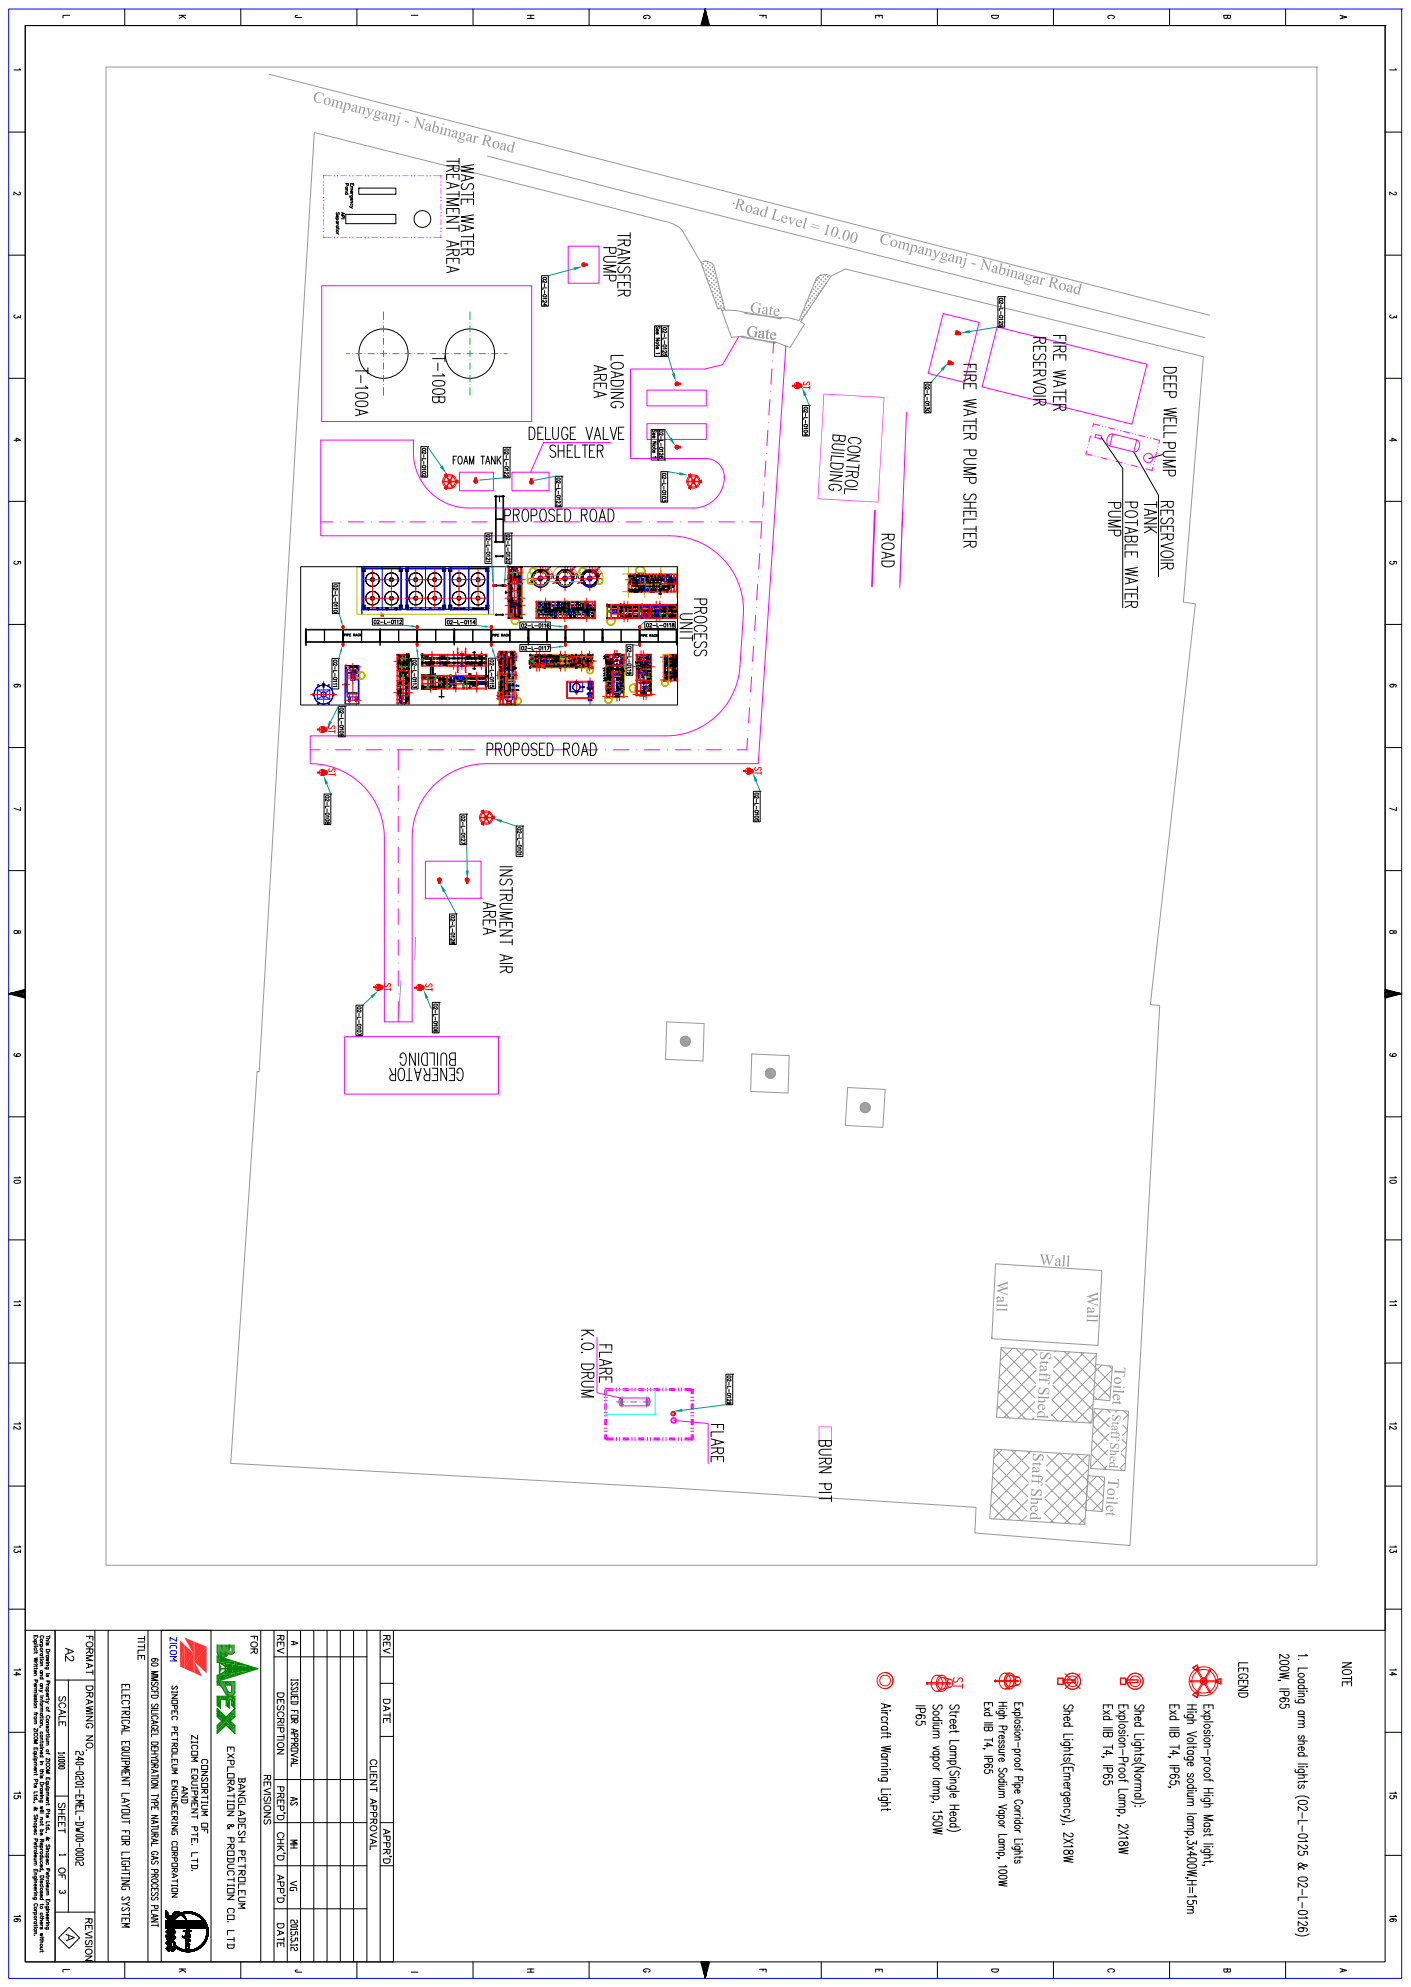
[picture p17: page 1]

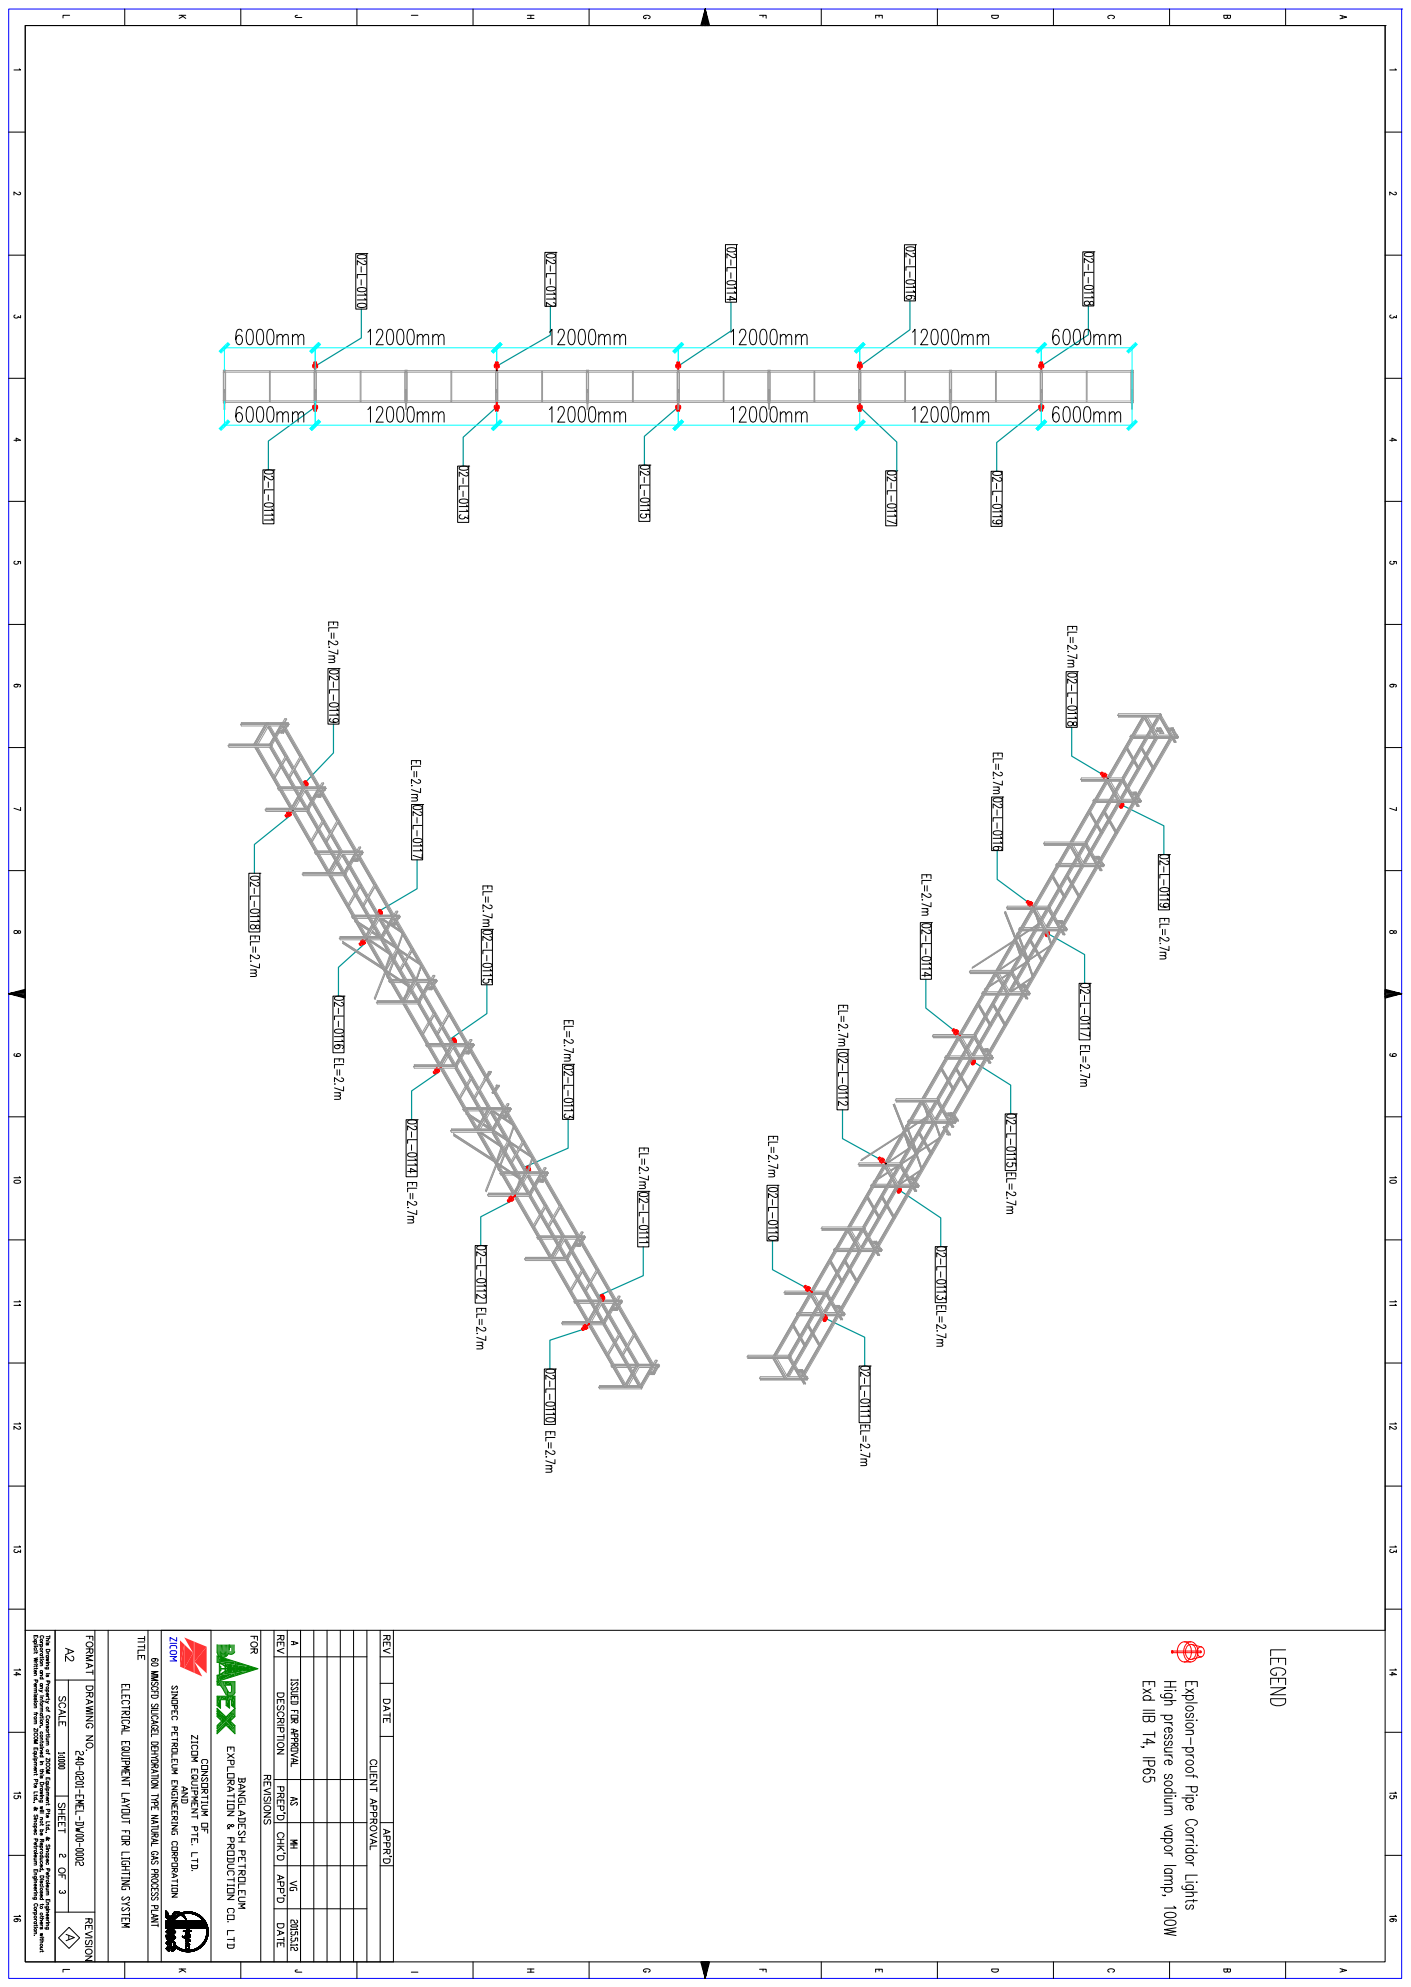
[picture p18: page 2]

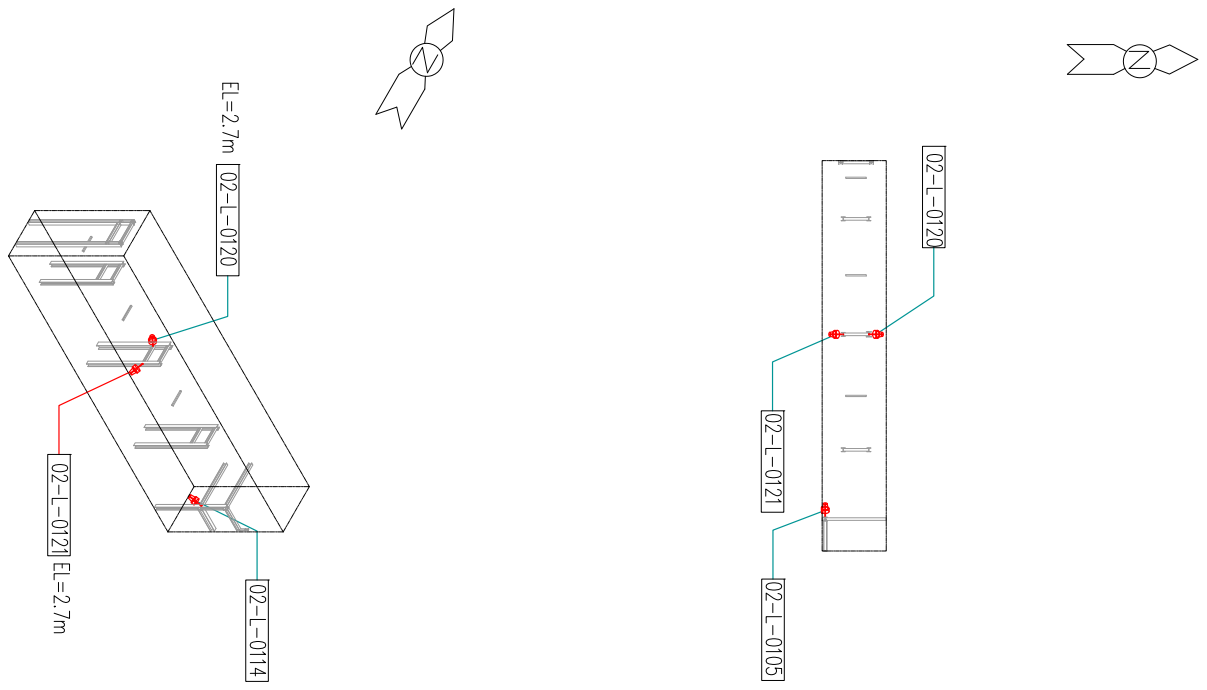
[picture p19: page 3]
