skdzicombd/P_240_Autocad_Docs/Single Line Diagrams (SLD)/240-0214-EMEL-DW00-0001 & 240-0214-EMEL-DW00-0002_A - Single Line Diagram for MCC.pdf

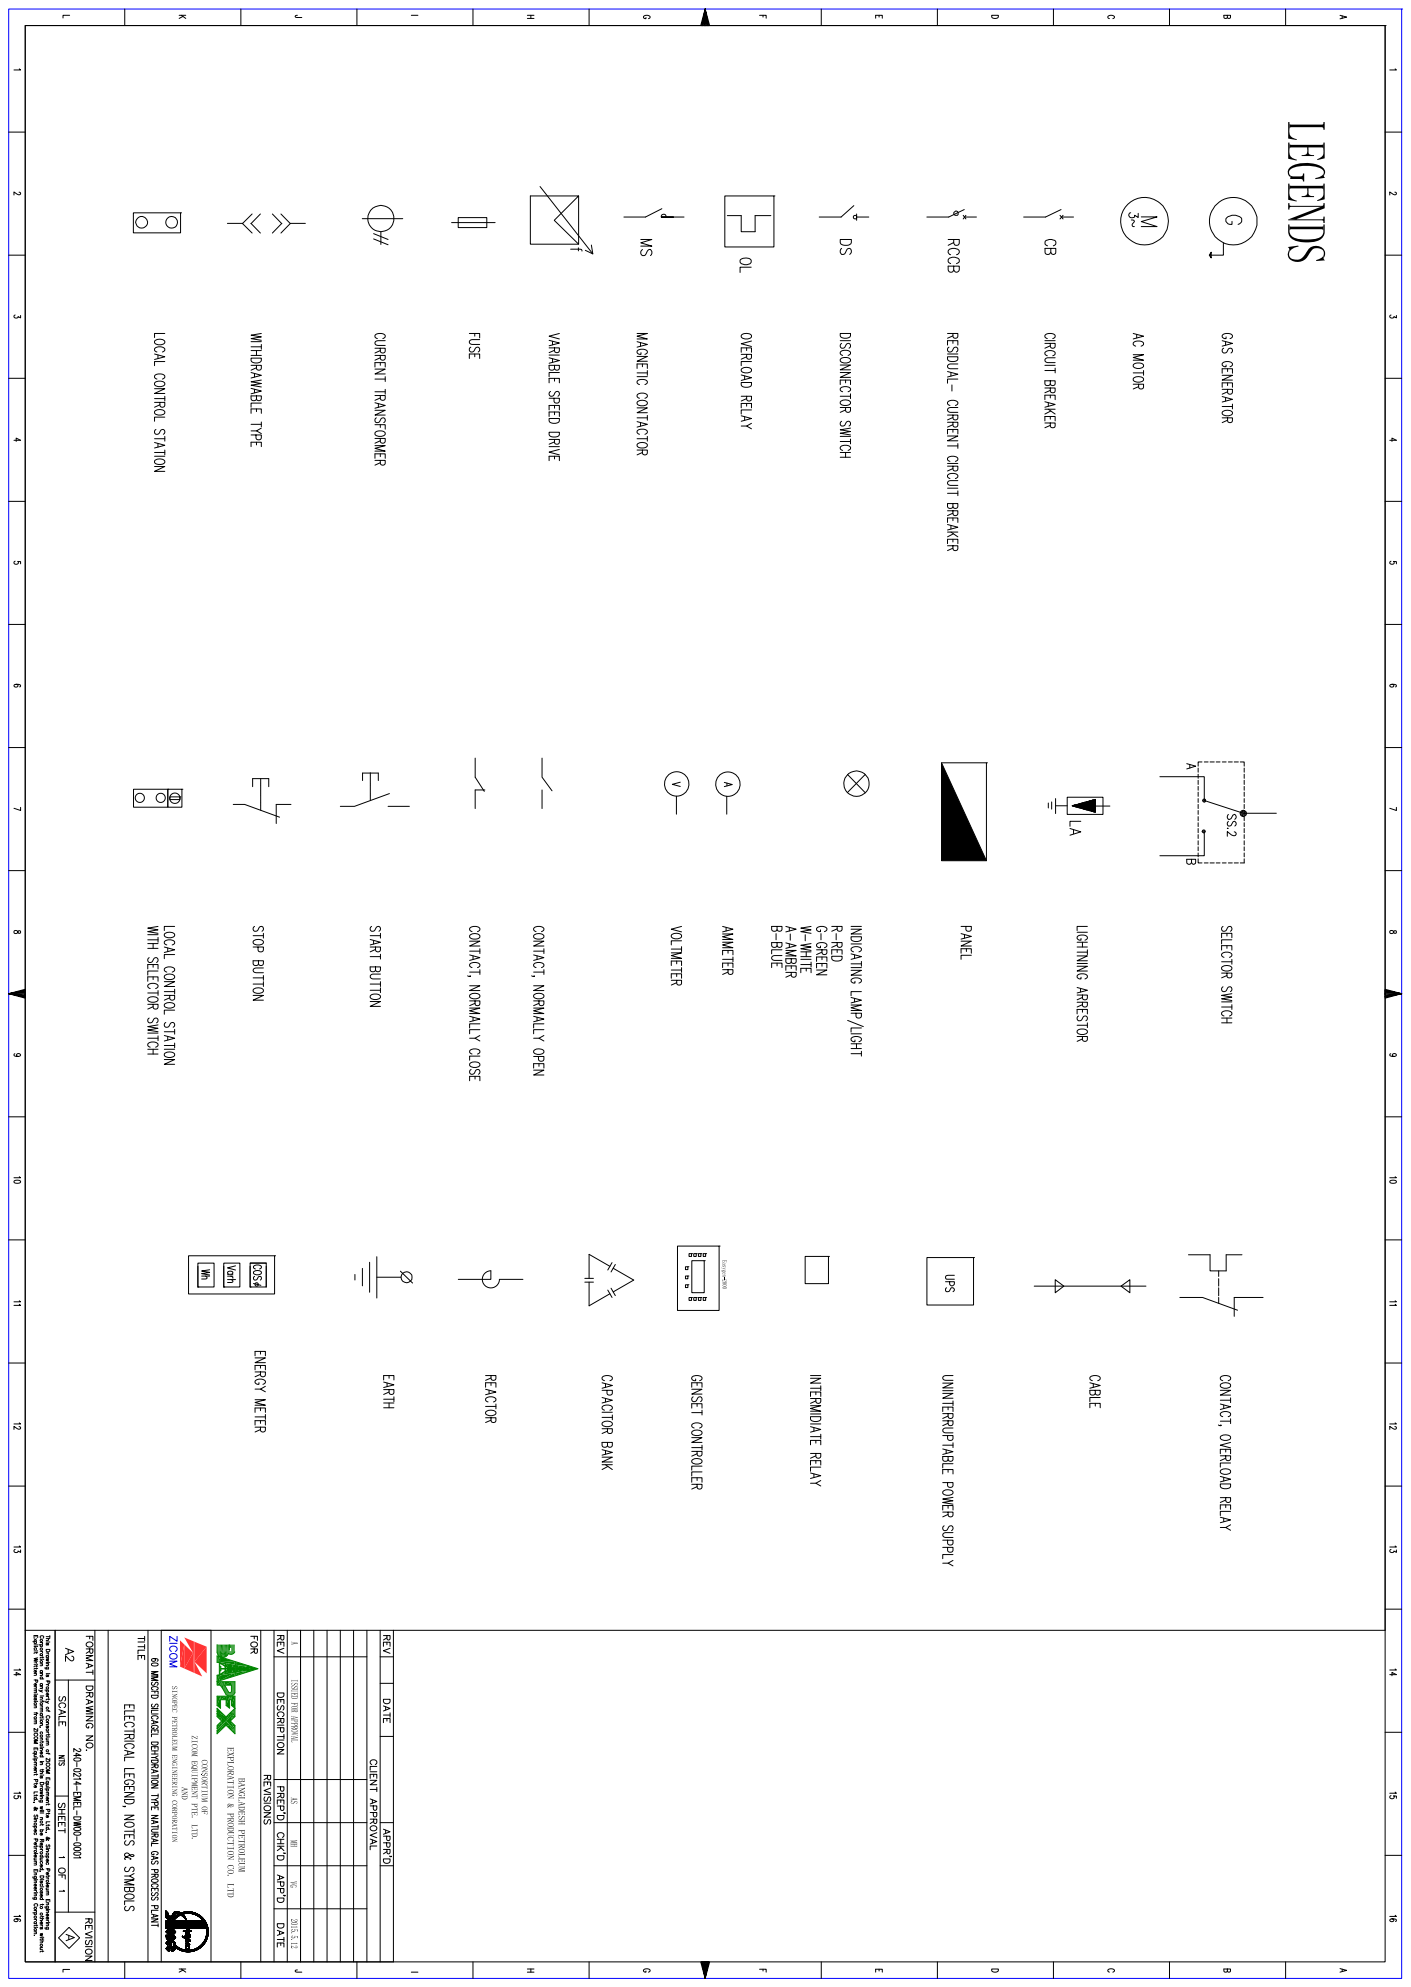
[picture p20: page 1]

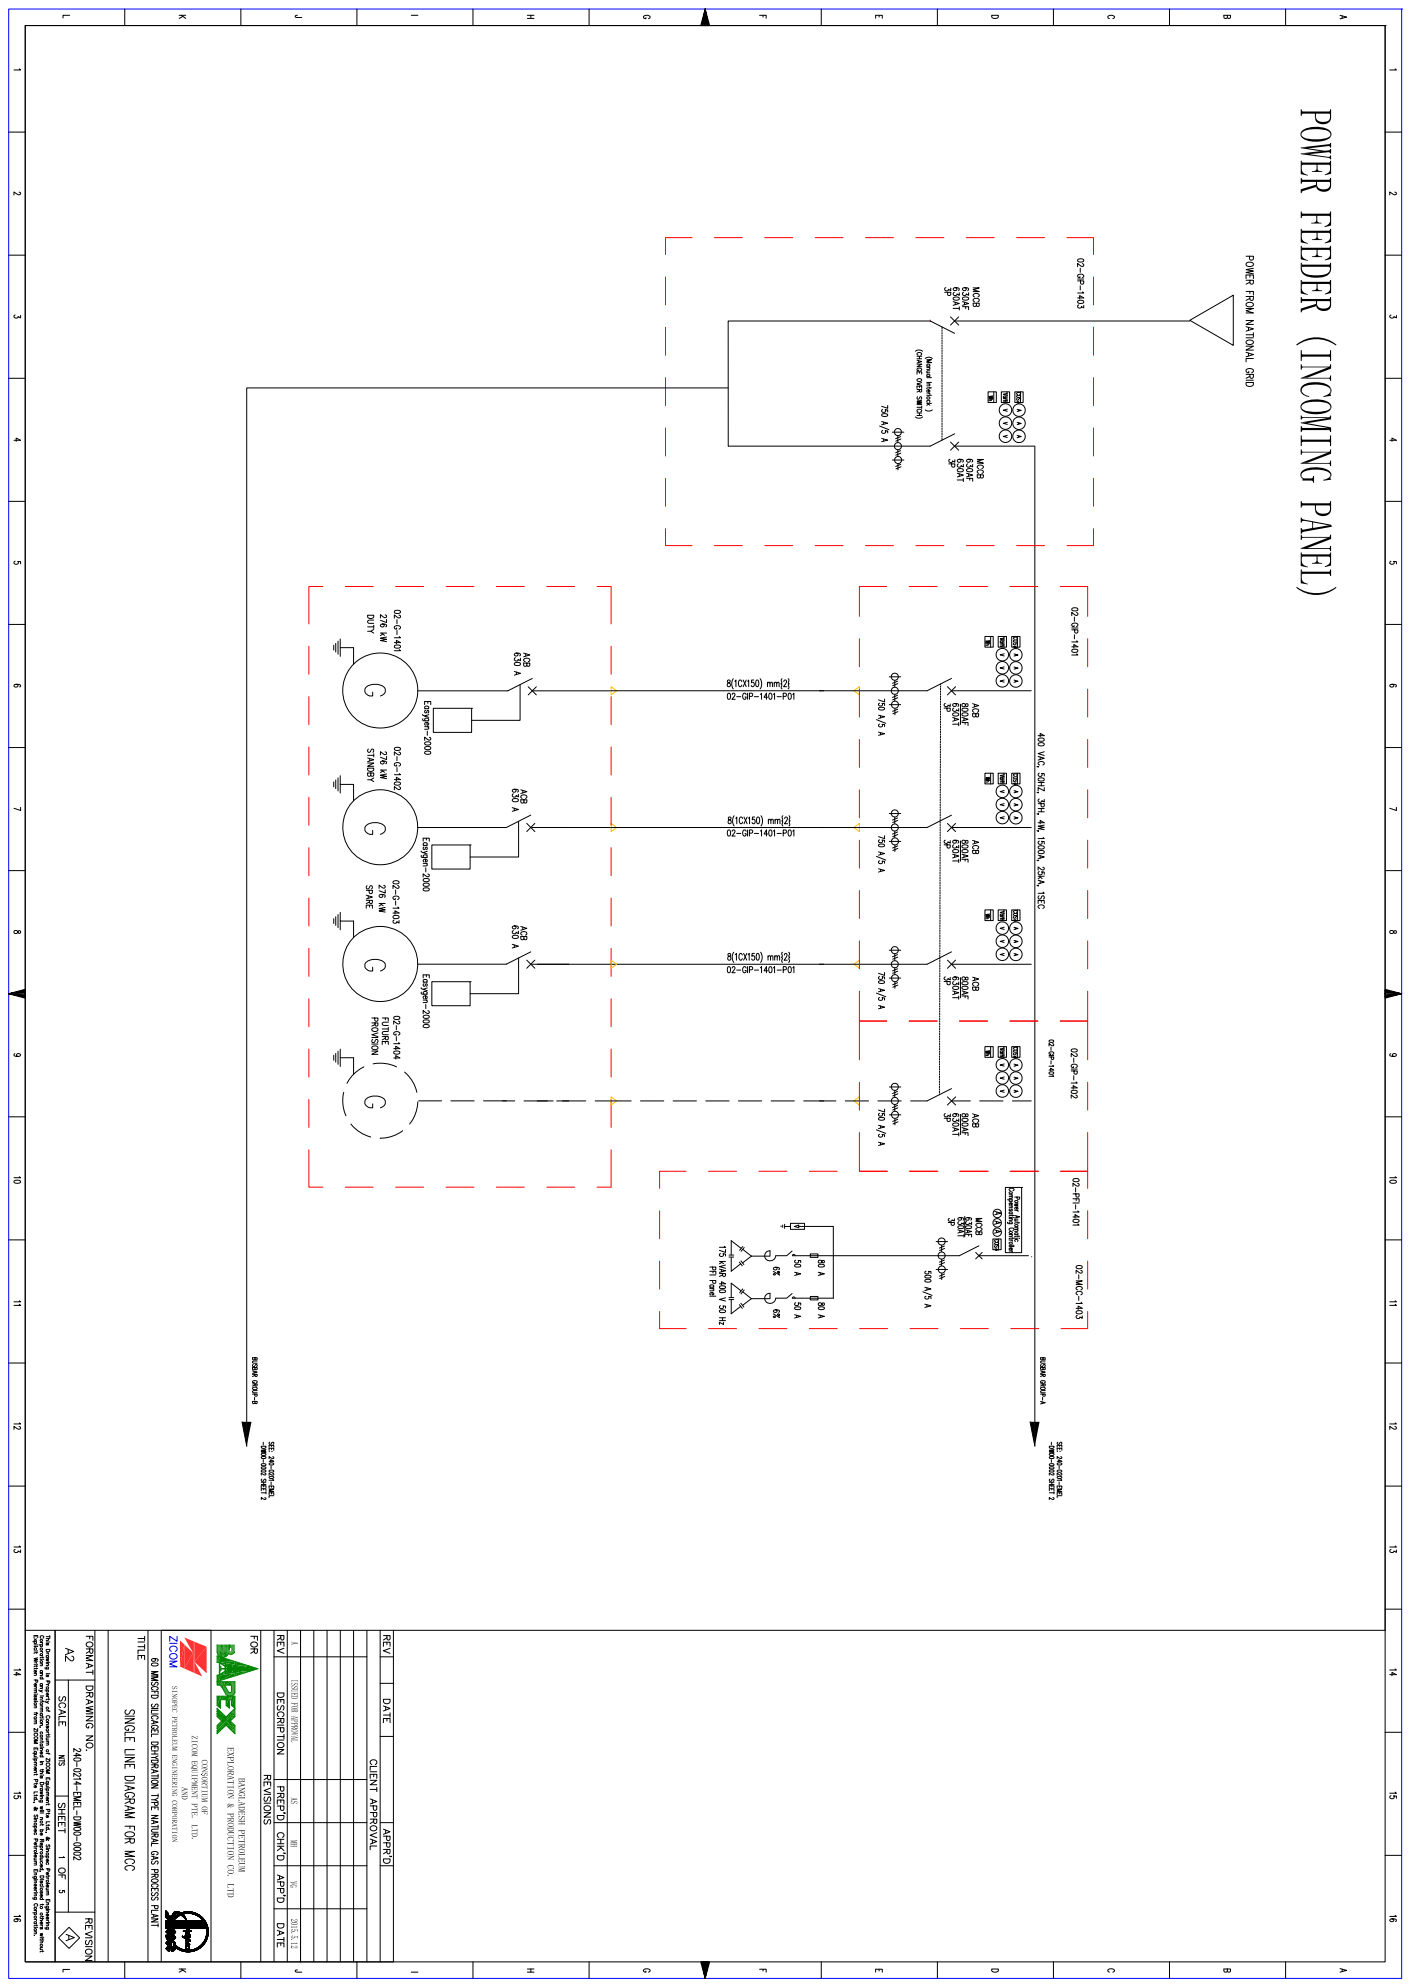
[picture p21: page 2]

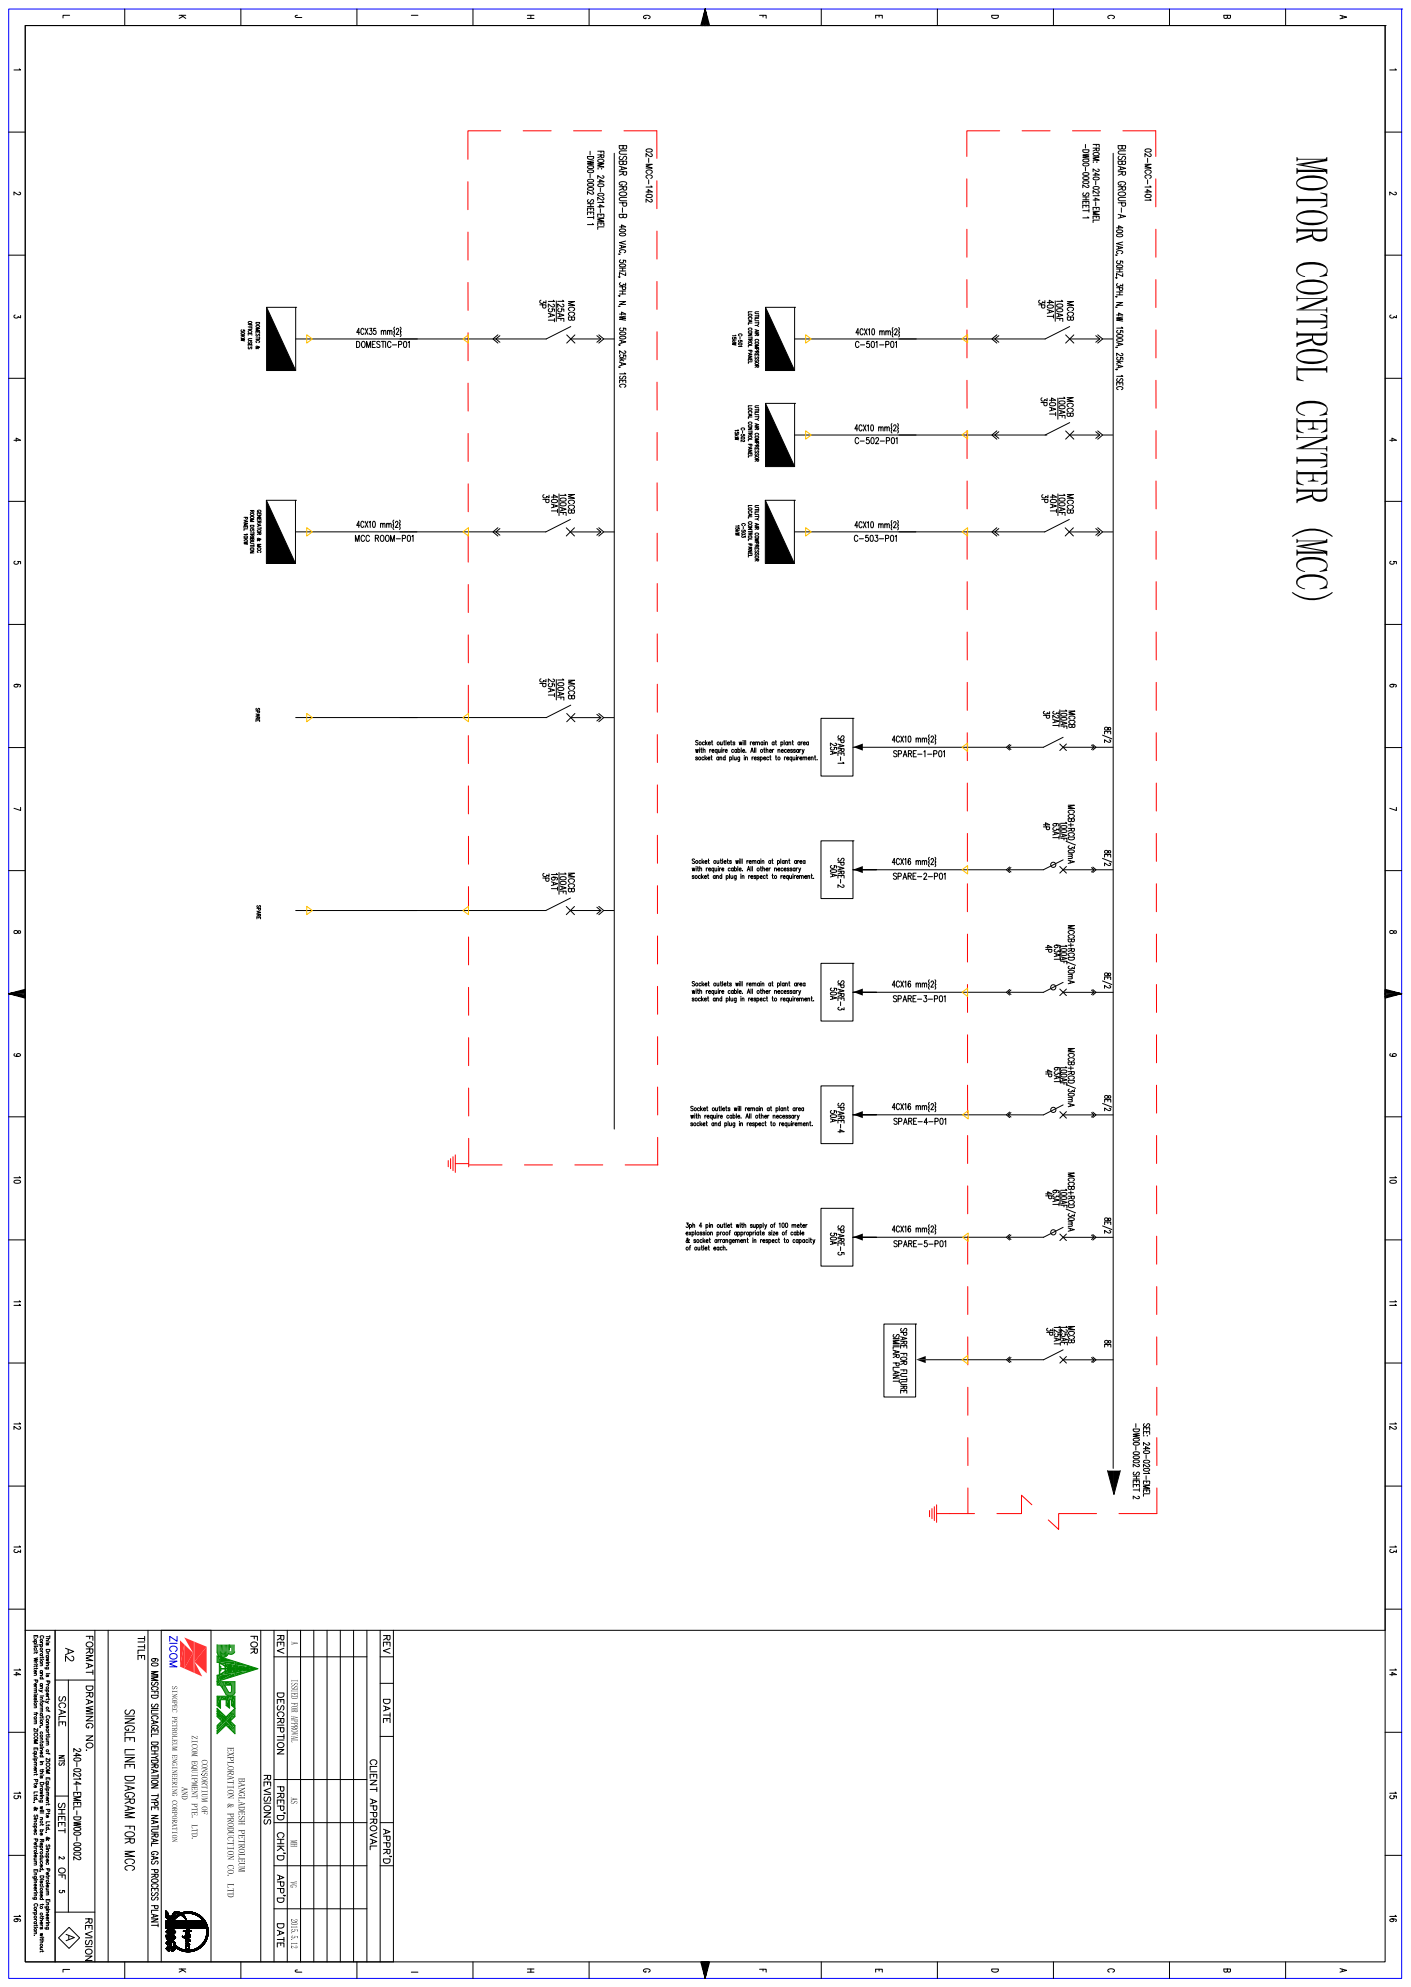
[picture p22: page 3]

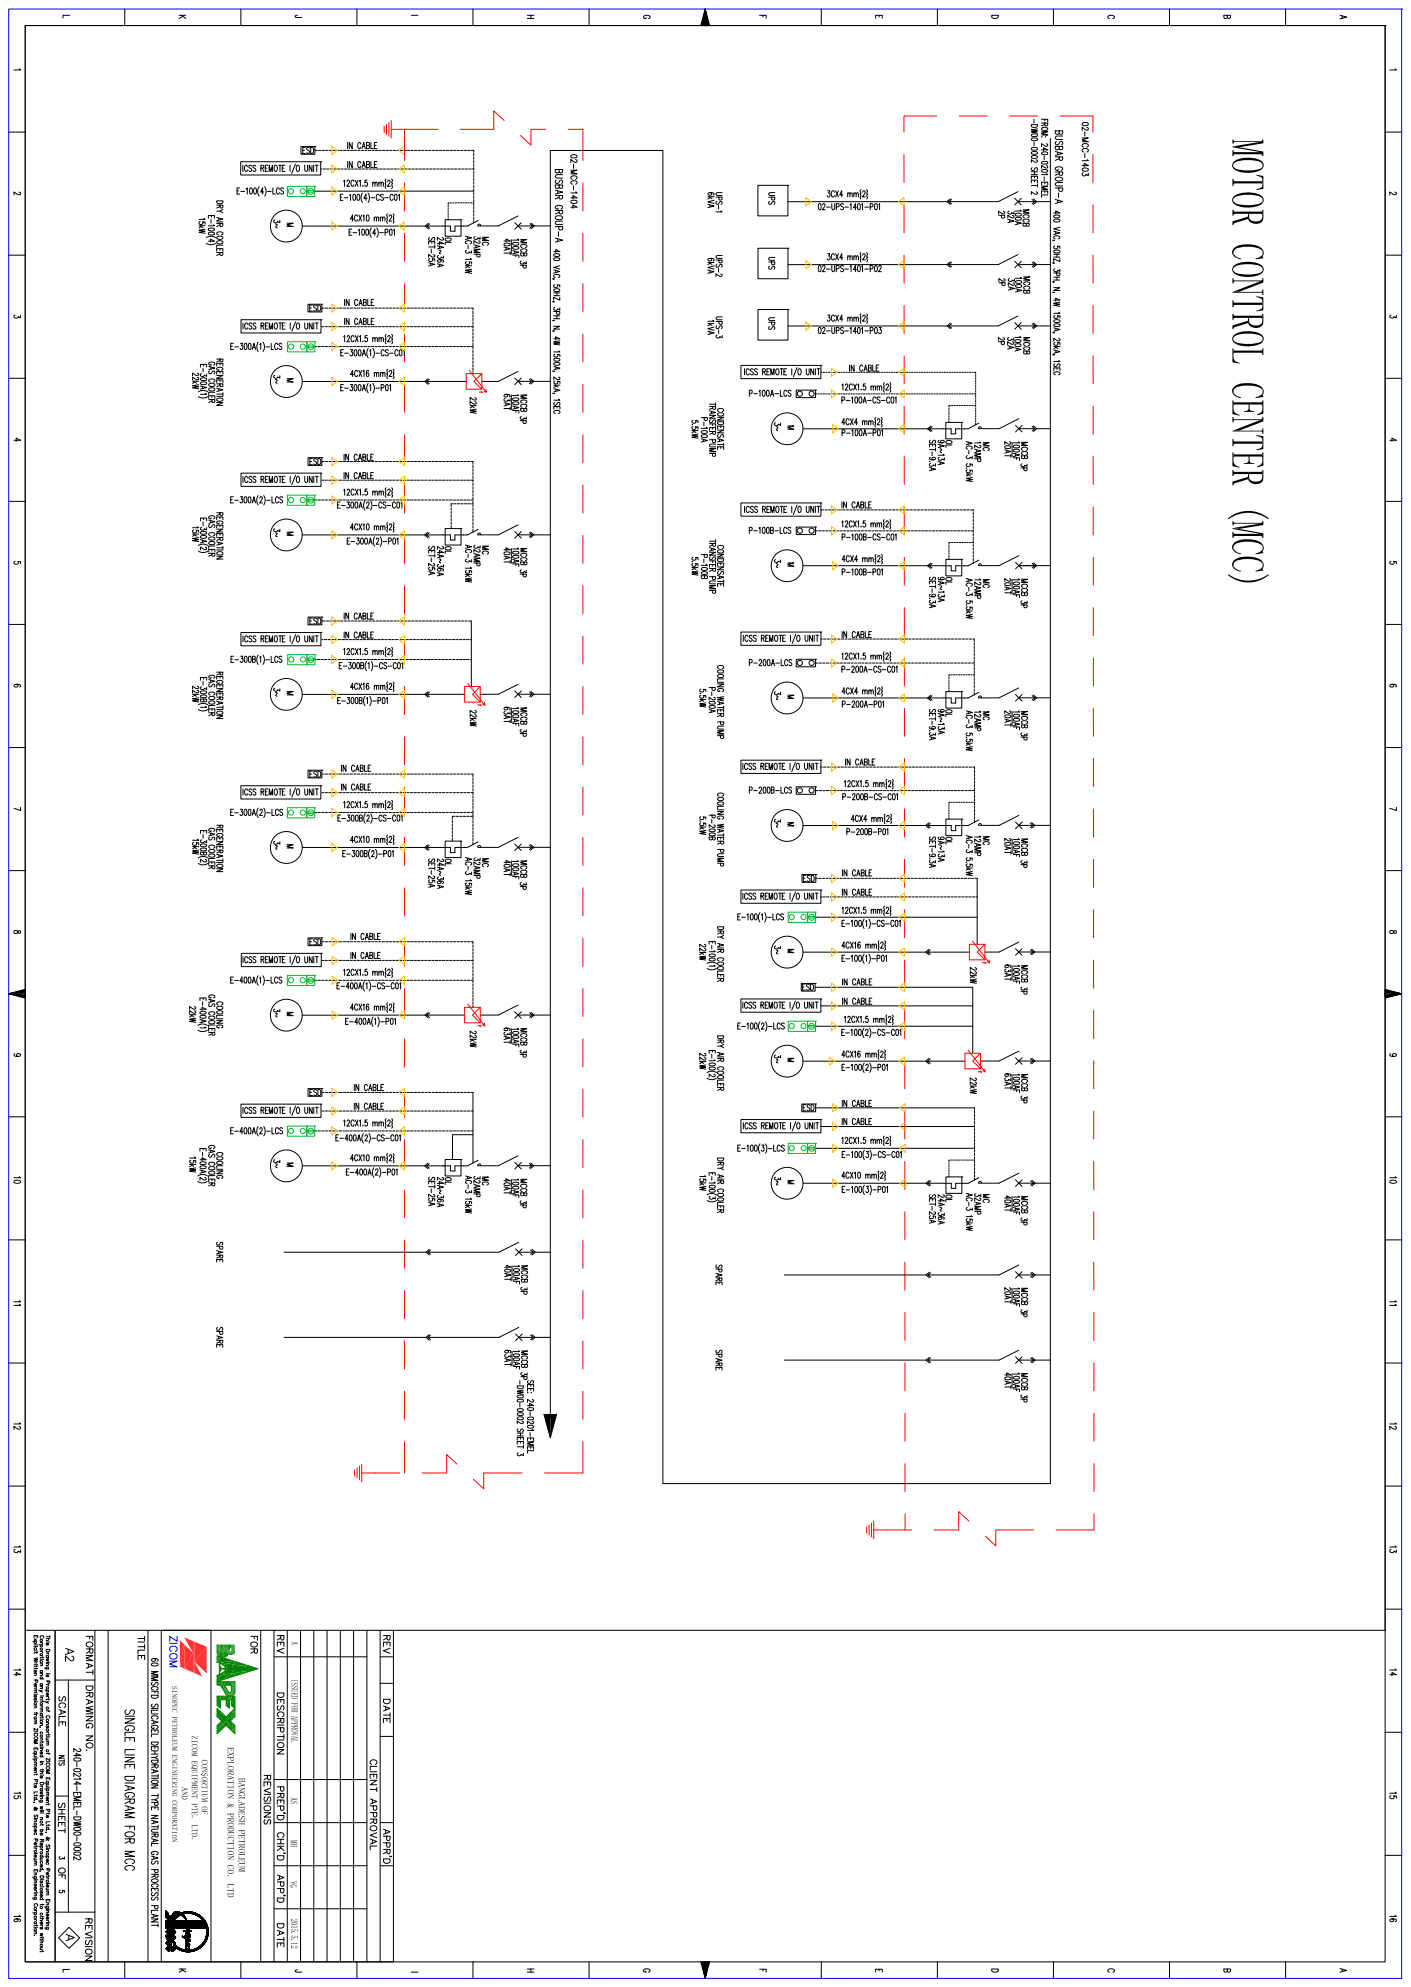
[picture p23: page 4]

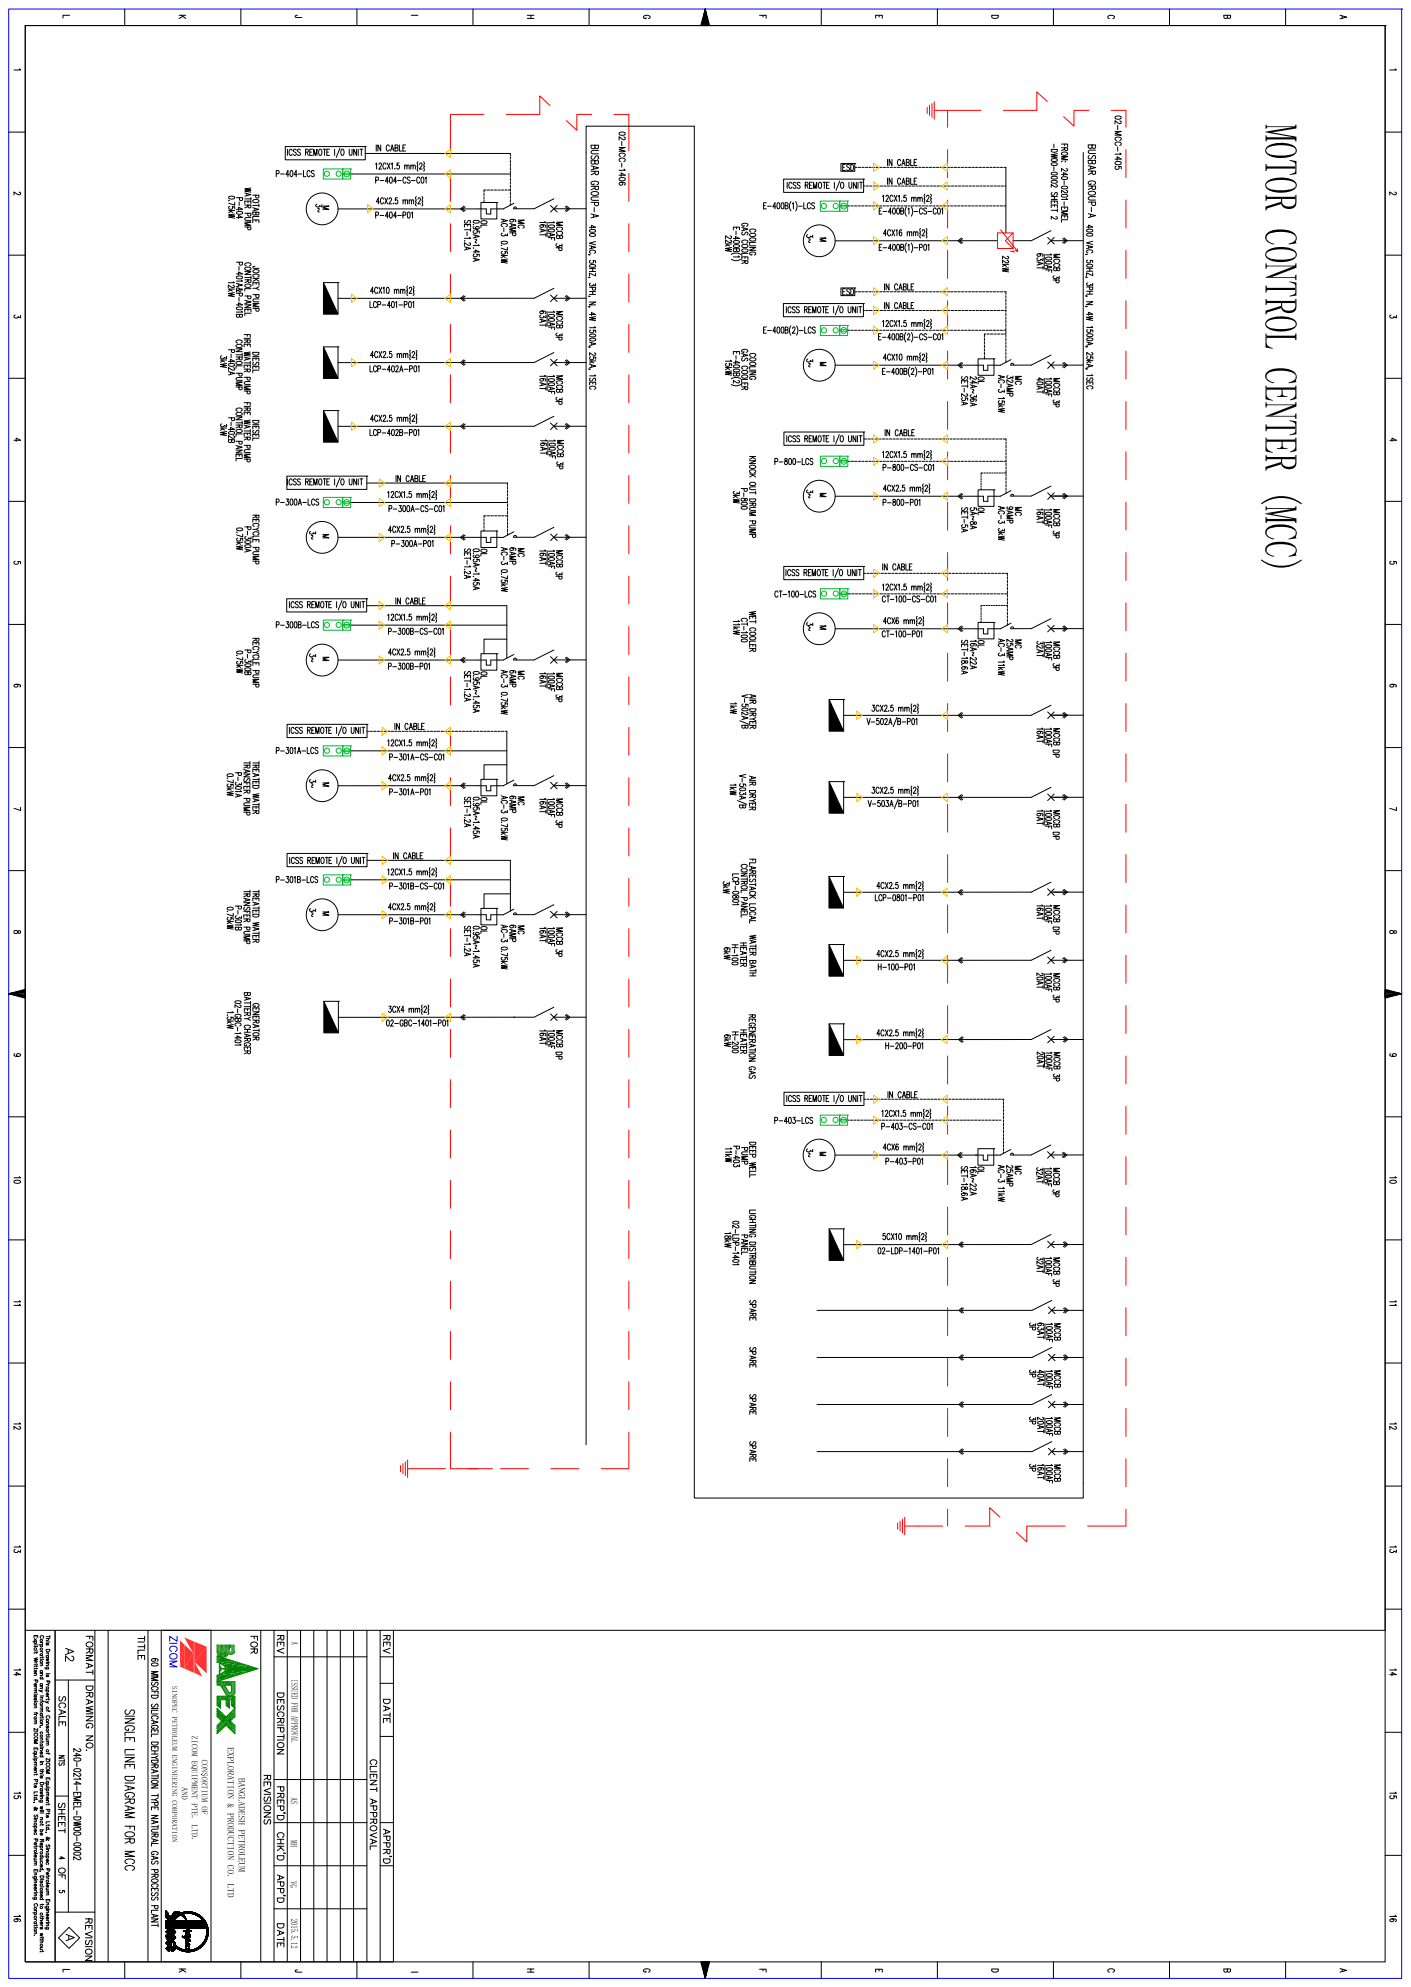
[picture p24: page 5]

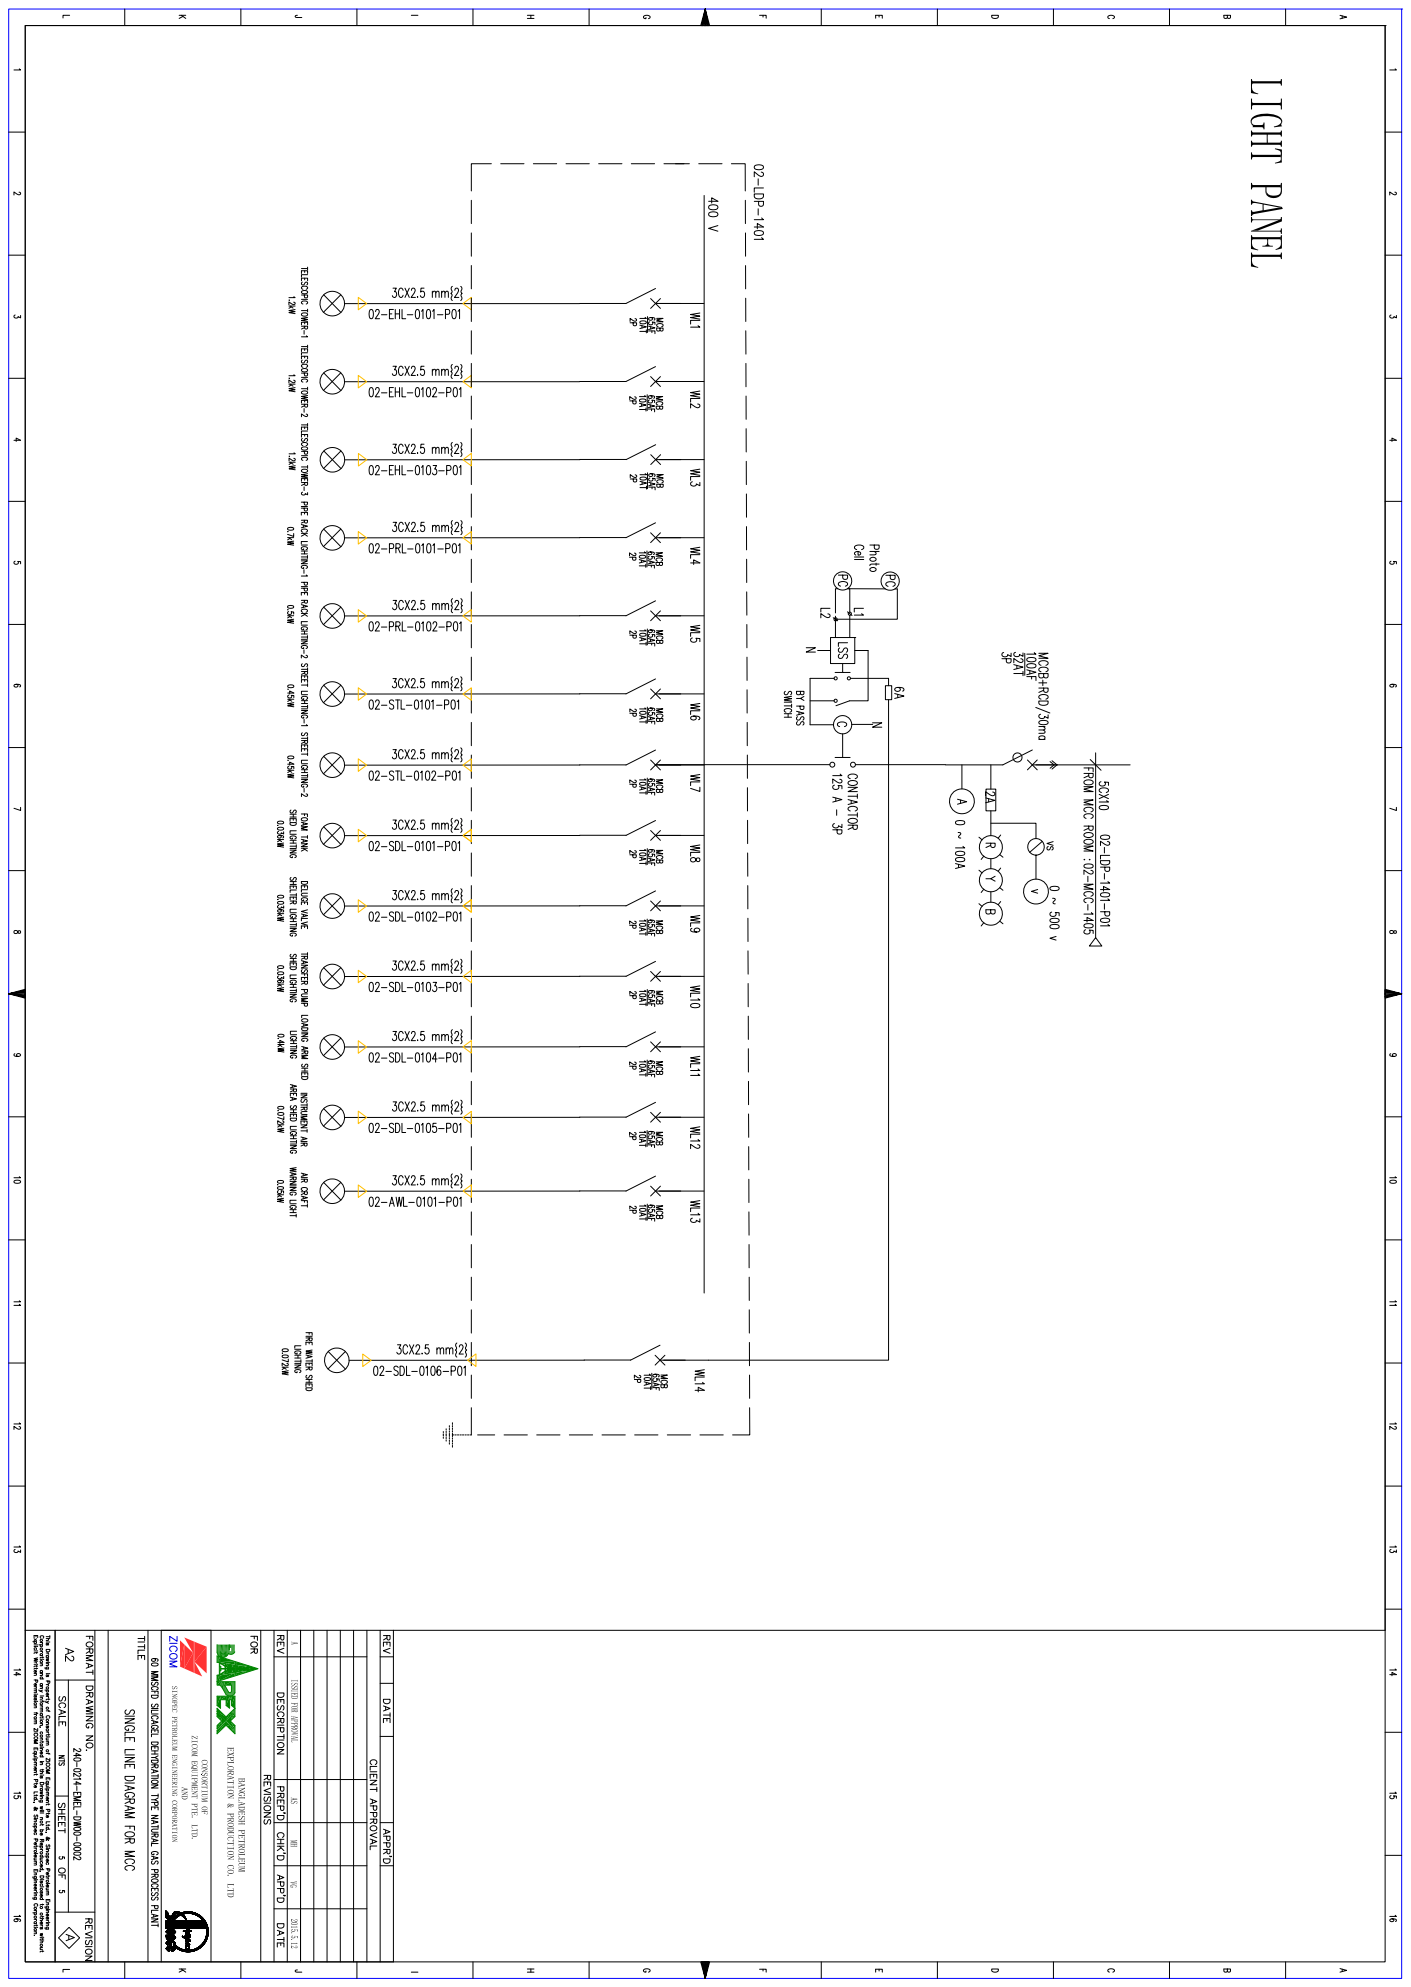
[picture p25: page 6]
