skdzicombd/P_240_Autocad_Docs/Single Line Diagrams (SLD)/240-0214-EMEL-DW00-0003_A - Single Line Diagram for Normal and Emergency Light.pdf

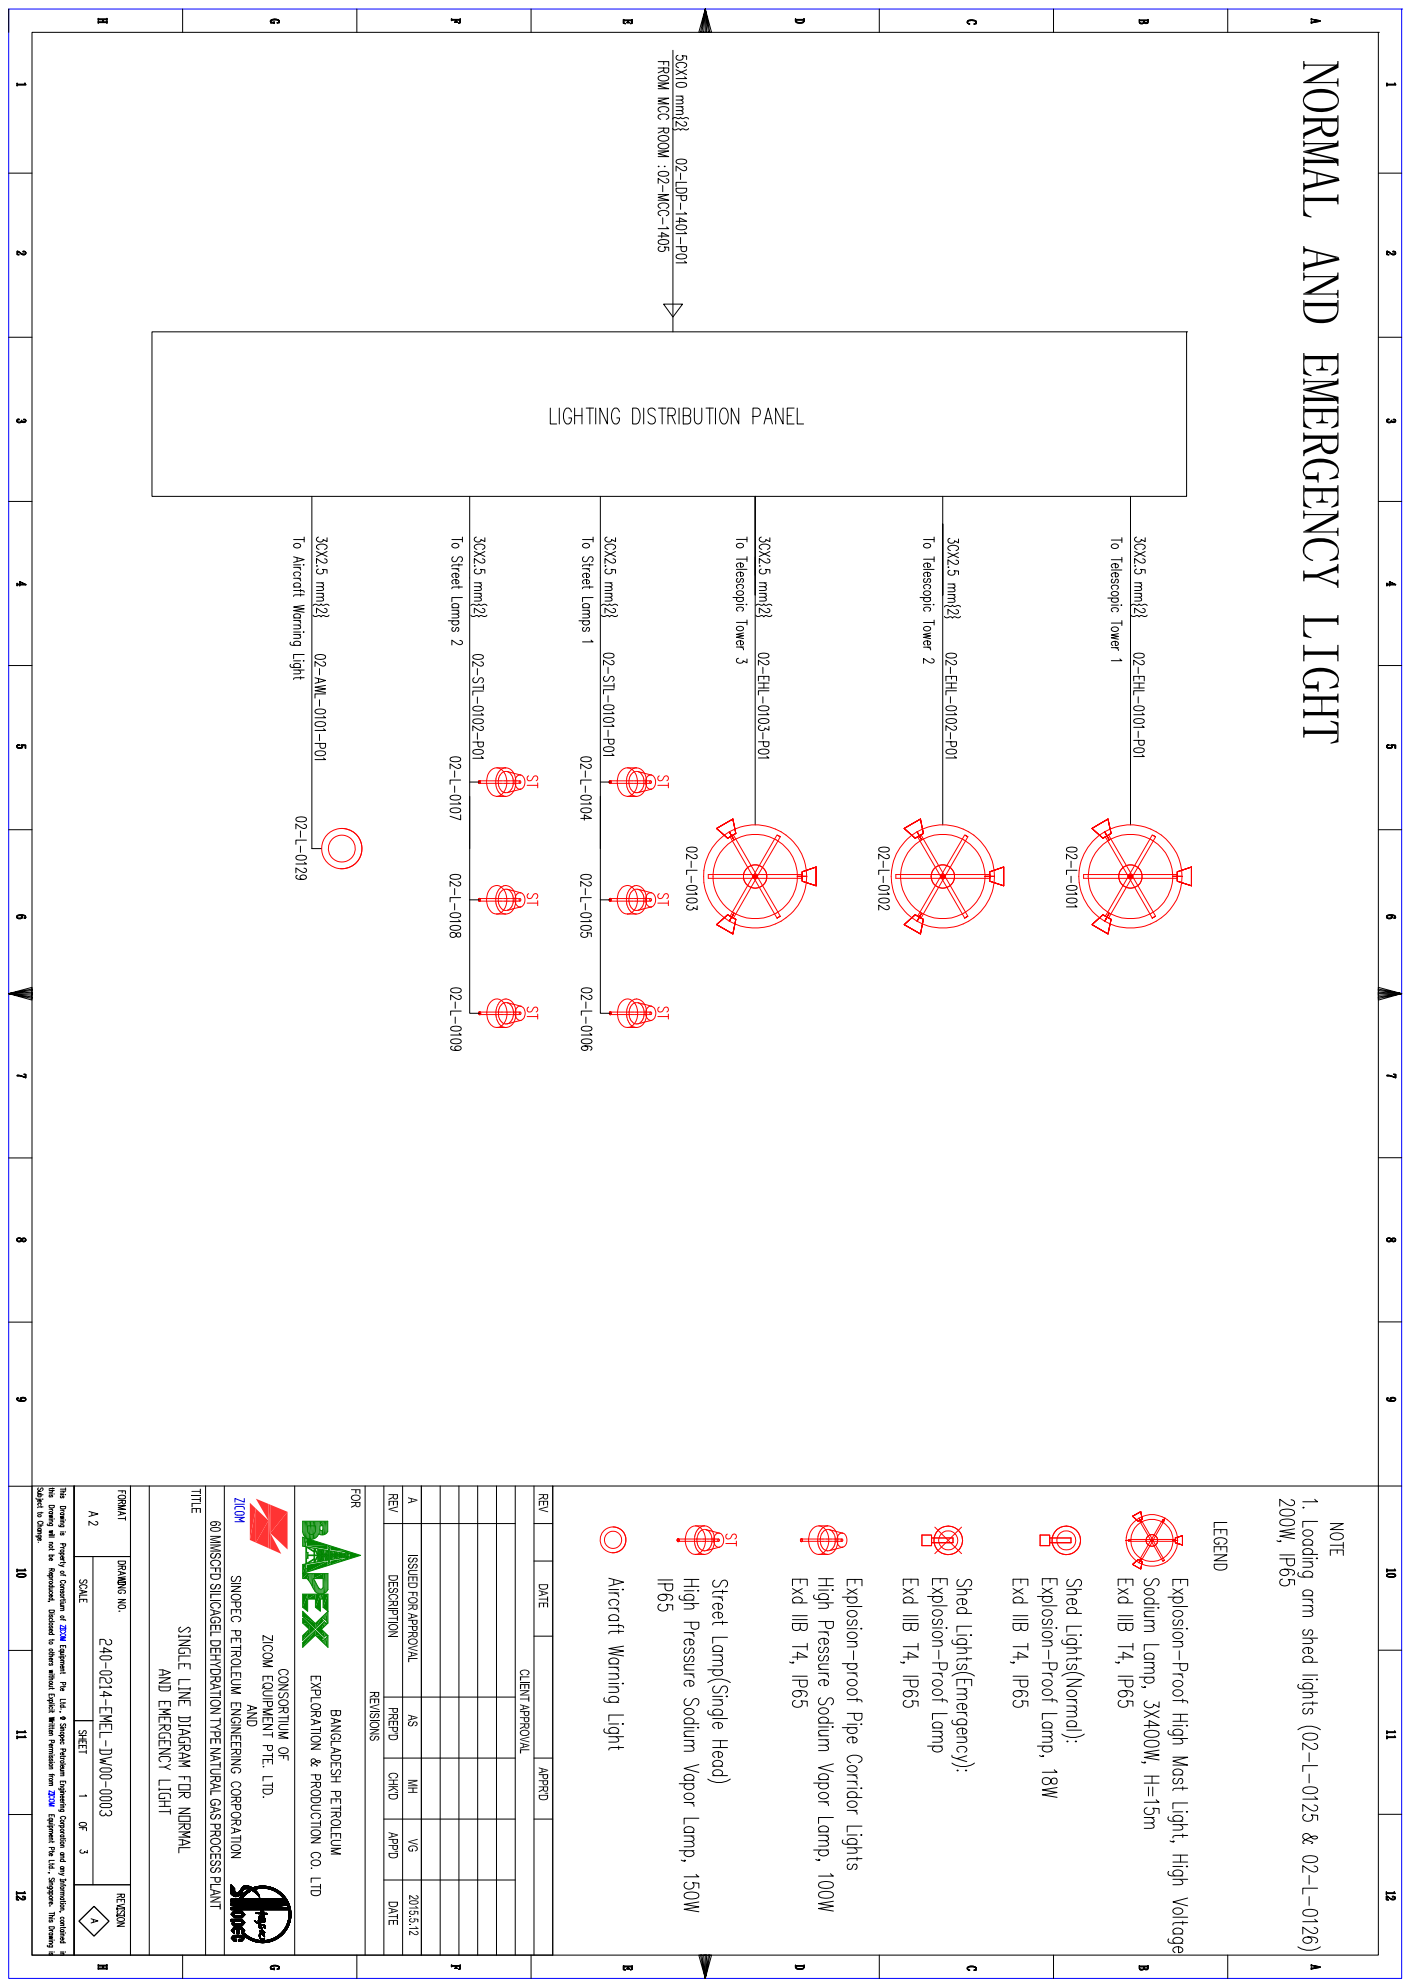
[picture p26: page 1]

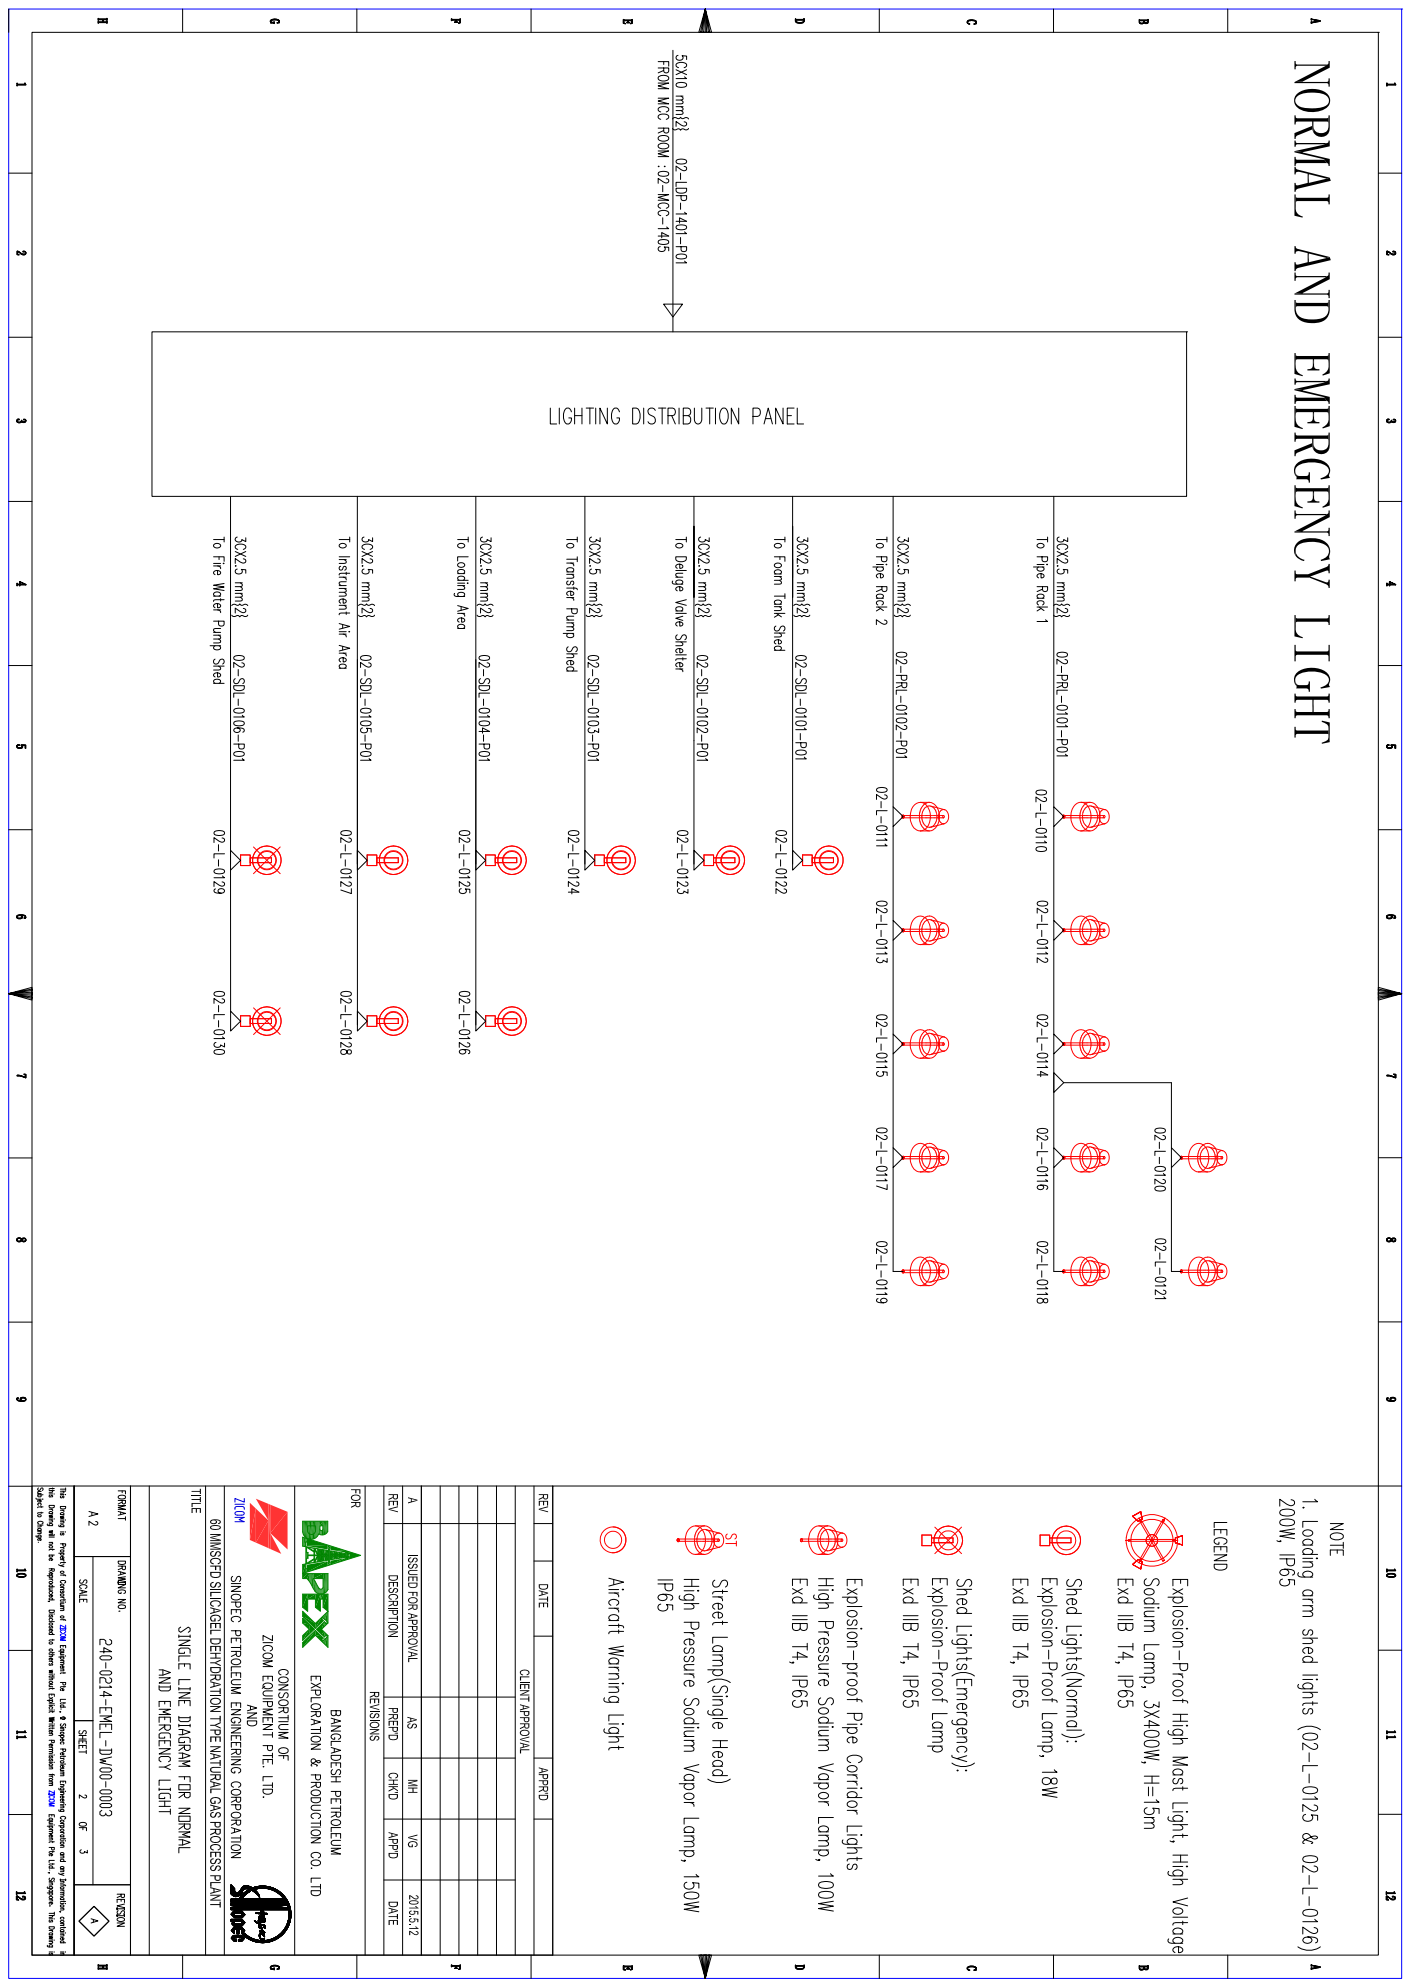
[picture p27: page 2]

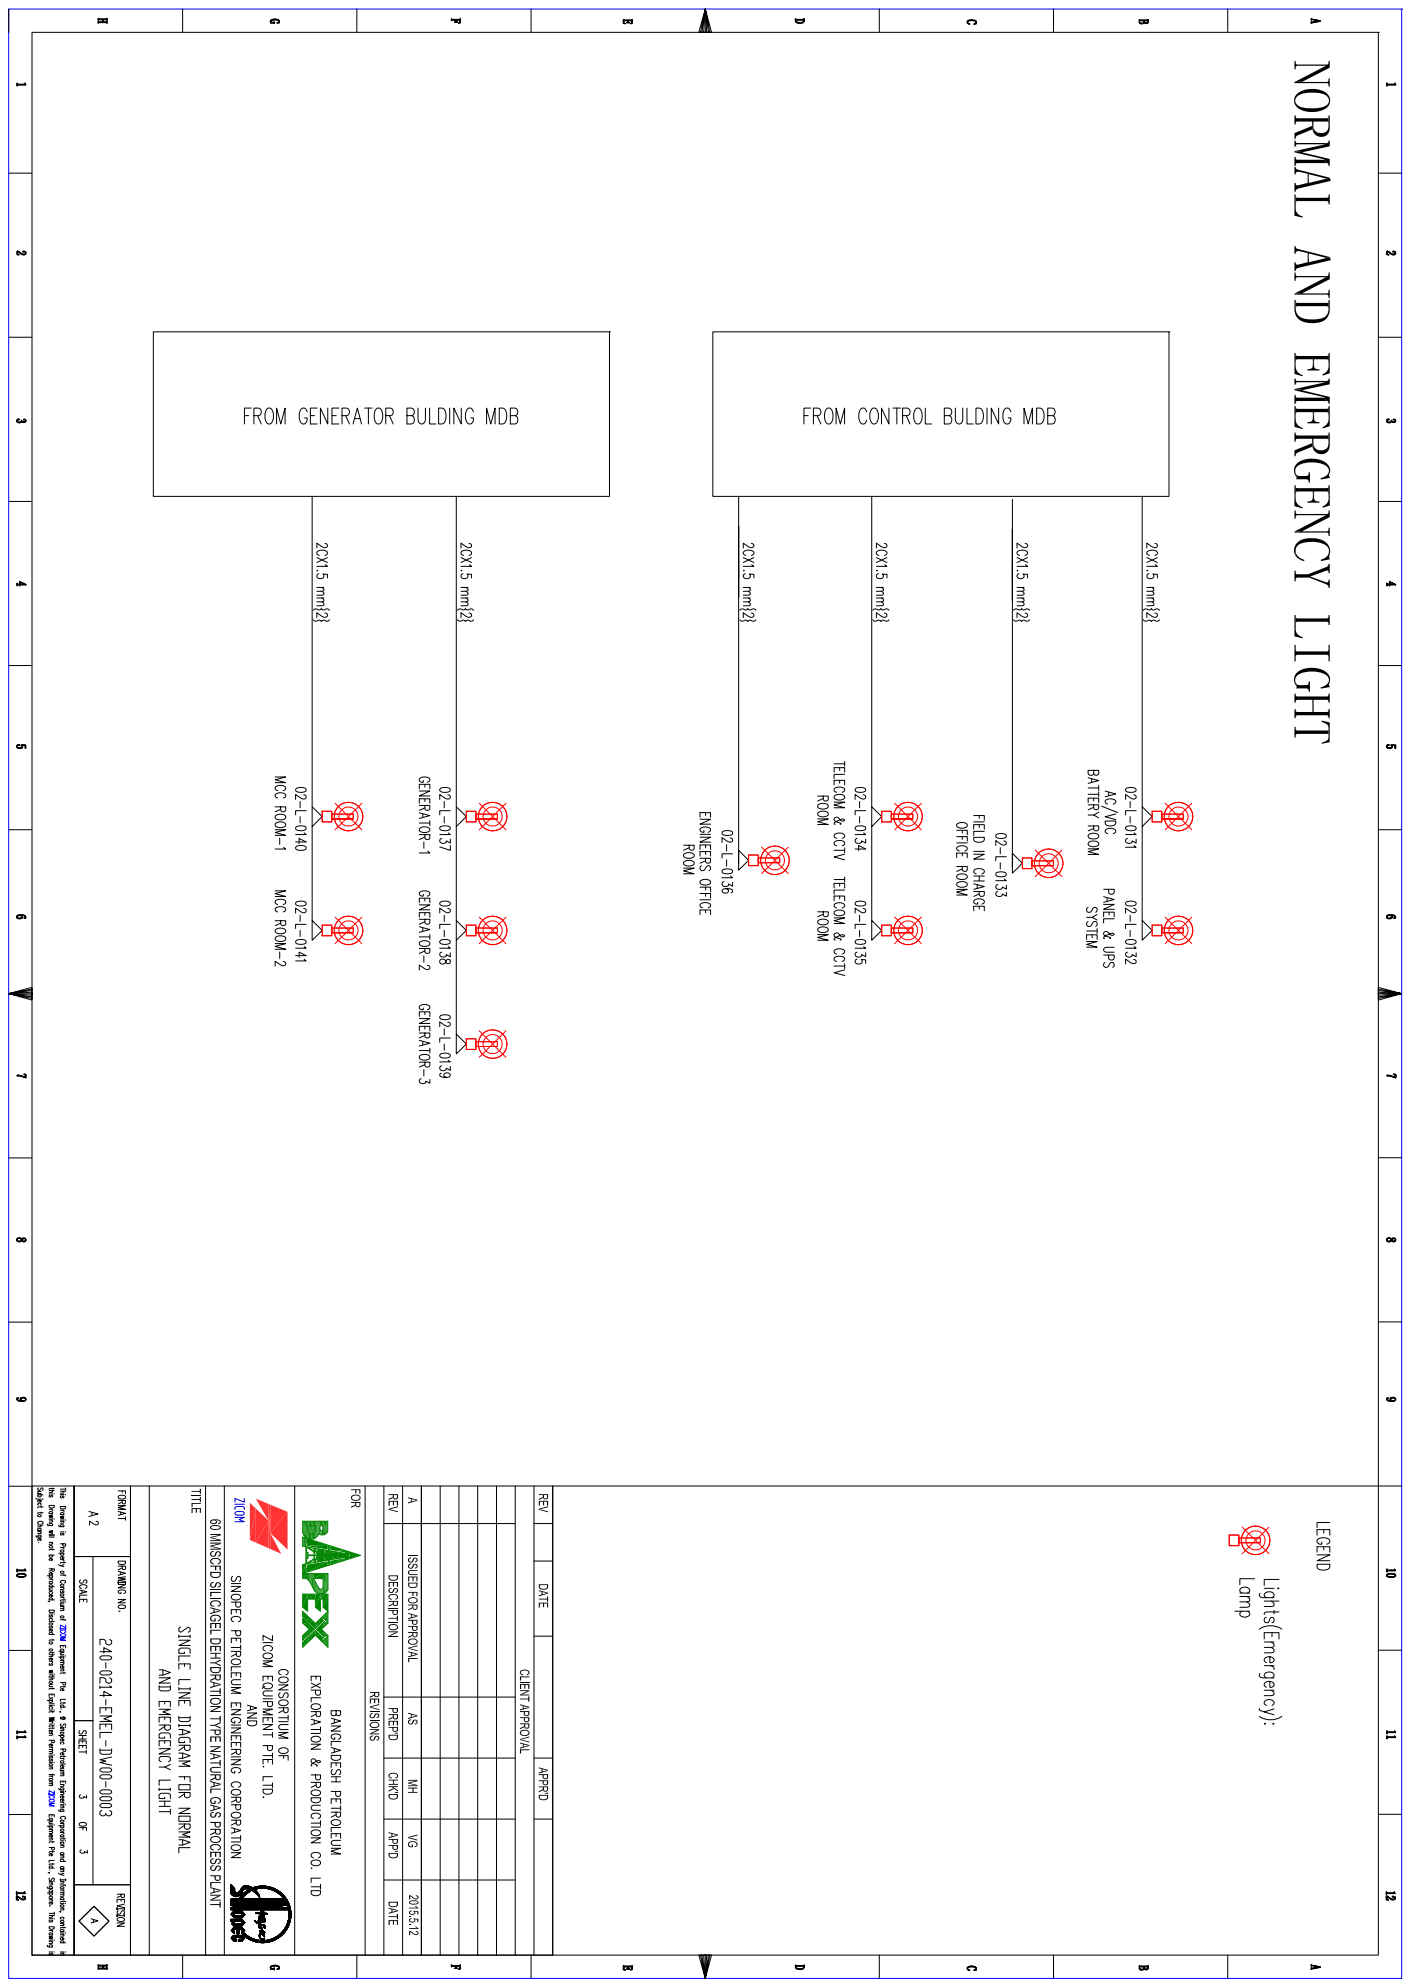
[picture p28: page 3]
