skdzicombd/P_240_Autocad_Docs/Single Line Diagrams (SLD)/240-0214-EMEL-DW00-0006_A - Single Line for UPS.pdf

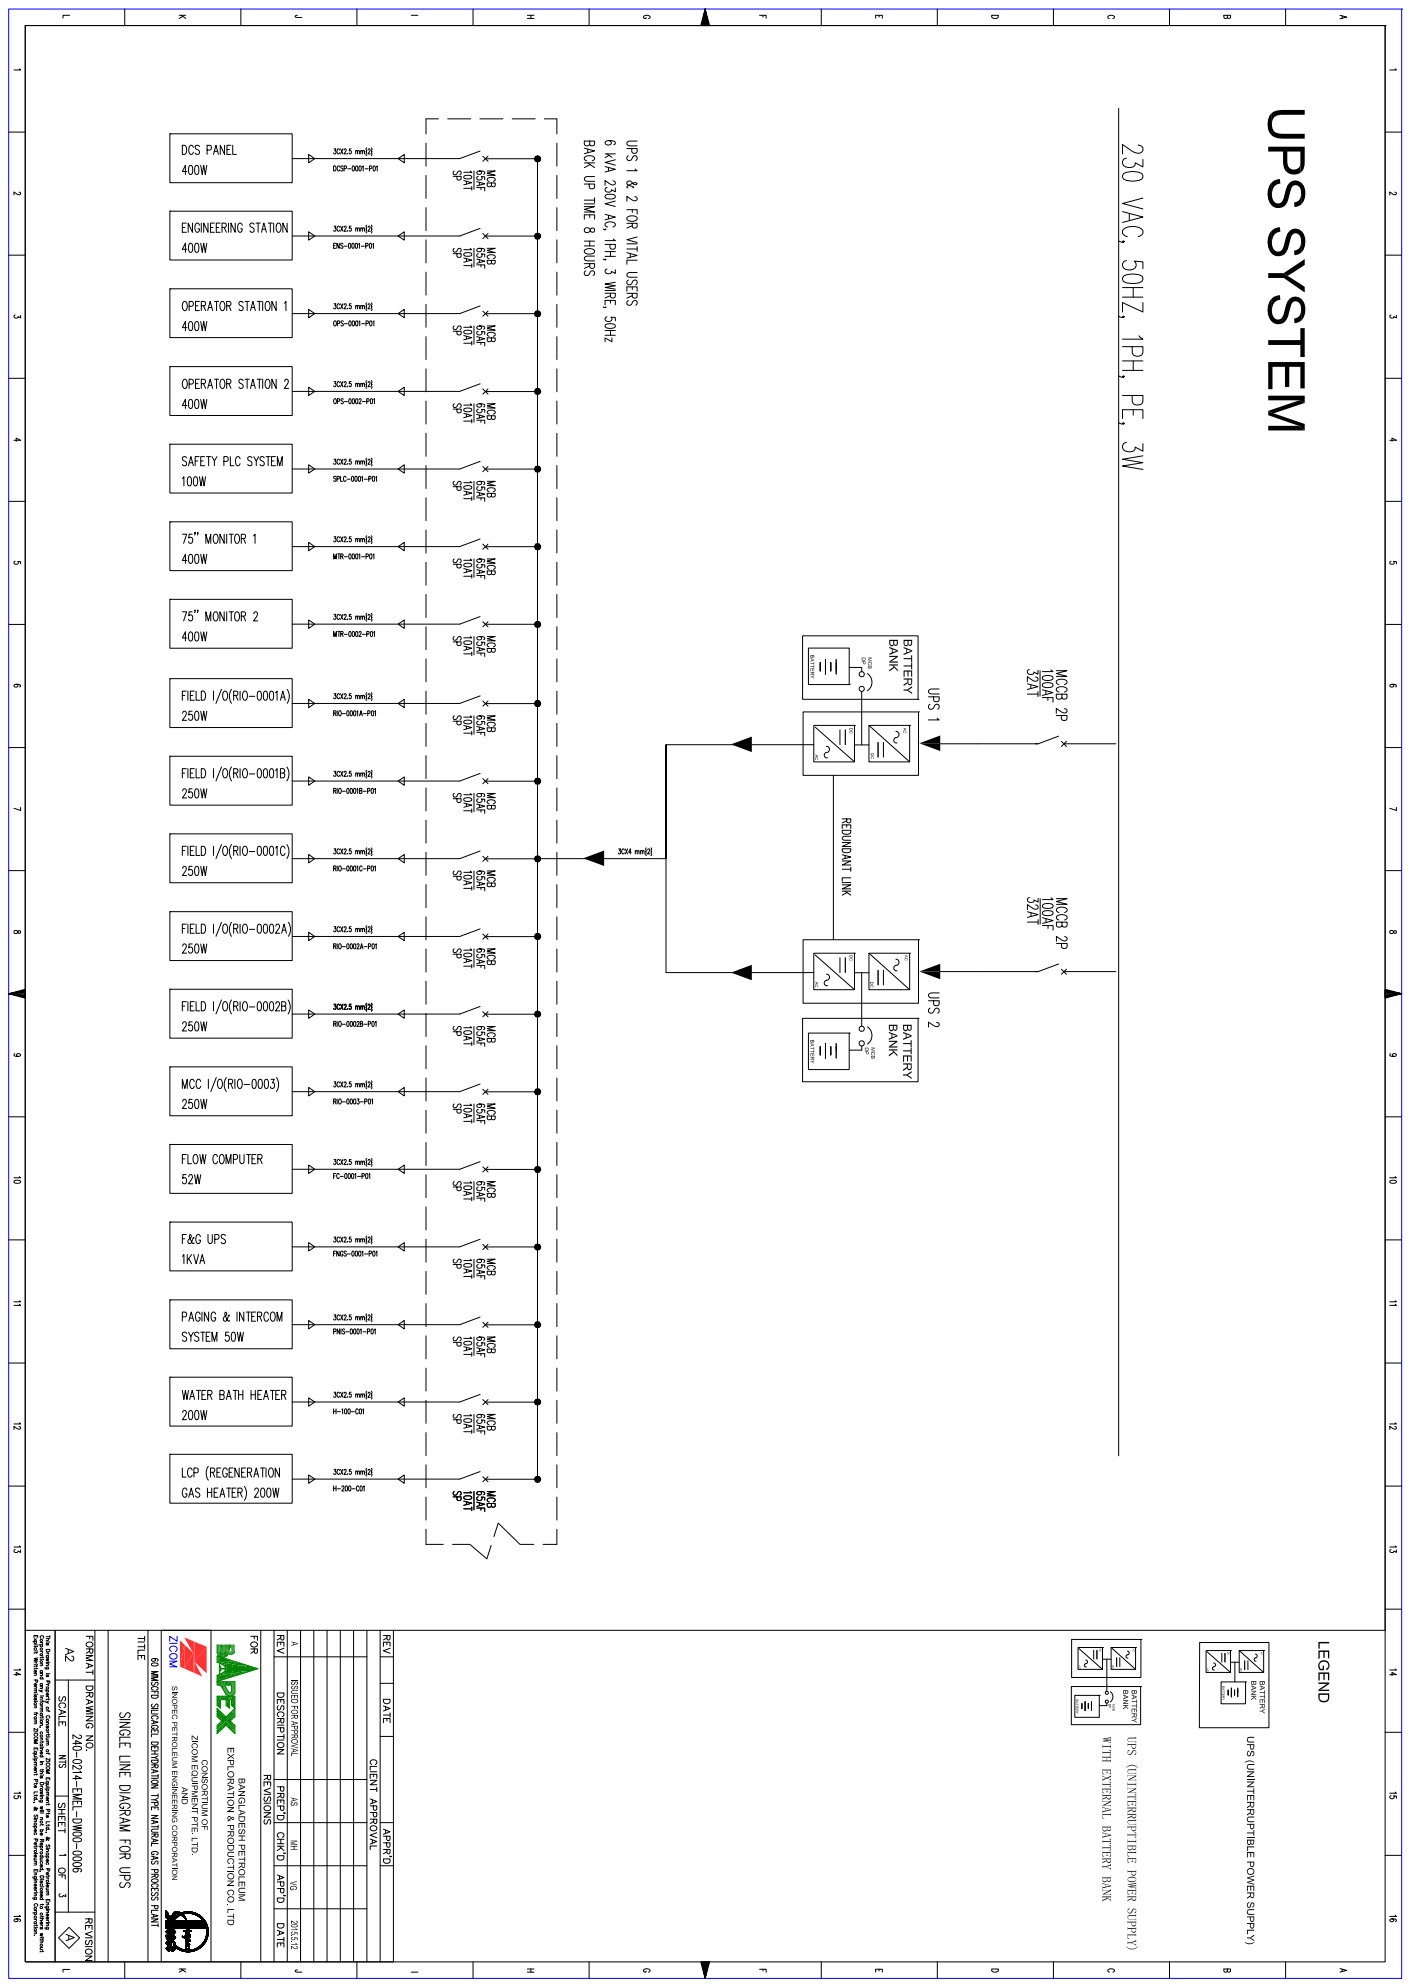
[picture p29: page 1]

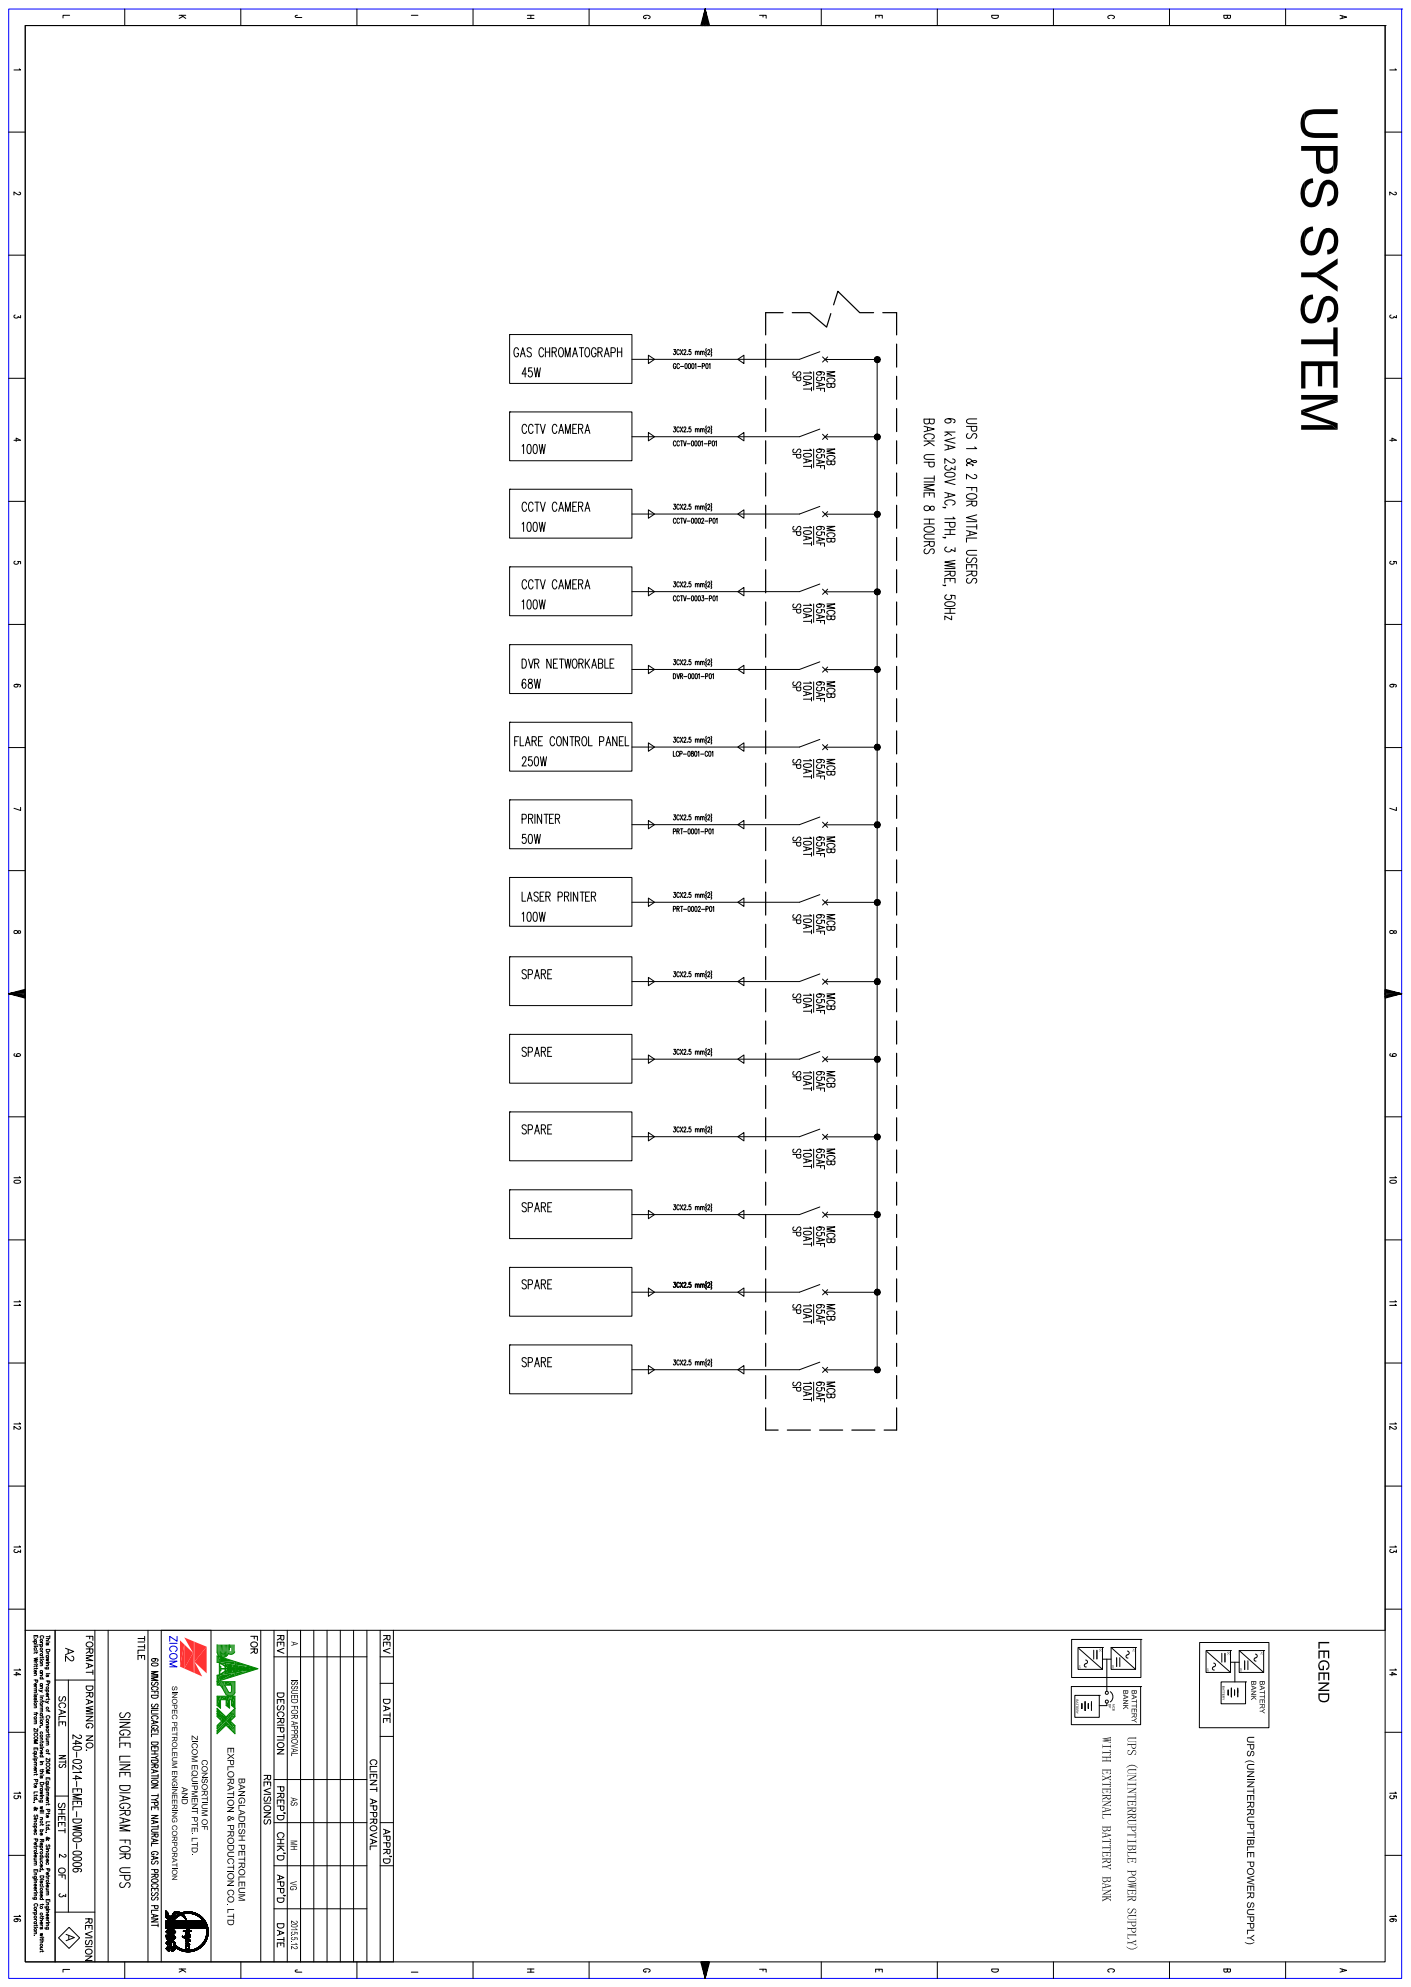
[picture p30: page 2]

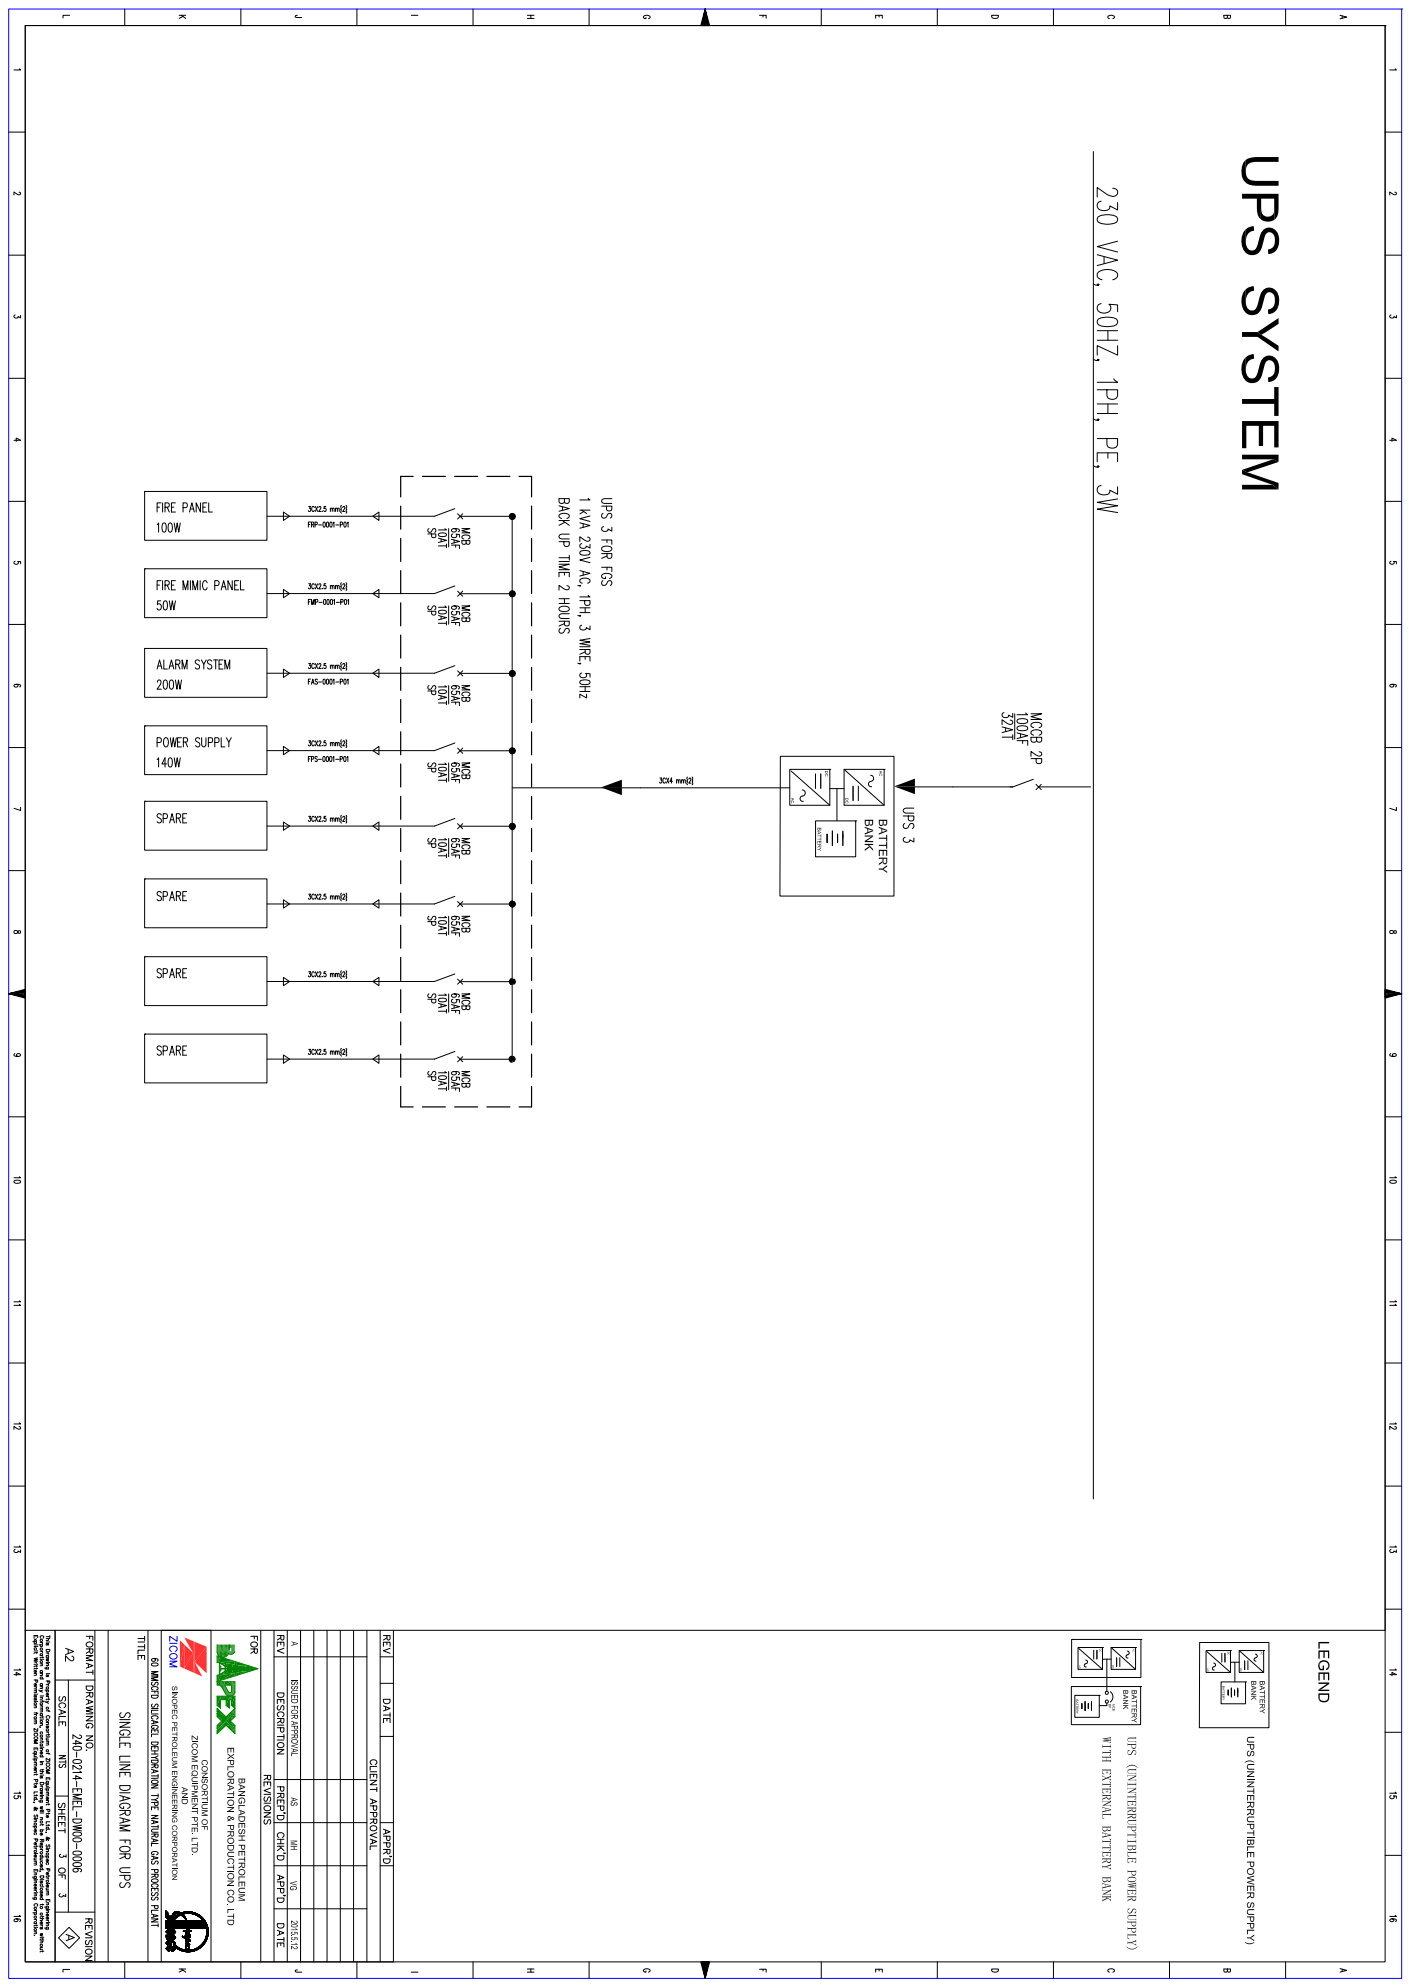
[picture p31: page 3]
