skdzicombd/P_240_Autocad_Docs/Single Line Diagrams (SLD)/240-0214-EMEL-DW00-0008_A - Power Distribution System.pdf

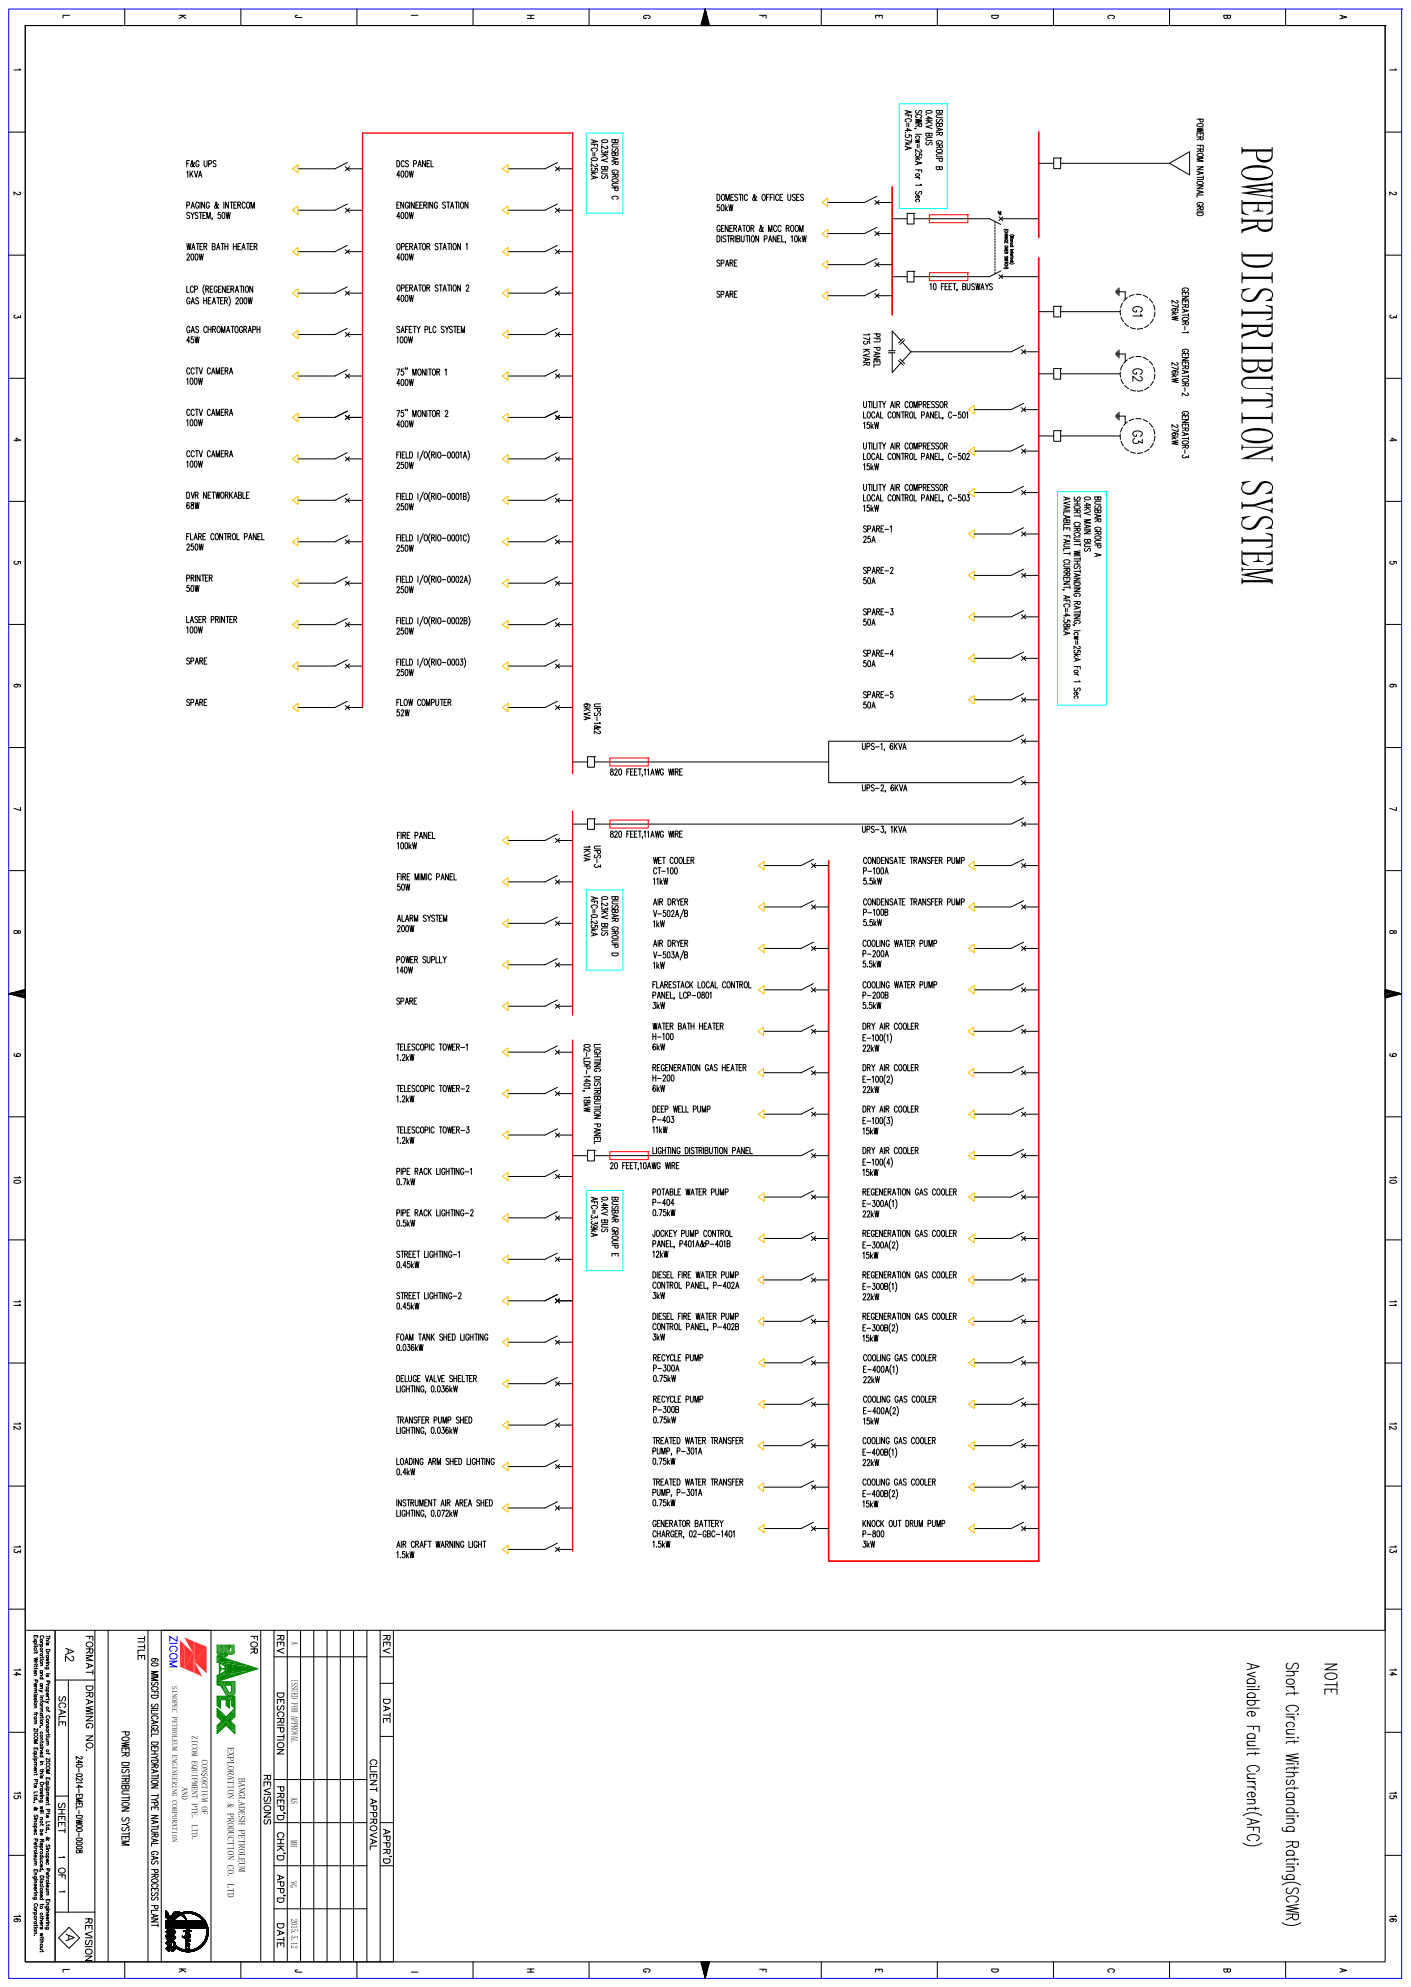
[picture p32: page 1]
