skdzicombd/P_240_Autocad_Docs/(commit log)

2015-11-16 Revision A
    Documents Submitted to client for Approval
    [240-0201-EMEL-DW00-0001-A Electrical Cable Route Layout.dwg, 240-0201-EMEL-DW00-0002 Lighting System Layout.dwg, 240-0201-EMEL-DW00-0004 Earthing Layout.dwg, 240-0214-EMEL-CS00-0001 GENERATOR SIZING.xlsx, 240-0214-EMEL-CS00-0008 FAULT LEVEL CALCULATION.xlsx, 240-0214-EMEL-DW00-0003 SINGLE LINE DIAGRAM FOR NORMAL AND EMERGENCY LIGHT.dwg, 240-0214-EMEL-DW00-0006 SINGLE LINE DIAGRAM FOR UPS.dwg, P-2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]
2015-11-16 Updated Date
    Date changed from 28.10.2015 to 12.5.2015
    [240-0201-EMEL-DW00-0001-A Electrical Cable Route Layout.dwg, 240-0201-EMEL-DW00-0002 Lighting System Layout.dwg, 240-0201-EMEL-DW00-0004 Earthing Layout.dwg, 240-0214-EMEL-DW00-0003 SINGLE LINE DIAGRAM FOR NORMAL AND EMERGENCY LIGHT.dwg, 240-0214-EMEL-DW00-0006 SINGLE LINE DIAGRAM FOR UPS.dwg]
2015-11-16 PDF generation or drawings only
    [240-0201-EMEL-DW00-0001-A Electrical Cable Route Layout.dwg, 240-0201-EMEL-DW00-0002 Lighting System Layout.dwg, 240-0201-EMEL-DW00-0004 Earthing Layout.dwg, 240-0214-EMEL-DW00-0003 SINGLE LINE DIAGRAM FOR NORMAL AND EMERGENCY LIGHT.dwg, 240-0214-EMEL-DW00-0006 SINGLE LINE DIAGRAM FOR UPS.dwg]
2015-11-16 MCC Datasheet Added
    [240-0101-EMEL-DS00-0003 Rev A MCC.xlsx]
2015-11-16 Changed Dates on Datasheets
    Changed from 28.10.2015 to 12.5.2015
    [240-0101-EMEL-DS00-0003 Rev A MCC.xlsx, 240-0214-EMEL-CS00-0001 GENERATOR SIZING.xlsx, 240-0214-EMEL-CS00-0008 FAULT LEVEL CALCULATION.xlsx, P-240 CABLE SCHEDULE 11.11.15.xlsx]
2015-11-17 Zoom out Test
    [240-0201-EMEL-DW00-0001-A Electrical Cable Route Layout.dwg]
2015-11-17 240 BOQ Added
    [P-240 CABLE SIZING & BOQ 17.11.15.xlsx]
2015-11-17 Removed .bak files and fixed page size of Cable Schedule
    [P-240 CABLE SCHEDULE 11.11.15.xlsx, P-240 CABLE SIZING & BOQ 17.11.15.xlsx]
2015-11-19 Changed Filenames to Match Standard
    [240-0101-EMEL-DS00-0003 Rev A MCC.xlsx, 240-0201-EMEL-CL00-0001_A - Power Cable Schedule.xlsx, 240-0201-EMEL-DW00-0001_A - Electrical Cable Route Layout.dwg, 240-0201-EMEL-DW00-0002_A - Lighting System Layout.dwg, 240-0201-EMEL-DW00-0004_A - Earthing Layout.dwg, 240-0214-EMEL-DW00-0003_A - Single Line Diagram for Normal and Emergency Light.dwg, 240-0214-EMEL-DW00-0006_A - Single Line for UPS.dwg]
2015-11-25 Added Building Electrical System Design
    Generator building and Control Building Electrical System Designs added
    to repository.
    [240-0201-EMEL-DW00-0006 Design of Building Electrical System, Control Building.dwg, 240-0201-EMEL-DW00-0006 Design of Building Electrical System, Generator Building.DWG]
2015-11-25 Added Datasheet Submitted to Vendor and Separated the Specifications for ease of access
    [240-0101-EMEL-DS00-0003 Rev A MCC.xlsx, 240-0201-EMEL-CL00-0001_A - Power Cable Schedule.xlsx, 240-0214-EMEL-CS00-0001 GENERATOR SIZING.xlsx, 240-0214-EMEL-CS00-0008 FAULT LEVEL CALCULATION.xlsx, 240-0301-EMEL-DS00-0002 DATASHEET FOR LCS.xlsx, 240-0301-EMEL-DS00-0005 LIGHT DATASHEET.xlsx]
2015-11-25 Added Power Cable BOQ which was submitted to Romel Bhai
    [P-240 Power Cables Revised (2).xlsx]
2015-11-29 Minor Changes and Clean-up
    [240-0201-EMEL-DW00-0004_A - Earthing Layout.dwg]
2015-12-13 Generated PDFs
    [240-0201-EMEL-DW00-0006 Design of Building Electrical System, Control Building.dwg]
2015-12-15 Fixed the Scale of the Plot Layout in the Earthing Diagram
    [240-0201-EMEL-DW00-0004_A - Earthing Layout.dwg, 240-0201-EMEL-DW00-0006 Design of Building Electrical System, Generator Building.DWG]
2016-01-05 Building wiring diagram of fire system
    autocad file and BOQ included
    [P-240 Fire Detection and Alarm System.dwg, P240 -BOQ.xlsx]
2016-01-27 Updated Design of Building Electrical Systems
    [240-0201-EMEL-DW00-0006 Design of Building Electrical System, Control Building.dwg, P-240 CABLE SIZING & BOQ 17.11.15.xlsx]
2016-01-27 Updated changes to Cable Trenches for the overall plant layout
    Trenches added near Control Building and rerouted near the Generator
    Building due to obstacles discovered at site
    [240-0201-EMEL-DW00-0001_A - Electrical Cable Route Layout.dwg]
2016-02-15 Adjusted cable trench position near Generator Building
